torbenmehner/Masterarbeit/06_Zwischenvortrag/FZI-Beamer_Vorlage_Latex_v0.5/FZI-Beamer Vorlage Latex v0.5/paper.tex

\documentclass[18pt]{beamer}
\usepackage{templates/theme}

% title and author
	\title[Short title]{Herzlich willkommen!}
	\subtitle{Something for XYZ 2009}
	\author{Firstname1 Lastname1, Firstname2 Lastname2}

% configuration of slides
	\titlelogo{FZI-Logo}								% logo on title slide and normal slides
	%\titlelogo{none}
	\setboolean{normallogo}{true}				% show title logo on normal slides?
	\titlepicture{fzi-front}						% picture on title slide
	%\titlepicture{none}	
	\setboolean{nav}{true}							% show navigation bar?
	\setboolean{titlebar}{true}					% show green bar on title slide?
	\setboolean{normalbar}{true}				% show green bar on normal slides?
	\setboolean{normalcaptions}{true}		% show captions on normal slides?
	\setboolean{innBW}{true}						% show innBW logo on normal slides?
	\setboolean{minimalism}{false}			% minimalism mode? disables all the fancy things at once!

% biliography
	\addbibresource{bib.bib}

\input{templates/slide_config}

\begin{document}
% remove the following line for German date style
%\selectlanguage{english}
% uncomment the following line to set a fixed date
%\date{festes Datum}

%title page
\begin{frame}
\titlepage
\end{frame}
\section{Section1}
\subsection{}
\begin{frame}
\frametitle{Farben}
	Unterschiedliche Farben:
\begin{columns}

	\column{0.5\textwidth}
	\begin{itemize}
		\item \textcolor{fzi-green}{FZI grün}
		\item \textcolor{fzi-gray}{FZI grau}
		\item \textcolor{fzi-gray-hol}{HOL grau}
		\item \textcolor{fzi-foerververein}{Förderverein}
		\item \textcolor{fzi-control}{Smart Control}
		\item \textcolor{fzi-aal}{AAL}
		\item \textcolor{fzi-automotive}{Automotive}
	\end{itemize}
	
	\column{0.5\textwidth}
	\begin{itemize}
		\item \textcolor{fzi-mobile}{Mobile IT}
		\item \textcolor{fzi-robot}{Service Robotics}
		\item \textcolor{fzi-automation}{smartAutomation}
		\item \textcolor{fzi-energy}{smartEnergy}
		\item \textcolor{fzi-home}{smartHome}
		\item \textcolor{fzi-mobility}{smartMobility}	
	\end{itemize}

	\end{columns}

\end{frame}

\section{Section2}
\subsection{}
\begin{frame}
\frametitle{Title}
\begin{columns}
	\column{0.5\textwidth}
		$$\sum_{i=1}^{\infty} \frac{1}{4\pi x^i}$$

	\column{0.5\textwidth}
		\begin{itemize}
			\item two columns
		\end{itemize}
	\end{columns}
\begin{center}
\end{center}
\end{frame}

\begin{frame}
 \frametitle{Grafik einbinden}

 \begin{center}
  %\includegraphics[height=0.6\textheight]{logos/FZI-logo.pdf}
 \end{center}
\end{frame}

\begin{frame}
 \frametitle{Eine kleine TikZ Grafik}

 \begin{center}
 \begin{tikzpicture}
  \draw[darkgray, fill=fzi-mobility!50] (-1,0) .. controls +(2,0.3) and +(-2, -0.1) .. (5, 4) node[midway, sloped, below] {arrival} -- (7.5, 4) -- (7.5, 0);
  \visible<2->{\draw[darkgray, fill=fzi-home!50] (1, 0) -| (1, 0.3) -| (2, 0.7) -| (2.5, 1.3) -| (3.2, 1.7) -| (4, 2) -| (5.5, 2.5) -| (6, 3.2) -- (7.5, 3.2) -- (7.5, 0);}
  \visible<2->{\node[darkgray] at(5, 1) {packed};}

  \draw[-latex] (-2, 0) -- (8, 0) node[below] {time};
  \draw[-latex] (-1.5, -.5) -- (-1.5, 4.5) node[very near end, sloped, above] {freight};
  \draw[thick, blue] (7, 4.5) -- +(0, -5) node[below] {STD};
  \draw[thick, blue] (5, 4.5) -- +(0, -5) node[below] {LAT};

 \end{tikzpicture}
 \end{center}
\end{frame}

\begin{frame}
 \frametitle{Textblöcke}

 \begin{block}{Block}
   lorem ipsum
 \end{block}
 \vspace{2.0ex}

 \begin{exampleblock}{Example Block}
   lorem ipsum
 \end{exampleblock}
 \vspace{2.0ex}

 \begin{alertblock}{Alert Block}
   lorem ipsum
 \end{alertblock}
 
\end{frame}

\subsection{}
\begin{frame}
\frametitle{Ein Literaturverweis}
\begin{center}
	Entropie~\cite{shannon48}
\end{center}
\end{frame}

\subsection{}
\begin{frame}
\frametitle{Ende}
\begin{center}
	fin.
\end{center}
\end{frame}

\section{Literatur}
\subsection{}
\begin{frame}
\frametitle{References}
\printbibliography 
\end{frame}

\end{document}
