torbenmehner/Masterarbeit/09_Ausarbeitung/sections/entwurf.tex

%% LaTeX2e class for student theses
%% sections/content.tex
%% 
%% Karlsruhe Institute of Technology
%% Institute for Program Structures and Data Organization
%% Chair for Software Design and Quality (SDQ)
%%
%% Dr.-Ing. Erik Burger
%% burger@kit.edu
%%
%% Version 1.3, 2016-12-29

\chapter{Entwurf}
\label{ch:entwurf}

\section{Anforderungsanalyse}

\subsection{Sonarboot}

Die Aufgabe des Sonarboots ist es, möglichst genau einem Suchmuster zu folgen. Dazu muss es die aktuelle mit der gewollten Position abgleichen und den Fahrbefehl entsprechend anpassen.
