torbenmehner/Masterarbeit/09_Ausarbeitung/thesis.pdf

# 1. Einleitung

# 1.1. Stand der Technik

# 1.1.1. Sonarboot

Die Idee dieser Arbeit kommt aus der Wasserrettung. 66% aller Einsätze des DLRG Lan-

desverbands Württemberg im Wasserrettungsdienst sind Personensuchen im Wasser[1].

Für Gewöhnlich schwimmen Taucher dabei einen Bereich mithilfe von Suchmustern ab.

Aufgrund vieler Schwebeteilchen im Wasser ist die Sicht von Tauchern oft unter einen

Meter begrenzt, was die Suche verlangsamt. Doch bei einem Ertrinkungsunfall sinkt die

Überlebenswahrscheinlichkeit in jeder Minute, die ein Mensch unter Wasser ist [2, 3].

Daher läuft seit einigen Jahren die Ausstattung der DLRG mit Sonargeräten, die auch

bei schlechten Bedingungen einen großen Erfassungsbereich haben. Das beschleunigt die

Suche nach vermissten Personen wesentlich. Da das Sonar auf Einsatzbooten angebracht

ist, vergeht eine Menge Zeit bis zum Beginn der Suche. Der gesamte Slipvorgang dauert

mit Anfahrt der Slipstelle bis zu 15 Minuten.

Ein Weg die Zeit bis zum Einsatz des Sonars zu verkürzen, besteht in der Verwendung

eines unbemannten Fahrzeugs. Dieses muss lediglich groß genug sein, um das Sonar zu

transportieren. Daher kann es direkt an der Einsatzstelle zu Wasser gelassen werden, was

wertvolle Minuten spart.

Auf einer Wasseräche ist das Abfahren eines Suchmusters nur mithilfe eines GPS mög-

lich, weil es keine Anhaltspunkte zur Orientierung gibt. Doch auch mit GPS ist das Fahren

entlang des Suchmusters aufgrund von Wind und Strömung nur nach langer Übung zu

meistern. Deshalb soll das Sonarboot die Bereiche selbstständig absuchen.

# 1.1.2. SEC-Bike

Diese Arbeit wird am FZI geschrieben, welches sich im Forschungsbereich Mobilität un-

ter anderem mit Fahrassistenzsystemen beschäftigt. Da Kompetenz in diesem Themenbe-

reich vorhanden ist, werden hier auch Projekte mit autonomen Kleinfahrzeugen gestartet.

Eines dieser Projekte ist das SEC-Bike, welches vom Bundesministerium für Bildung

und Forschung beauftragt wurde. Dieses ist ein elektrisch betriebenes Lastenfahrrad, das

die Lücke der „Letzten Meile“im innerstädtischen Bereich schließt. Es kann vom Nutzer

per Smartphone an einen beliebigen Ort bestellt werden, zu dem es dann autonom fährt[4,

5].

# 1. Einleitung

# 1.2. Ziel der Arbeit

Anstatt zwei Systeme zu bauen, die beide autonom fahren, wird nun ein System entwi-

ckelt, das für beide Aufgaben verwendet werden kann.

# 2. Entwurf

# 3. Evaluation

# 3.1. First Section

# 3.2. Second Section

# 3.3. Third Section

# 4. Conclusion

# Literatur

# [1] DLRG LV Württemberg. Statistik des Wasserrettungsdienstes (WRD) Landesverband

# Württemberg 2017. url: https://wuerttemberg.dlrg.de/retten/einsatz/statistik-

lv-wuerttemberg.html.

# [2] D. Teising und H. Jipp. Neonatologische und pädiatrische Intensivpege: Praxisleitfaden und Lernbuch ; [jetzt mit pädiatrischer Anästhesiepege]. Springer, 2009. isbn:

9783540793229. url: https://books.google.de/books?id=ty460psq2B8C.

[3] M. Röggla u. a. “Wiederbelebung bei Hypothermie und Ertrinken”. In: Notfall & Ret-
tungsmedizin 4.7 (2001), S. 482–488. issn: 1434-6222. doi: 10.1007/s100490170012. url: https://doi.org/10.1007/s100490170012.
[4] Bundesministerium für Bildung und Forschung. SEC-Bike. url: https://www.technik-
zum-menschen-bringen.de/projekte/sec-bike.
[5] FZI. Mit automatisierten E-Bikes zur vernetzten Mobilität. url: https://www.fzi.

# de / aktuelles / news / detail / artikel / mit - automatisierten - e - bikes - zur -

vernetzten-mobilitaet/.

[6] Steen Becker, Heiko Koziolek und Ralf Reussner. “The Palladio Component Model

# for Model-driven Performance Prediction”. In: Journal of Systems and Software 82

(2009), S. 3–22. doi: 10.1016/j.jss.2008.03.066. url: http://dx.doi.org/10.1016/j.jss.2008.03.066.

# A. Anhang

# A.1. First Appendix Section

A gure

Fehlende

## Abbildung

Abbildung A.1.: A gure
