torbenmehner/Masterarbeit/03_Architektur/stromversorgung.pdf

Variabler
Buck Converter
(MIC2127A)

5V
Buck Converter
(MIC2127A)

3,3V
Linearregler
(LD1086D2M33TR)
