torbenmehner/Masterarbeit/06_Zwischenvortrag/aufgaben1.pdf

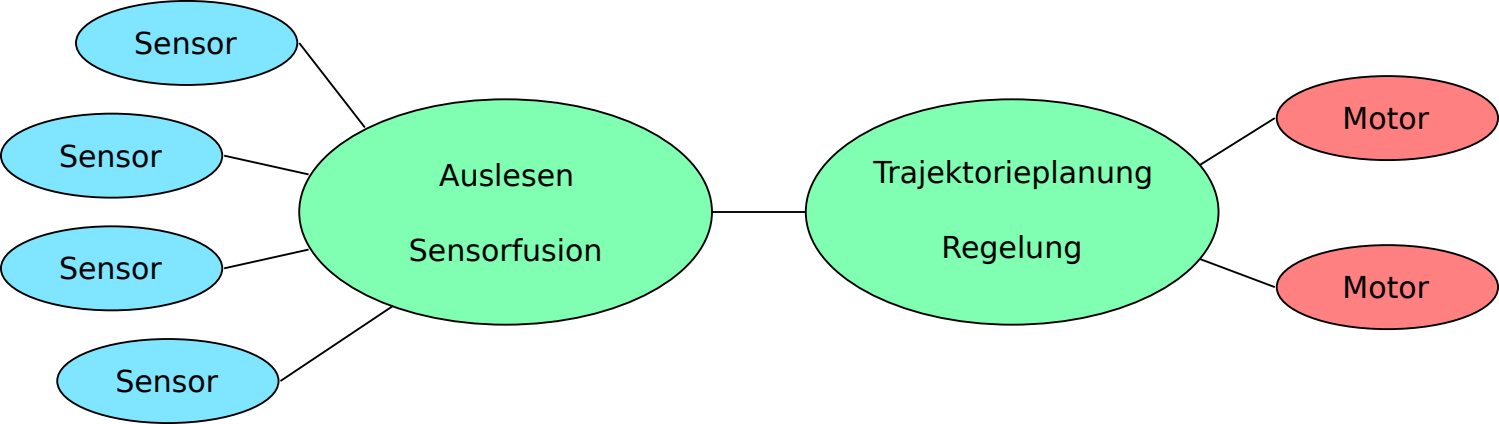
[picture p21: figure]
Sensor; Motor; Auslesen; Sensorfusion; Trajektorieplanung; Regelung
