torbenmehner/Masterarbeit/06_Zwischenvortrag/eva.pdf

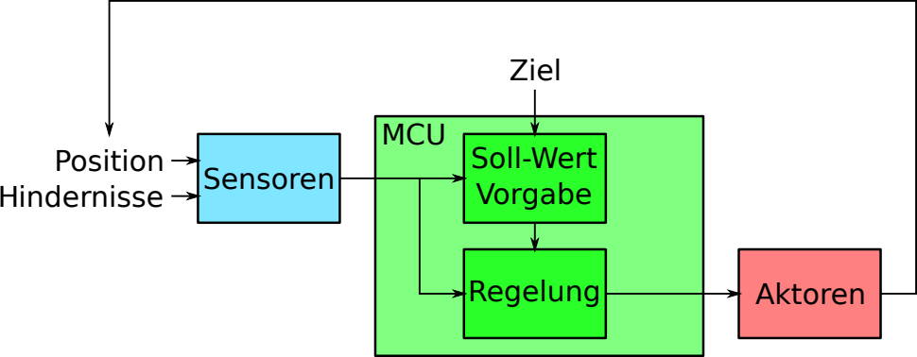
[picture p22: figure]
Sensoren; Regelung; Aktoren; Soll-Wert Vorgabe; MCU; Position Hindernisse; Ziel
