torbenmehner/Masterarbeit/06_Zwischenvortrag/gantt.pdf

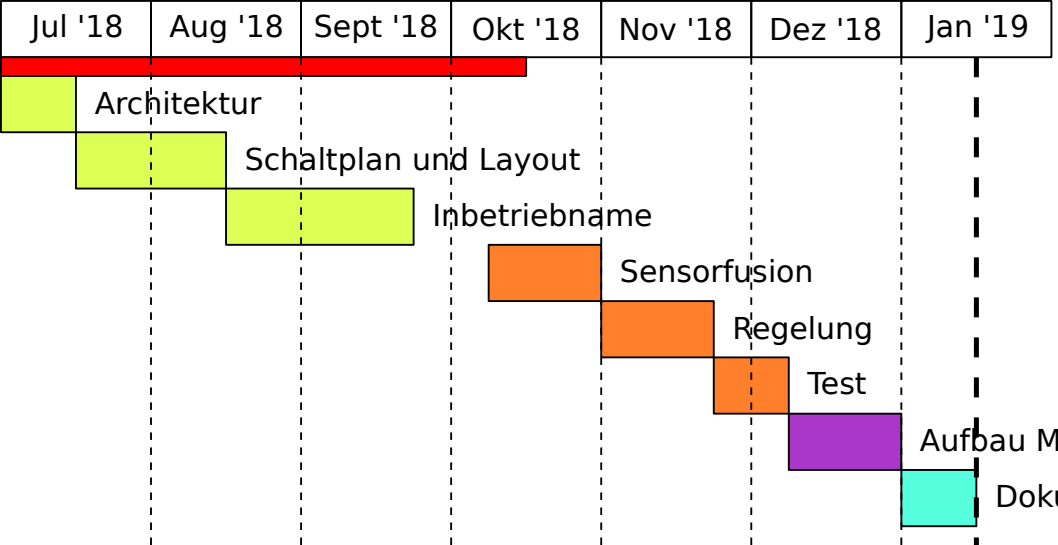
[picture p23: figure]
Architektur; Schaltplan und Layout; Inbetriebname; Sensorfusion; Regelung; Test

Jul '18 | Sept '18Aug '18 | Okt '18 | Dez '18Nov '18 | Jan '19

Aufbau Modellboot
Dokumentation
