torbenmehner/Masterarbeit/10_Papers/ASV_Final_Report.pdf

## Autonomous Surface Vehicle

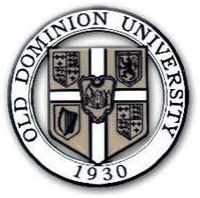
[picture p24: figure]

### Advisors

Dr. Gene Hou

### Student Team Members

Stanton Coffey, Matt Cline, Jack Nagle

Pat Grey, Sam Riahi

Abstract

The objective of our Autonomous Surface Vehicle is to compete in the annual ASVC,

Autonomous Surface Vehicle Competition, held every year in June at Founders Inn Resort in

Virginia Beach. The Mechanical Engineering team handles the design and construction of the

structural frame, boat hull, and mechanical components. While the Electrical and Computer

Engineering team handles the electronics, programming, and control systems. The competition

has us compete against other universities and colleges from around the globe and requires our

vehicle to complete various tasks and meet various requirements. These requirements include

weight and dimension constraints, under 140 lbs and under 3x6x3 respectively. Then the ASV

must perform tasks such as object recognition, avoidance, and navigation around buoys that

mark the course.

## Table of Contents

Abstract ------------------------------------------------------------------------------------------------------- 1

Table of Contents ------------------------------------------------------------------------------------------- 2

List of Figures ------------------------------------------------------------------------------------------------ 4

Introduction ------------------------------------------------------------------------------------------------- 5

1. Competition Guidelines ----------------------------------------------------------------------------- 6
1.1. Overall Guidelines ------------------------------------------------------------------------------ 6
1.2. Main Tasks ---------------------------------------------------------------------------------------- 6
1.3. Subtasks ------------------------------------------------------------------------------------------- 7
1.4. Scoring----------------------------------------------------------------------------------------------- 8
2. Assessment of previous years boat --------------------------------------------------------------- 9
2.1. Design Changes ---------------------------------------------------------------------------------- 9
3. Boat Structure ----------------------------------------------------------------------------------------- 10
3.1. Frame ---------------------------------------------------------------------------------------------- 10
3.2. Pontoons ------------------------------------------------------------------------------------------ 10
3.3. Frame Material ---------------------------------------------------------------------------------- 11
4. Propulsion System ------------------------------------------------------------------------------------- 12
4.1. Motor Selection --------------------------------------------------------------------------------- 12
4.2. Attachment of the Motors to the Frame ------------------------------------------------- 12
4.3. Blade Shields ------------------------------------------------------------------------------------- 12
5. Electrical Box ------------------------------------------------------------------------------------------- 13
5.1. Components -------------------------------------------------------------------------------------- 13
5.2. Technical Issues Faced ------------------------------------------------------------------------- 14
6. Waterproofing Efforts ------------------------------------------------------------------------------- 14
6.1. Waterproof Shield ------------------------------------------------------------------------------ 14
6.2. Waterproofing the Electrical Box ------------------------------------------------------------ 15
7. Cart ------------------------------------------------------------------------------------------------------- 15

7.1. Introduction -------------------------------------------------------------------------------------- 15
7.2. Design ---------------------------------------------------------------------------------------------- 15
8. Electronics and Components ----------------------------------------------------------------------- 17
8.1. Quick Camera Mounts ------------------------------------------------------------------------- 17
8.2. Computer Defragmenting --------------------------------------------------------------------- 17
8.3. Sonar Range Finder ----------------------------------------------------------------------------- 18
8.4. Water Cannon ----------------------------------------------------------------------------------- 18
9. Logic ----------------------------------------------------------------------------------------------------- 19
9.1. Vision and Logic Interface --------------------------------------------------------------------- 19
10. Testing Considerations ------------------------------------------------------------------------------ 22
10.1. Test Course ------------------------------------------------------------------------------------ 22
11. Team organization ------------------------------------------------------------------------------------ 22
11.1. Budget ------------------------------------------------------------------------------------------ 22
11.2. Schedule ---------------------------------------------------------------------------------------- 23

Conclusion --------------------------------------------------------------------------------------------------- 25

References -------------------------------------------------------------------------------------------------- 26

## List of Figures

Course layout ----------------------------------------------------------------------------------------- 6

Extinguish the Fire subtask diagram -------------------------------------------------------------- 7

Waterfall navigation subtask diagram ------------------------------------------------------------- 7

Scoring Criteria --------------------------------------------------------------------------------------- 8

Old ASV Boat ---------------------------------------------------------------------------------------- 9

Initial Boat Design Bottom View ------------------------------------------------------------------ 10

Picture of the Frame --------------------------------------------------------------------------------- 10

Initial Boat Design Side View ---------------------------------------------------------------------- 11

Electrical Box layout Old --------------------------------------------------------------------------- 13

Electrical Box Layout New ------------------------------------------------------------------------- 13

Waterproof Shield ------------------------------------------------------------------------------------ 14

Boat and Cart ----------------------------------------------------------------------------------------- 16

Logic Output Graph --------------------------------------------------------------------------------- 19

Logic Distance Formula ----------------------------------------------------------------------------- 20

Logic Output Chart ---------------------------------------------------------------------------------- 21

Buoys -------------------------------------------------------------------------------------------------- 22

Ghant Chart Modified ------------------------------------------------------------------------------- 23

Ghant Chart Original -------------------------------------------------------------------------------- 24

## Introduction

An Autonomous Surface Vehicle is a boat that can navigate, complete its tasks and operate by

its self without any human input or intervention. The purpose of this project is to design and fabricate

such a vehicle that is to be entered into the international ASV competition held in Virginia Beach, VA on

June 2011. In this contest teams from Universities from around the Nation and world must design and

build boats that can perform key tasks that have been outlined by the competition guidelines. Among

these key tasks are a speed test, thrust test, and navigation an obstacle course made of red, green, and

yellow buoys. Also part of the competition are four sub tasks made of identifying a single target from

others by temperature, aiming water cannon to hit a specific target, object retrieval from land, and

navigation under a water fall.

The ME senior design project team, will work in collaboration with students from the ECE

department to build a boat that can satisfy these requirements. The principle duties of the Mechanical

Engineering team consist of the design and construction of the frame, pontoons, cart, and motors, in

addition to the design and layout of the electrical box. Additional tasks that fall under the main tasks are

the mounting of cameras, GPS, compass, and any device that helps complete one of the subtasks also

are the responsibility of the Mechanical Engineering team. The Mechanical Engineering Team also took

charge of the Coding of the ASV's logic, vision, and object detection systems. Lastly testing of the boat is

also the responsibility of the Mechanical Engineering team, tests that map the capabilities of the boat

have to be evaluated to determine the final programming and responses of the boat.

### 1. Competition Guidelines

### 1.1 Overall Requirements

Overall requirements are requirements that every team's boat has to conform to, such as the size of

the boat, the weight of the boat, and special requirements such as a cart to lower it into the water. For

this year's competition all boats must be remote controlled and have a kill switch in case something

goes wrong. During the run communication with the vehicle is strictly forbidden with the exception of

the tasks that require the retrieval of a GPS location, or confirmation of a target. The dimensions of the

boat are not to exceed 3 feet by 3 feet by six feet, while the weight of the boat is not to be greater than

140 lbs. Every boat is also to have a cart or trailer to lower it down a ramp and into the water.

As of April the competition guidelines were updated to include a penalty for boats above 110 lbs

and to disqualify boats above 140 lbs.

### 1.2 Main Competition Tasks

There are three main mission tasks that all boats are graded on that make up the bulk of the

points for the competition. Among these tasks is a demonstration of the strength of the boat. Here each

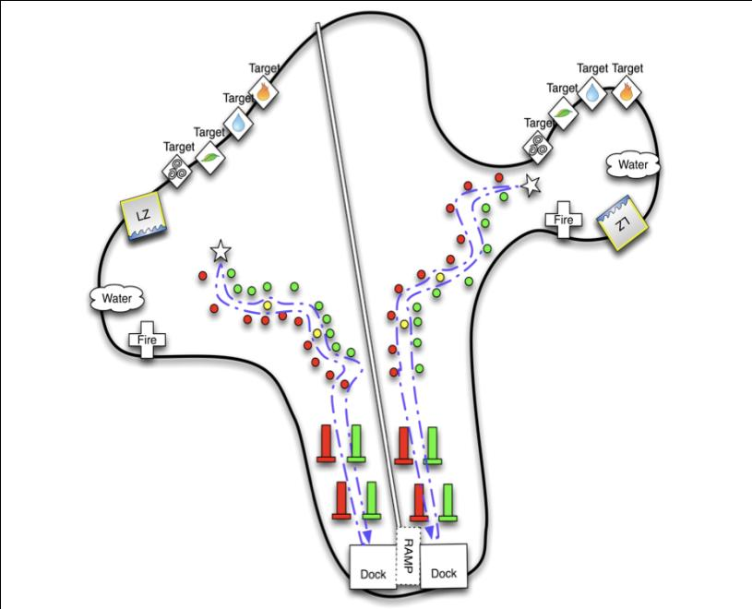
[picture p25: figure]

boat is hooked up to a thrust

measurement system. Each vehicle then

tries to generate as much thrust as

possible in 10 seconds. Each team has to

provide a harness so that two points on

the vehicle can be attached to the strain

gauge. The second main task is the

demonstration of the boats speed, here the vehicle leaves a starting gate and navigates a steady strait course to a speed gate where the time it

takes to get from one to the other is then recorded. The last major task is "navigation out of the harbor"

here each boat navigates a course of red, green, and yellow buoys. The red and green buoys serve as

gates were the boat has to navigate a winding course between each set while occasionally avoiding

obstacles represented by yellow buoys.

### 1.3 Subtasks

In addition to the three main tasks there are four challenge stations to be completed for bonus

points. The first and hardest of the four is the amphibious landing station where the boat has to retrieve

an object from land. The second task is to find and fire and extinguish it. In this task the boat has to

locate a mock up of a boat that has an elevated temperature from its surroundings. The vehicle must

then use a water cannon to spray enough water at a specific target on the boat to "extinguish" the fire.

Object detection and identification serves as the third task, here the boat must locate four targets

designated by elemental symbols and determine which one has an elevated temperature and thus

denotes the fire symbol. The final task has the boat navigate under a waterfall and locate a switch to

deactivate the waterfall.

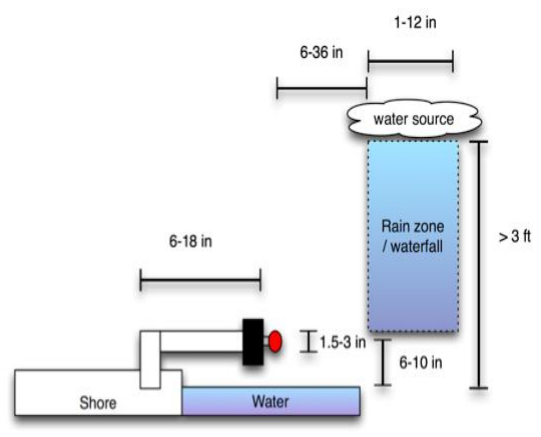
[picture p26: figure]
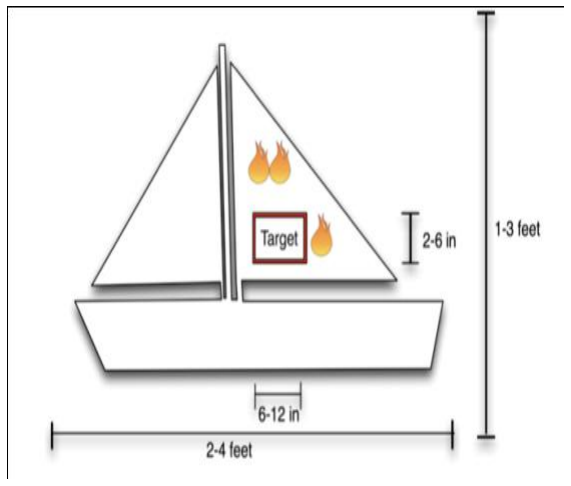
[picture p27: figure]

### 1.4 Scoring

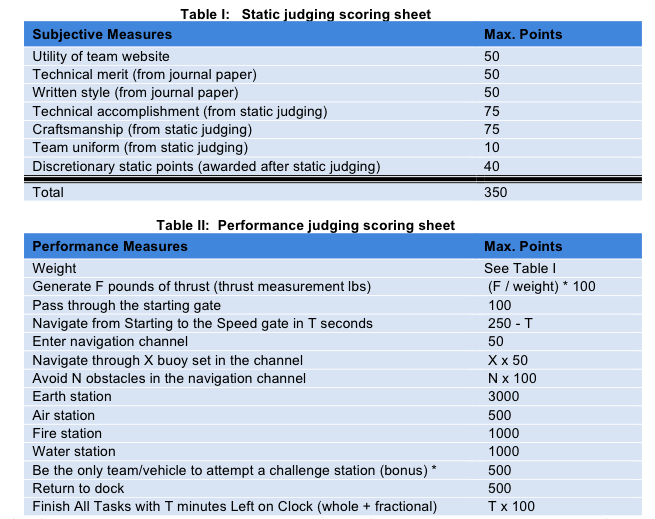
[picture p28: figure]

### 2. Assessment of Previous Year's Boat

### 2.1 Design Changes

The starting point of our project was an

evaluation of last year's boat. Last year's boat

featured a hull made of a single sheet of aluminum

that was bent for form the shape of two boat hulls

and contained a space inside for the electrical

components. In addition, the boat featured a single

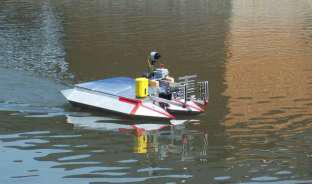
[picture p29: figure]

motor, water jet thrusters for steering and maneuverability, a single camera, and a robotic arm for

retrieval of a large ring from last year's competition. Necessary changes were decided upon that the

water jets used for maneuverability were too weak as was the use of only one motor. The aluminum hull

caused interference with the electronics, specifically the compass and GPS. Finally a single camera didn't

provide the field of vision necessary, which frequently resulted in the boat getting lost and wandering

off course. The decision was made to try for a modular hull to allow for flexibility, two motors for better

turning and power, and a minimum of two or three cameras.

### 3. Boat Structure

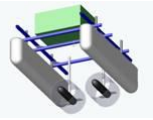
[picture p30: figure]

### 3.1 Frame

Going off of last year's boat it was decided to go

for a modular hull that featured two large pontoons for

stability and provide for a solid platform. Seeing as the

preliminary competition requirements were posted in

January every year we had to build a hull that allowed

for components to be easily moved around and adjusted

in the anticipation that more equipment would be added

to the boat later. This concept led us to the use of fiber

glass beams that had channels pre cut into them, so that

aluminum brackets could be easily bolted to the beams

via tabs that slid into the channel. From this we built a

rectangular frame made of these beams and connected

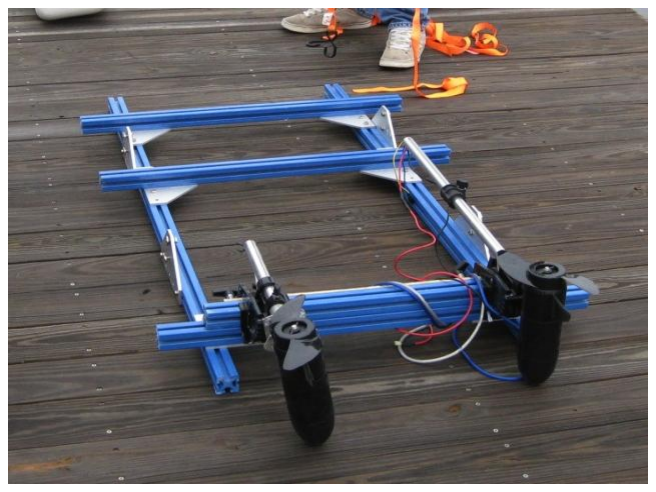
[picture p31: figure]

at the corners with aluminum brackets designed to accept bolts that could screw into the tab inserts. An

additional beam that roughly bisected the frame was attached to allow for anchoring the electrical box

at the front of the boat. The beam in the rear of the boat was then thickened with plywood and another

fiber glass beam to allow for the mounting of the twin motors.

### 3.2 Pontoons

The current pontoons are four feet long by six inches wide by eleven inches tall. They have just

barely enough buoyancy to hold the boat up and there is a possibility that we may add more weight to

the boat. So we have people from Elizabeth City State University building us more buoyant and stronger

pontoons. These new pontoons will be five feet long and ten inches in diameter. The extra one foot of length will add stability to the boat which at the

moment is a bit of a problem since the second the

motors turn on the boat rocks backward, then when the

motors turn off the boat tips forward. With an added

foot on the pontoons this should lessen the amount the

boat rocks forward or backward. The new pontoons are

hollow in comparison to the current pontoons, which have a foam core. This eliminates some weight,

which will allow us to possibly add more weight later if needed. The fiberglass used in the new pontoons

is also a better fiberglass then that used in the current pontoons, which will make them stronger then

our current pontoons.

### 3.3 Frame Material

The old pontoons made use of blue square fiberglass beams. These beams had a T-slot cut the

length of each side of the beam, which made mounting very easy and made it very adjustable. One

problem with the fiberglass beams is that they are really heavy. So we found on McMasterCarr.com

aluminum hollow square bars that are lighter than the current fiberglass bars on the boat. Each pontoon

will have two mounting legs extending fourteen inches out the top of the pontoons and ten inches of leg

extending into the pontoon for structural support. In total there will be eight feet of aluminum square

hollow bars between the two pontoons. The weight saved per foot of aluminum bar is 0.7 pounds. So

that’s a total saving of 5.6 pounds on the pontoons. We expect to have these pontoons by May 1st. The

decision to change frame materials wasn't expected to be made all other parts are completed and

attached which couldn't happen until mid May. However this decision was reached recently with the

release of the final competition rules at the end of April which induces a penalty on boats above 110 lbs.

### 4. Propulsion System

### 4.1 Motor Selection

Two Trawling motors with 30 lbs of thrust were selected for the project. The first motor came

off last year's boat while the second was purchased for the project to be the same at the first. These

motors were attached to the back of the boat by clamping on to a piece of plywood rather than the fiber

glass beams its self as it provided a better hold. The speed of these motors could be easily controlled

and varied which made them perfectly suited for our use. Later the motor from last year was removed

and a second motor was purchased. The old motor's pole was to short and delay issues were noticed

between the new and old motor.

### 4.2 Attaching the Motors to the frame

These motors attach easily to the frame via a mounting bracket attached to the motors but had

to be modified to always be locked in square with the frame. This was quickly realized during our first

water test, when the motors would cease to be parallel to one another and the boat frame while the

boat was turning. The combined force of the water on the boat, in combination of the motor against the

water, torqued the motors out of alignment. A simple solution to solve this involved drilling a hole into

the pole and the motor bracket and inserting a cotter pin. The hole had to be drilled carefully so as to

not drill into the wires.

### 4.2 Blade Shields

Shields are required for the competition to protect the propeller blades on our motors for safety

reasons. To do this two members of our team from the Project Management 1 class drew up a design on

Auto CAD. This design was of a circular guard similar to the one used during last year's competition, only

the new ones are split along the middle of them at the top. This was done so that they can be made out of one piece and attach to the motor's pole. These guards have connector pieces at the top and bottom

of them designed to attach them to the motor pole and the rudder fins on the motors. The guards have

been ordered from, and are currently being constructed by Norva Plastics. At first, $500.00 was said to

be the cost for the two guards, though Norva Plastics agreed to lower the price to $250.00 if they could

put their logo on the sides of them, which we happily agreed to. Once arrived, they will be put onto the

vehicle right away.

### 5. Electrical Box

### 5.1 Components

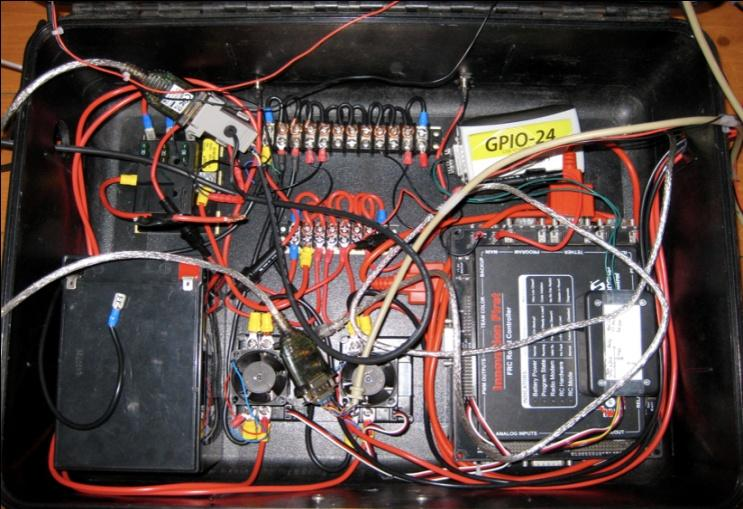
[picture p32: figure]

During our testing it was determined

that a rewiring of the electrical box was needed.

Inside this case are a FRC Robot Controller, a

GPIO-24 USB-IO interface adapter, a

12Volt/12Ah WKA12-12F2 Werker Battery, a

dual 35mm fan air-cooling system, a fuse box

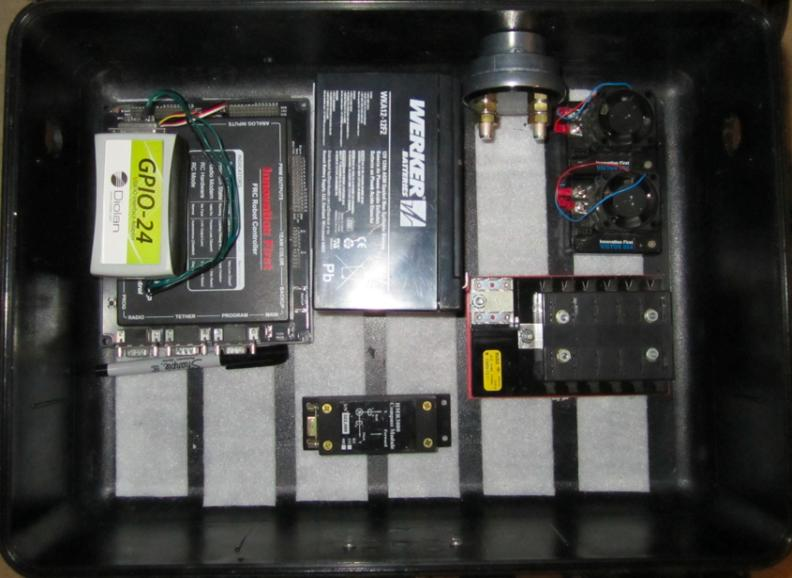
[picture p33: figure]

with 30amp fuses, and a laptop running the

autonomous program. To abide by the

competition regulations for safety, we have

installed an external kill switch on the box in the

case that we need to quickly turn off or disable

the ASV. Changes that we are still working on

included installing USB hubs and water-proofing

the electrical box. The USB hubs will connect our six external power-driven devices: the GPS, GPIO-24, Compass, two visual cameras, and one thermal

camera.

### 5.2 Technical Issues Faced

One of the changes we made to the box is the replacement of our previous 10 amp fuses that

had blown during our first test. Since we assessed that reducing the amperage load would not be

feasible, we decided to upgrade our fuses' capacities instead. In addition to new fuses, we have also

purchased a completely new fuse block; this allowed us to get rid of the distribution panels and clear up

excessive wiring and used space. We have also replaced our 14 gage wires with more suitable 10 gage

wires. At one point we were to use Kinect Cameras for the vision system but due to the camera not

being able to detect the infrared signal in the sun light. The idea was dropped in favor of Logitech

cameras that after testing were found to have good definition for our use and allow for the addition of

as many cameras as we need.

### 6. Waterproofing Efforts

### 6.1 Waterproof Shield

The waterproofing is a critical part to the survival

of our electronics. The waterproofing design had

to be built to accommodate three functions.

Firstly, it has to protect the electronics from water

damage. Secondly, this shield still needs to allow

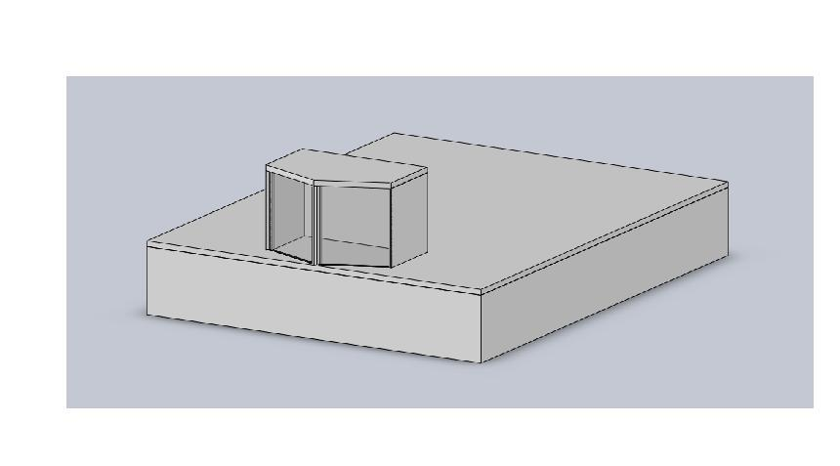
[picture p34: figure]

for adequate airflow to cool all electronics in the electrical box. Lastly, the Rain shield will be rainproof

camera mount. This rain shield will be placed on top of the existing lid of the electrical box. The original

lid to the electrical box has holes in it that allow for air to flow into and out of the box. So this rain shield will act as a new lid that won’t allow for water to get through. The cameras will be mounted in this

protective rain shield. At the moment the cameras will be mounted directly to the electrical box as

stated in the “quick camera mounts”.

### 5.4 Waterproofing the Electrical Box

In our old boat design, we had an unsealed hole for the kill switch and two 1 inch holes and two

.5 inch holes that we used to feed our wires from the electrical box to the motors and cameras. When

we were tasked with waterproofing our electrical box, we assessed that the ports on the sides of the

box will need to be sealed. In our new design, we plugged the side holes and sealed around them with

silicone caulk, drilled a 2 inch hole on top, screwed in a male and female pvc connecting tube on both

side of the lid of the box to feed the wires through, and caulked around the pvc tubes.

### 6. Cart

### 6.1 Introduction

According to the 2011 ASVC Mission rules, the autonomous surface vehicle must trailer

mountable for the purpose of launching the ASV into the water. There will be a ramp provided so the

ASV must also be secured to the trailer due the incline. Since the ASV will be launched by hand, not by

automobile, we were present with a task of making a cart. The cart will not be judged on any specific

criteria as long as there is a functioning trailer present.

### 6.2 Design

Keeping in mind of our team’s overall concept of modular design and keeping things simple we

set out designing our cart. There were a couple key design criteria that had to be taken into account

before any construction was started. First, the main and overall idea was that one person needed to be

able to move and launch the ASV without any help. Second, we wanted the cart to be able to fit in the back of the transport vehicle, with the ASV on top, without having to disassemble either device. Finally,

we wanted the cart to also serve as a platform for dry tests of the ASV. This would allow for minor

changes to be tested without actually having to launch the ASV in water. With these design aspects in

mind we started brainstorming about the actual geometry of our cart.

Keeping with the modular

design of this project, we decided to

utilize the same blue channel beams

that the ASV was constructed out of.

We still had plenty of this material on

hand so cost would not be an issue.

The maximum overall dimensions that

the ASV could be are 5ft by 3ft. So we

built a rectangular frame that is

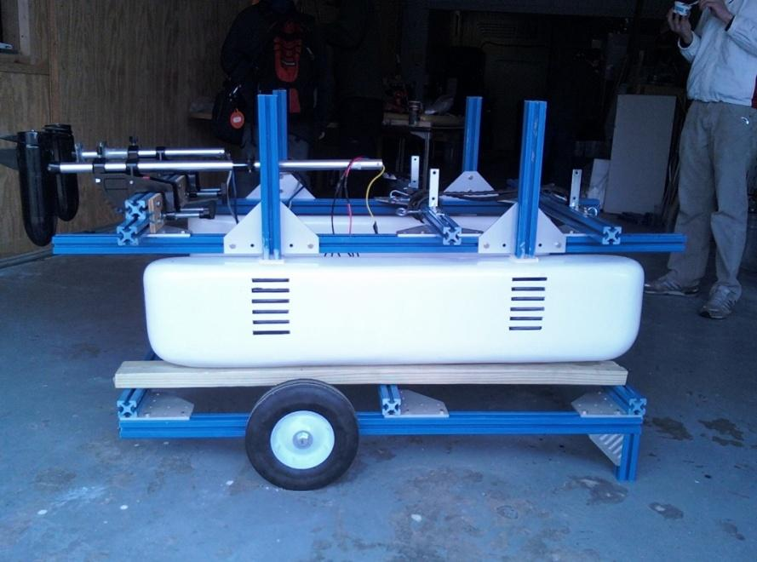
[picture p35: figure]

slightly over 3ft wide and is 4ft long. A slight overhang of the boat of the cart is not an issue. This can be

seen on many modern boat trailers. Two bunk, or boards, were bolt to the top of the frame so that ASV

would have a flat surface to rest on. This would eliminate at point stresses to the pontoons. This would

also allow for various pontoon designs to utilize the same cart design. There are a pair of straps for each

pontoon that are secured at one end to the frame, that then stretch over the pontoon and hook into the

other side of the cart. This is again a very simple, secure way to tie down varying pontoon designs. The

wheels obtained for the ASV cart are 10in diameter solid hard rubber wheels. They have built in bearings

and bushings. The wheels must be solid opposed to pneumatic so the cart would sink when launching

the ASV. The wheels were then through bolted on either side of the rectangular frame using 5/8in grade

five bolts. The holes for the bolts were drilled one-third the total length of the cart from the back in each

side rail of the cart. This gave the proper leverage needed to support the cart but still lift the front end.

The front end is supported by two vertical pegs when at rest. A simple handle was attached to lift the

front end when the cart needs to be moved. After looking at the finished product all design criteria were

either met or exceeded by this simple cart design.

### 7. Electronics and Components

### 7.1 Quick Camera Mounts

The boats cameras will be mounted inside a waterproof shield that will be mounted on the

electrical box. At the moment the waterproofing shield is not done so we need a quick way of attaching

the cameras so we can continue to do testing. We will be using two cameras on the boat and the size of

the base plate for each is one inch by one inch. We will take a piece of wood two inches by eight inches

to fix the cameras to. This wood plate will have Velcro on the side that will mount to the electrical box.

The reason for Velcro is because we want to be able to remove the camera plate easily so we can make

adjustments to the cameras in a lab without having to take the entire electrical box into the lab. The

cameras will be mounted to the wood plate by drilling two holes in the cameras base plate and into the

wood piece. This allows us to firmly fix the cameras to the wood plate so they don’t move, but gives us a

method for removing the cameras later for when we transfer them to the proper plate that will be used

with the waterproof shield.

### 7.2 Computer Defragmenting

Currently, all of the vehicle's operations are controlled using the coding written on the computer

located within the electronics box. Since the vehicle cannot function without this coding, the

computer's battery power is important. To help make sure that the computer will not lose power during

the competition, one of the group members will be removing excess programs running on the computer

in the background. This should not only improve the battery life of the computer, but improve the speed of it as well. Some of the other precautions being taken include configuring the power options of

the computer such as sleep mode, screen saver, and screen brightness settings. Properly configured,

the battery life of the computer should improve. The group member working on cleaning the computer

expects to finish doing so by early May.

### 7.3 Sonar Range Finder

One form of feedback to the boat will be the Range finder, which uses sonar technology. The

range finder basically uses the knowledge of the speed of sound to determine how far away an object is.

The range finder has two speakers on the front plate. One speaker will produce a sound that will

propagate outward from the plate until it hits the nearest object. When the sound wave hits an object it

will bounce back to the plate and be received by the second speaker. The time it takes for the sound to

travel from the first speaker out to an object and back to the second speaker can tell us how far away an

object is from the two speakers. To determine the distance we first must determine the speed of sound

in our environment. The speed of sound is determined from the equation sqrt(gamma*R*T). Since the

temperature varies we must recalculate the speed of sound when testing conditions change. We

calibrate this by placing an object a specific distance away from the speakers and record the time it

takes for the sound to reflect back to the speakers. We could also use this to determine the temperature

if we wanted to. After obtaining the correct speed of sound we can now use this to determine the

distance to objects at unknown distance away from the speakers. The current range finder is accurate

out to ten feet.

7.4 Water Cannons

One of the tasks that the vehicle will be required to complete, will be to spray water inside of a

rectangular hole that is 2-6 inches tall and 6-12 inches wide. The hole will have a red border around it

and be located within a 2-4 feet long and 1-3 feet tall boat prop. In order to complete this task, the vehicle must first find the desired target by distinguishing it from other objects on the course. To do

this, the red rectangular border will need to be noticed by our vehicle's two cameras using the c++ vision

coding. Once recognized by the program, it will allow power to be provided to one or two pumps, and

they will then spray the water. The bilge pumps removed from the vehicle used during last year's

competition will be reused for this year. The number of pumps that will be used is still being decided by

the two group members working on this task. These pumps will be located below the frame of the

vehicle within the water. They will be attached to a blue fiberglass beam that will be perpendicular to

the frame, and connected to it. From the pumps, clear rubber tubing with a nozzle at the ends will go

up to the frame of the boat above the water, and connect to it. The exact locations and how the hoses

and pump will be connected, as well as the coding for this task, are all still being worked out. The water

cannons should be working before the competition date, and are expected to be tested before June.

### 8. Logic

### 8.1 Vision and Logic Integration

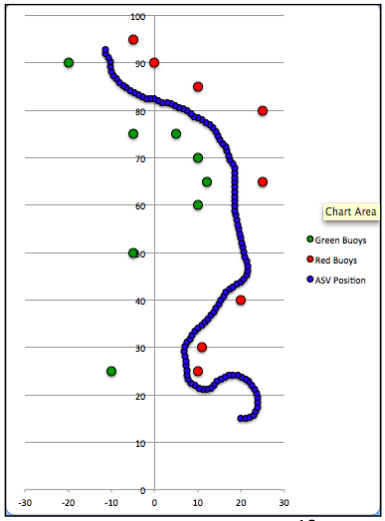
[picture p36: figure]

The Camera vision software uses C++ libraries written by

OpenCV. These functions give us an easy method of taking in

images from cameras mounted on the boat. The first thing the

code does is read in an image from each camera. The two

pictures are then combined to make one widescreen picture to

process. This picture is converted from RGB, red-green-blue,

format to HSV, hue-saturation-value format. HSV is an easier

signal to work with. The picture is then converted into four

pictures Red, Green, Blue and Yellow. The pictures are then put back together and go through a Hough Transform. This does a search through the picture for circles.

After this process we have now located the centers of all the buoys in the four colors we are searching

for. Next, we record the pixel row and the pixel column for the centers of each buoy in the picture

frame.

The logic now takes control. The first thing the logic does is sort out the buoys, because we

might get more than one buoy of the same color. The logic determines the closest buoys from the fact

that the closest buoy will appear lowest in the picture frame. After this step we will only have a max of

four buoys, one of each color. Next the buoy information gets sorted

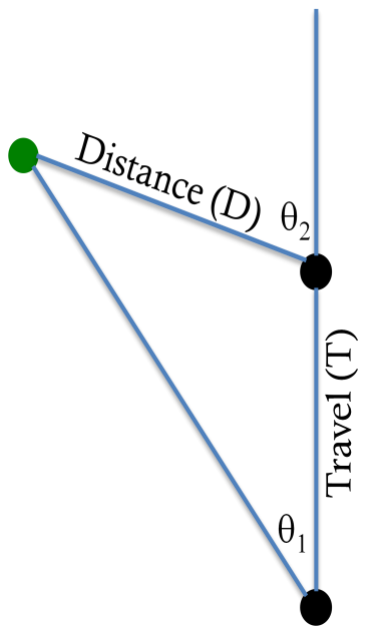
[picture p37: figure]

into one of sixteen scenarios. An example of the first scenario is if you

don’t detect a red green blue and yellow buoy, the last scenario is if

you can detect all four buoys in the same picture frame. Each scenario

will make various decisions based on the angles the buoys are from

straight ahead. When the logic has determined how the boat should

move it sets the duty-cycle for the motors to the proper level to get a

specific rotation or movement. This is updated on the next loop of the

code. This continues until the boat has reached the end of the

navigation channel, which is marked by a blue buoy.

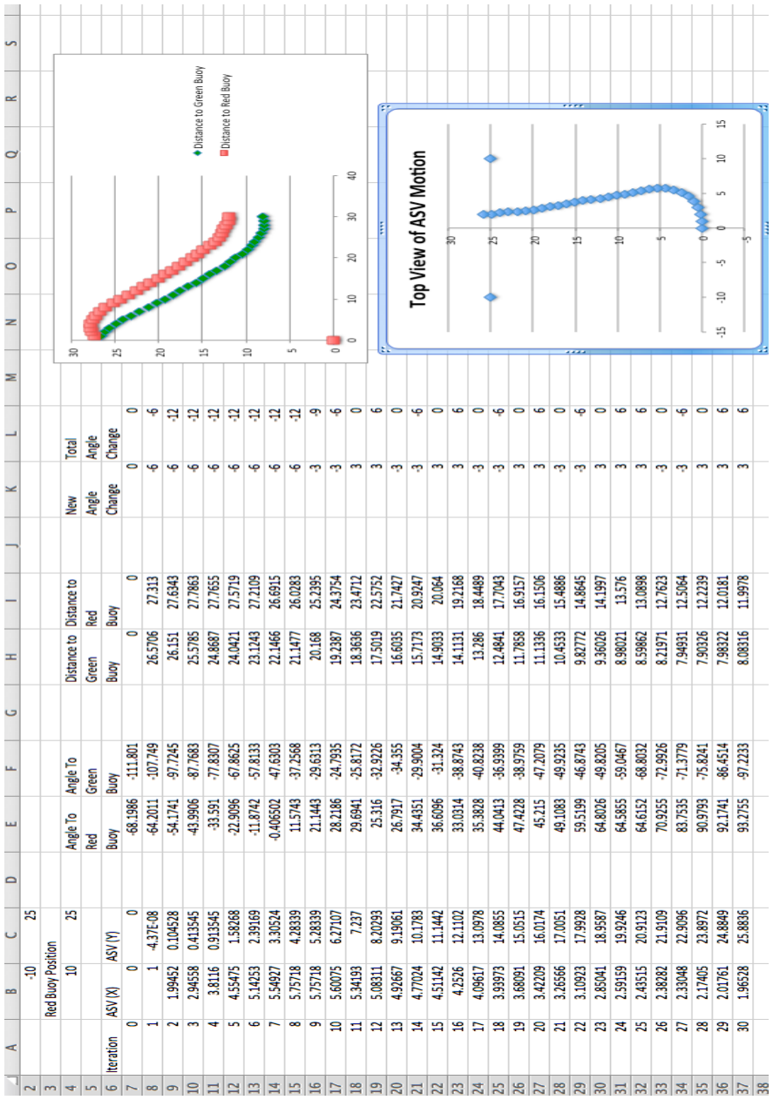
[picture p38: figure]

### 9. Testing Considerations

### 9.1 Test Course

To better prepare ourselves for the competition, a practice

course will be constructed. The course will contain all of the main

tasks and obstacles from the competition. This includes: red buoys,

blue buoys, yellow buoys, waterfall test, and a hot target. There are

several possible ways to go about doing this. For the buoys, the actual

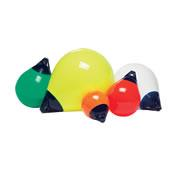
[picture p39: figure]

ones being used during the competition are given within the preliminary rules, so they could be

purchased. However, spending money on buoys that could be easily made from weighted down

balloons or painted cardboard cut-outs is not the best use of funding. For that reason, the buoys will

most likely be constructed by one of the before mentioned ways. As for the waterfall test, that could be

simulated by pouring water over the top of the vehicle. Nothing would be required except for buckets

or hoses, which can be easily obtained. And the hot target test would only require producing an area

with a high temperature. One of the group members not enrolled in ME435 is currently constructing a

test course to be used, and plans on having it completed early May.

### 10. Team Organization

### 10.1 Budget

At the beginning of the spring 2011 semester, we were informed that we had a starting budget

of $3000. This budget seemed very generous, especially since the two motors that we had purchased

during the previous semester were covered with departmental funds. As of April 24, we have spent just

under a thousand dollars and are expecting to spend a couple hundred dollars on the competition's

registration fees, so we are expecting to have $1860 left in our budget after the competition. Our big items were the Kinect cameras ($300) which ultimately did not work out for us, the potential frame

material upgrade($200) if we need to reduce any more weight, a third motor ($100) to replace one of

our first two motors, and motor shield ($250), which are required for the competition.

10.2 Schedule/ Gantt Chart

According to our proposed Gantt Chart, we planned to have our new pontoons from Elizabeth

City University installed and tested by mid March, upgrade our frame material by mid March, design and

mount the task-specific devices by mid April, and be done testing everything by mid April to beginning of

May. Realistically, we left a month of free time in between the competition and our last proposed event

for the case that any of these tasks ran over time. This extra month became necessary because we are

still waiting on our new pontoons, we have just started designing one of the task-specific devices, and

we decided to not upgrade the frame's material until we install all of the devices and test the ASV. On

top of the mechanical components of the ASV, we have tested the code from the electrical engineering

team and have assessed that their code is too flawed to work, so we have had to scratch their code and

build our own program. In addition to the program coding, we are still working on our vision detection

code, which is progressing rather well. Though we are behind on the schedule, we do not foresee any

problem with finishing our tasks and water-testing before the competition.

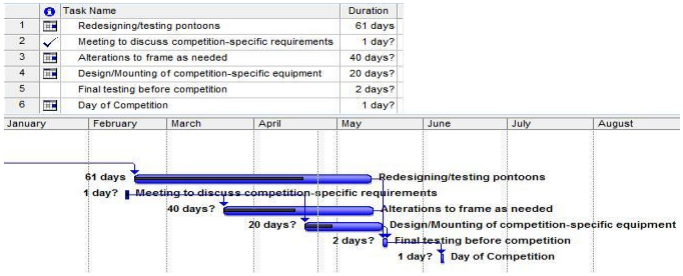
[picture p40: figure]

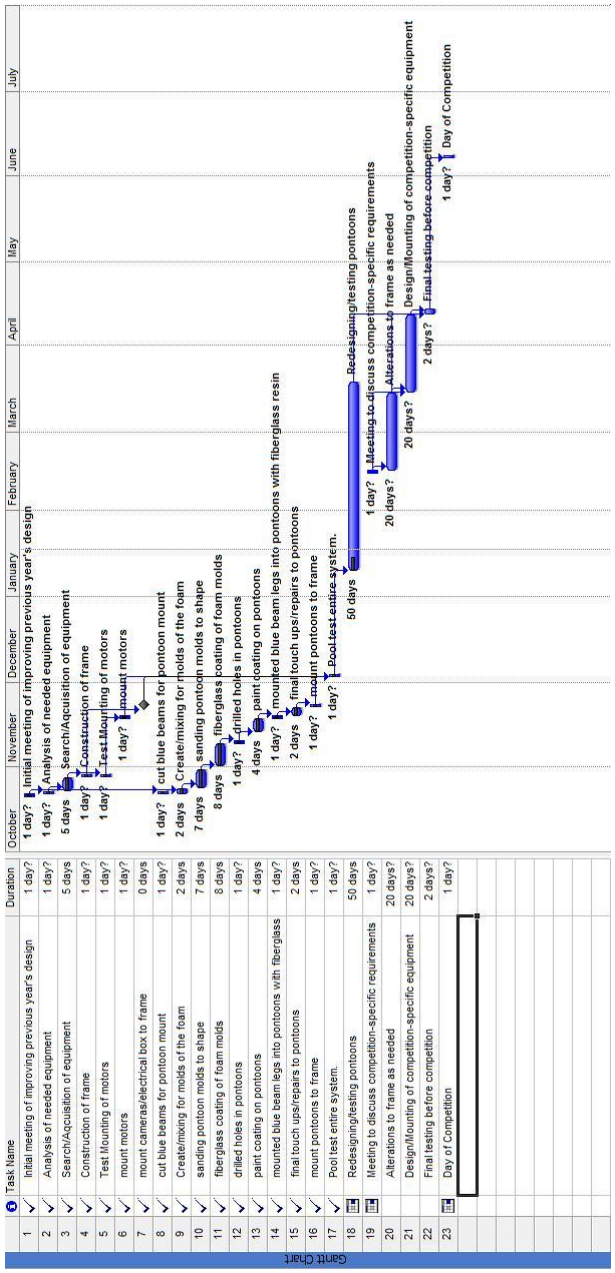
[picture p41: figure]

### Conclusion

The Project has fallen behind schedule by about a week due in part to the mechanical team

having to take on the duties originally assigned to the Electrical team. This has caused us to have to take

on the duties of working the logic, vision system, sonar detectors, and wiring of the electrical box. We

managed to not get terribly far behind due to aggressive recruiting on the part of our advisor and team

leader. As a result it will still be possible to produce a working boat come competition time. However,

various subtasks, such as the Amphibious landing, were not feasible to complete so they weren’t

perused. Instead we began the project with clear goals to achieve the main tasks and the sub tasks that

require little additional effort because they parallel existing tasks that must be completed for a

functioning boat, such as the waterproofing efforts. Hopefully next year's team will benefit from these

lessons and our modular design so more testing and improvement on the foundations of our design can

be made.

### References

1. "Preliminary Mission for the 2011 Annual ASVC",

http://www.auvsifoundation.org/AUVSI/FOUNDATION/UploadedImages/ASV_2011_Pre

lim_Rules.pdf.pdf, (http://www.auvsifoundation.org/AUVSI/FOUNDATION/UploadedImages/ASV_2011_Prelim_Rules.pdf.pdf) March 13th 2011.

2. Prowler® T30/30 Trolling Motor,

http://www.basspro.com/webapp/wcs/stores/servlet/Product_10151_-

1_10001_98206_225001001_225000000_225001000?cmCat=CROSSSELL_THUMBNAIL, (http://www.basspro.com/webapp/wcs/stores/servlet/Product_10151_-1_10001_98206_225001001_225000000_225001000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)

March 13th 2011

3. Norva Plastics, http://www.norvaplastics.com/, March 28th
4. McMasterCarr, http://www.mcmaster.com/#, April 05th
5. Polyform A Series Round Fenders / Buoys,

http://www.go2marine.com/product.do?no=22156F, April 05th
