torbenmehner/Masterarbeit/06_Zwischenvortrag/FZI-Beamer_Vorlage_Latex_v0.5/FZI-Beamer Vorlage Latex v0.5/templates/info.txt

%% LaTeX-Beamer template for FZI design
%% by Matthias Huber
%% improvements by Felix Brandt
%%
%% based on template for KIT design
%% by Erik Burger, Christian Hammer
%%
%% version 0.5
%%
%% Problems, bugs and comments to
%% huber@fzi.de
