torbenmehner/Masterarbeit/06_Zwischenvortrag/FZI-Beamer_Vorlage_Latex_v0.5/FZI-Beamer Vorlage Latex v0.5/paper.pdf

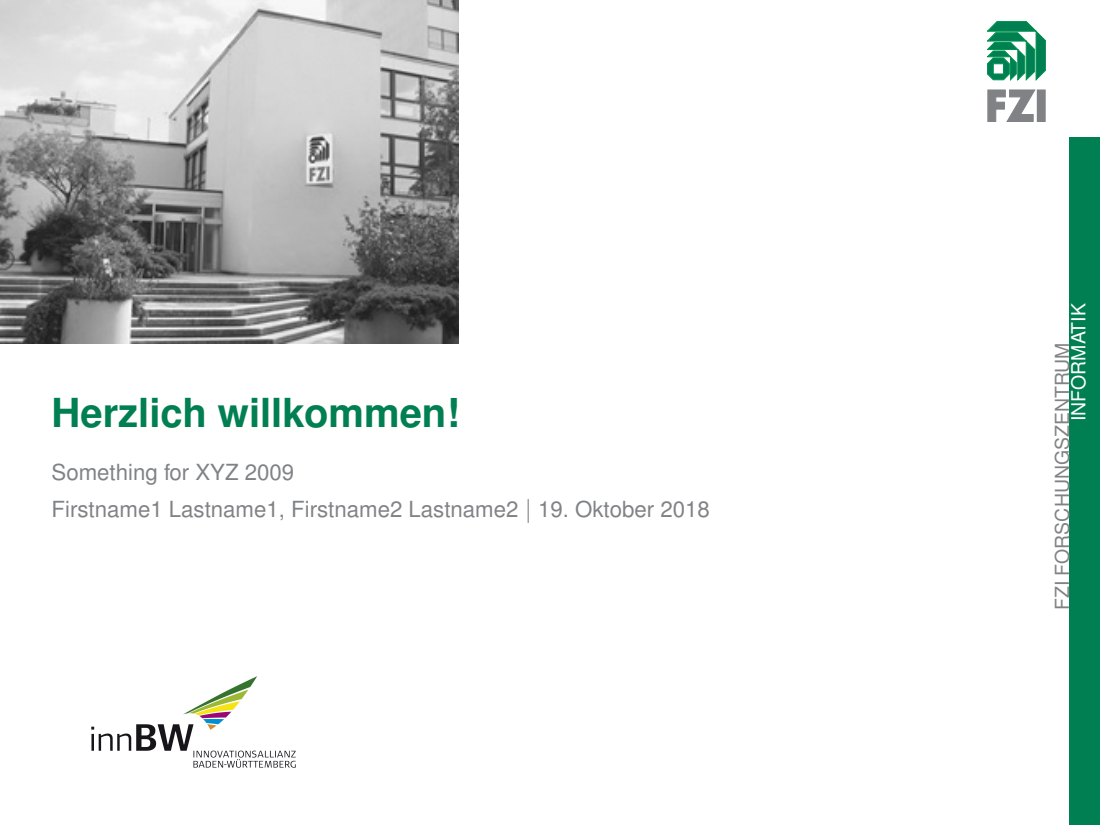
[picture p42: page 1]
Section1; Section2; Literatur; 19. Oktober 2018; Firstname1 Lastname1, Firstname2 Lastname2 – Short title; FZI FORSCHUNGSZENTRUM; Herzlich willkommen!; INFORMATIK

Something for XYZ 2009
Firstname1 Lastname1, Firstname2 Lastname2 | 19. Oktober 2018

# Farben

# Unterschiedliche Farben:

# FZI grun¨

# FZI grau

# HOL grau

# Forderverein ¨

# Smart Control

# AAL

# Automotive

# Mobile IT

# Service Robotics

# smartAutomation

# smartEnergy

# smartHome

# smartMobility

19. Oktober 2018 | Firstname1 Lastname1, Firstname2 Lastname2 – Short title | 1/8

# Title

X∞

i=1

1
4πx
i | two columns
19. Oktober 2018 | Firstname1 Lastname1, Firstname2 Lastname2 – Short title | 2/8

# Grafik einbinden

19. Oktober 2018 | Firstname1 Lastname1, Firstname2 Lastname2 – Short title | 3/8

# Eine kleine TikZ Grafik

# arrival

# time

# freight

LAT | STD
19. Oktober 2018 | Firstname1 Lastname1, Firstname2 Lastname2 – Short title | 4/8

# Eine kleine TikZ Grafik

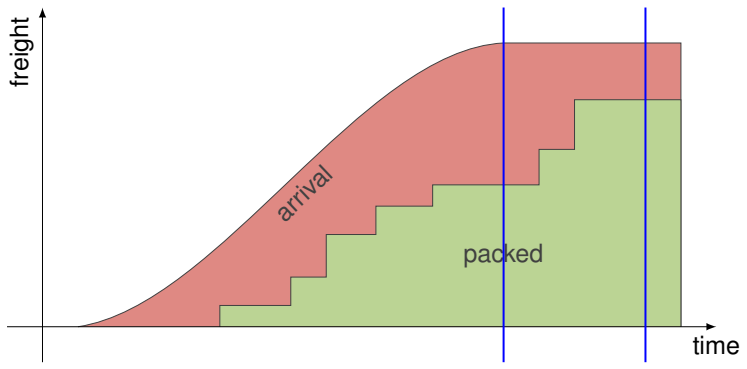
[picture p43: figure]
arrival; packed; time; freight

LAT | STD
19. Oktober 2018 | Firstname1 Lastname1, Firstname2 Lastname2 – Short title | 4/8

# Textblocke ¨

# Block

# lorem ipsum

# Example Block

# lorem ipsum

# Alert Block

# lorem ipsum

19. Oktober 2018 | Firstname1 Lastname1, Firstname2 Lastname2 – Short title | 5/8

# Ein Literaturverweis

# Entropie [shannon48]

19. Oktober 2018 | Firstname1 Lastname1, Firstname2 Lastname2 – Short title | 6/8

# Ende

fin.

19. Oktober 2018 | Firstname1 Lastname1, Firstname2 Lastname2 – Short title | 7/8

# References

19. Oktober 2018 | Firstname1 Lastname1, Firstname2 Lastname2 – Short title | 8/8
