torbenmehner/Masterarbeit/03_Architektur/gg_software_architecture.png

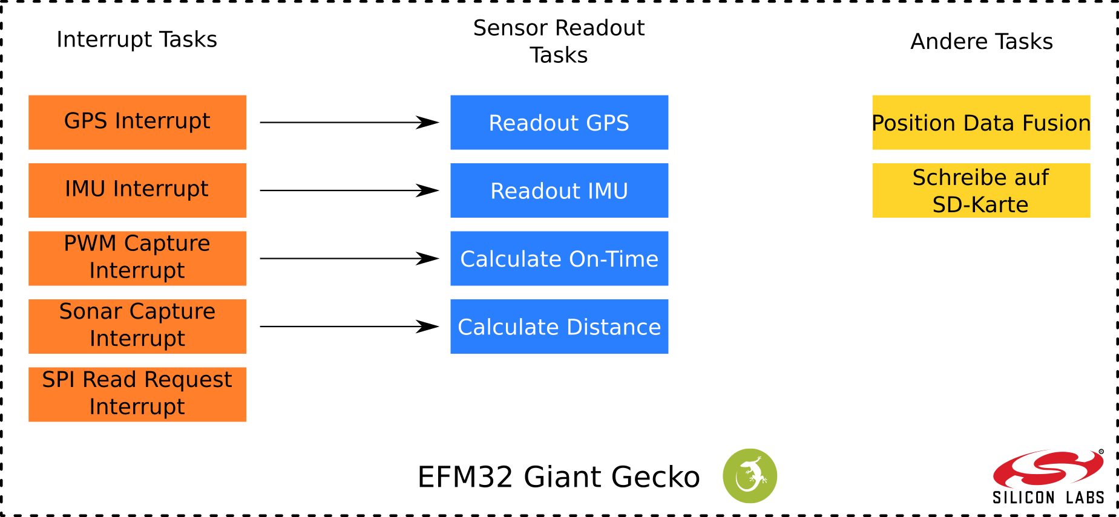
03_Architektur/gg_software_architecture.png
