torbenmehner/Masterarbeit/03_Architektur/psu.png

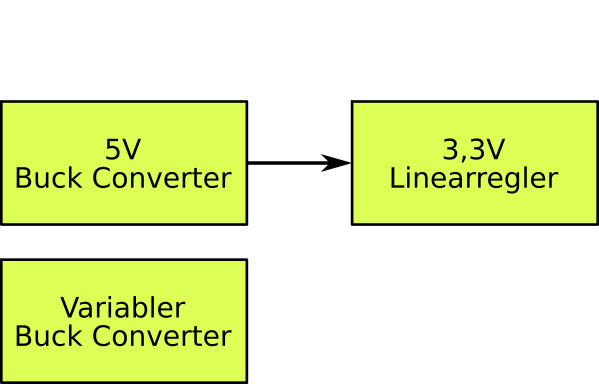
03_Architektur/psu.png
