torbenmehner/Masterarbeit/03_Architektur/spezifisches konzept.png

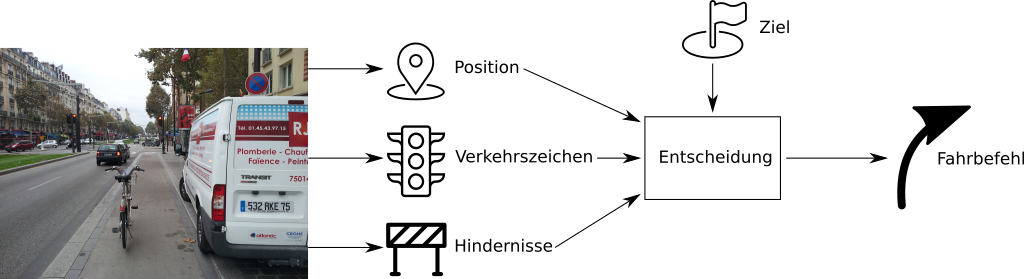
03_Architektur/spezifisches konzept.png
