torbenmehner/Masterarbeit/06_Zwischenvortrag/bno055.jpg

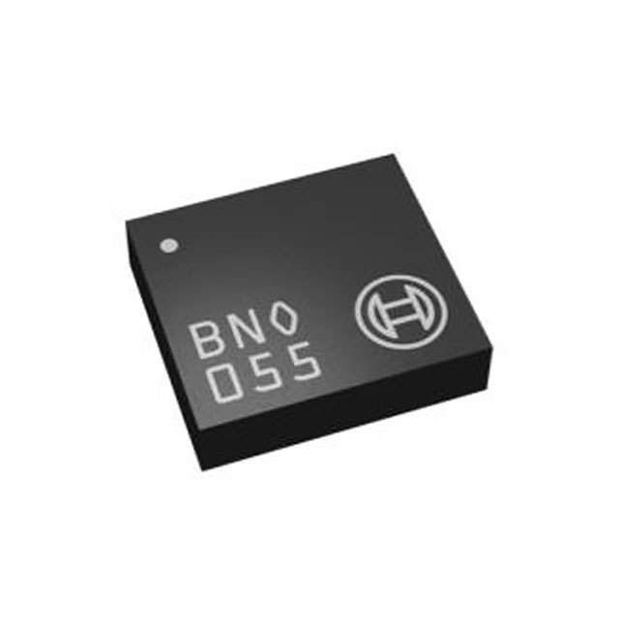
06_Zwischenvortrag/bno055.jpg
