torbenmehner/Masterarbeit/06_Zwischenvortrag/gps.jpg

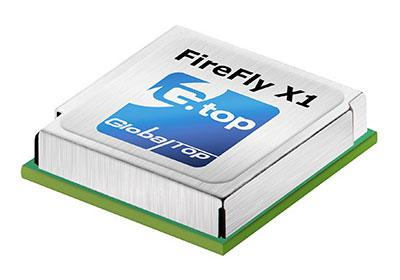
06_Zwischenvortrag/gps.jpg
