torbenmehner/Masterarbeit/06_Zwischenvortrag/platine2.jpeg

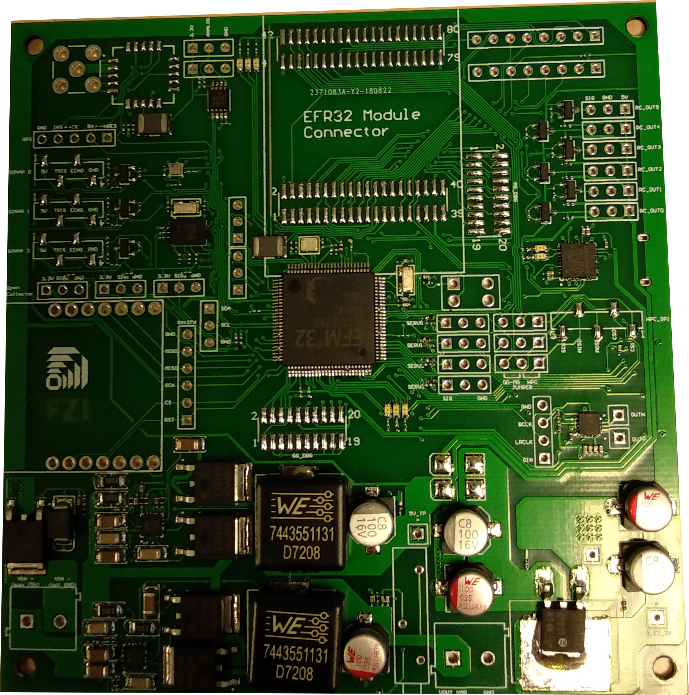
06_Zwischenvortrag/platine2.jpeg
