torbenmehner/Masterarbeit/07_Regelung/fuzzy-funktion.png

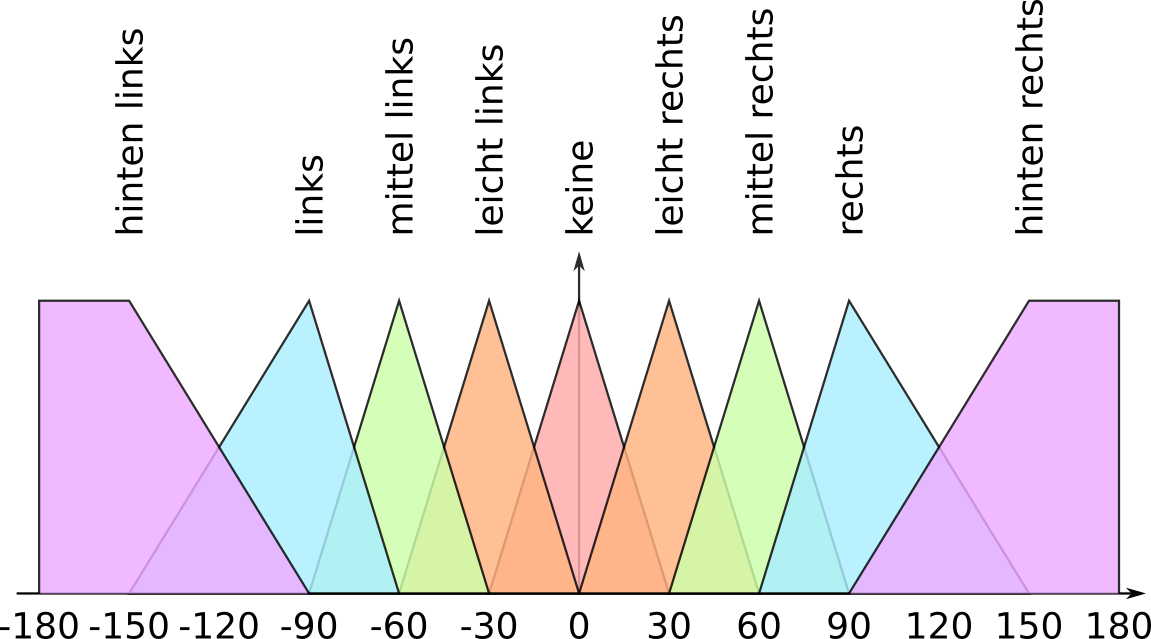
07_Regelung/fuzzy-funktion.png
