torbenmehner/Masterarbeit/07_Regelung/regelkreis.png

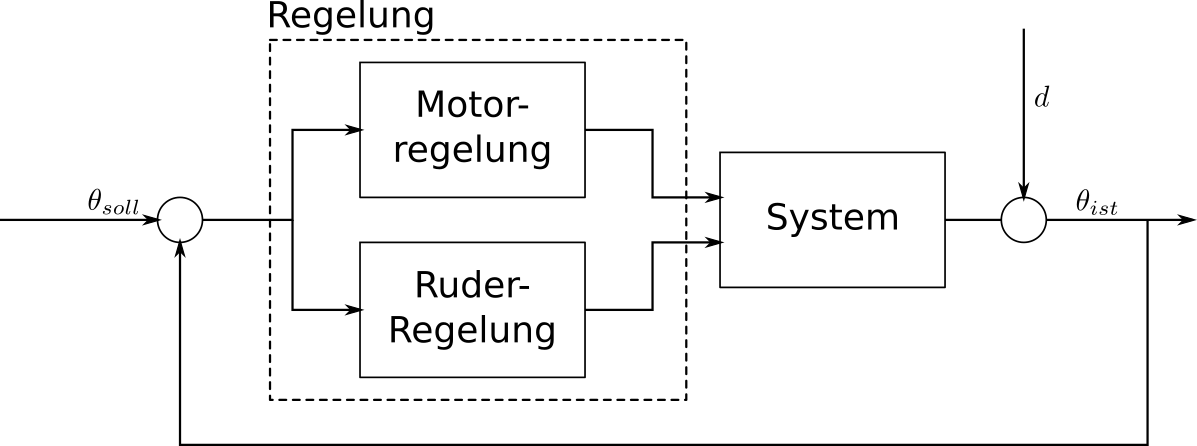
07_Regelung/regelkreis.png
