torbenmehner/Masterarbeit/Lieferung.ods

BASKET:16.05.2018 07:19:29
Mouser-Nr. | Herst.- Nr. | Hersteller | Kunden-Teilenr | Beschreibung | Lebenszyklus | Stückzahl | Preis (EUR) | Gesamtpreis: (EUR) | Vorhanden
667-25SVPF100M | 25SVPF100M | Panasonic |  | Organische Polymer-Aluminiumkondensatoren 25volts 100uF ESR 24mohm |  | 10 | 1,00 € | 10,00 € | Ja
710-885012207072 | 885012207072 | Wurth Electronics |  | Kondensator aus mehreren Keramikschichten MLCC - SMD/SMT WCAP-CSGP 100000pF 0805 10% 25V MLCC |  | 30 | 0,056 € | 1,68 € | Ja
710-885012007030 | 885012007030 | Wurth Electronics |  | Kondensator aus mehreren Keramikschichten MLCC - SMD/SMT WCAP-CSGP 22pF 0805 5% 25V MLCC |  | 4 | 0,082 € | 0,33 € | Ja
710-885012207033 | 885012207033 | Wurth Electronics |  | Kondensator aus mehreren Keramikschichten MLCC - SMD/SMT WCAP-CSGP 1000pF 0805 10% 16V MLCC |  | 10 | 0,029 € | 0,29 € | Ja
821-SK54BR4 | SK54B R4 | Taiwan Semiconductor |  | Schottky Dioden & Gleichrichter 5A,40V, SMD SCHOTTKY RECTIFIER |  | 3 | 0,583 € | 1,75 € | Ja
863-1SMB5931BT3G | 1SMB5931BT3G | ON Semiconductor |  | Zener-Dioden 18V 3W |  | 3 | 0,369 € | 1,11 € | Ja
603-RC0805FR-07100KL | RC0805FR-07100KL | Yageo |  | Dickfilmwiderstände - SMD 100K OHM 1% |  | 3 | 0,082 € | 0,25 € | Ja
71-CRCW0805220RJNEA | CRCW0805220RJNEA | Vishay |  | Dickfilmwiderstände - SMD 1/8watt 220ohms 5% |  | 10 | 0,029 € | 0,29 € | Ja
755-ESR10EZPJ103 | ESR10EZPJ103 | ROHM Semiconductor |  | Dickfilmwiderstände - SMD 0805 10Kohm 5% Anti Surge AEC-Q200 | Neues Produkt | 30 | 0,058 € | 1,74 € | Ja
71-CRCW0805J-4.7K-E3 | CRCW08054K70JNEA | Vishay |  | Dickfilmwiderstände - SMD 1/8watt 4.7Kohms 5% 200ppm |  | 10 | 0,034 € | 0,34 € | Ja
71-CRCW08052K20FKEB | CRCW08052K20FKEB | Vishay |  | Dickfilmwiderstände - SMD 1/8watt 2.2Kohms 1% |  | 10 | 0,045 € | 0,45 € | Ja
754-RR1220P-332D | RR1220P-332-D | Susumu |  | Dünnfilmwiderstände - SMD 1/10W 3.3Kohm 0.5% 25ppm |  | 10 | 0,041 € | 0,41 € | Ja
595-LM358ADR | LM358ADR | Texas Instruments |  | Operationsverstärker Dual Op Amp |  | 3 | 0,295 € | 0,89 € | 6 statt 3
927-A2235-H | A2235-H | Maestro Wireless |  | GPS-Module SiRFStarIV GPS receiver SMT ROM mod |  | 1 | 15,24 € | 15,24 € | Ja
262-BNO055 | BNO055 | Bosch |  | IMUs - Inertiale Messeinheiten Absolute Orientation 9-Axis Sensor |  | 1 | 8,68 € | 8,68 € | Ja
70-IHLP6767GZER330M1 | IHLP6767GZER330M11 | Vishay |  | Festinduktivitäten 33uH 20% 500KHz |  | 3 | 4,94 € | 14,82 € | Ja
695-CM315D-32.768YT | CM315D-32.768KDZY-UT | Citizen |  | Quarze 32.768KHz 7.0pF 20ppm |  | 2 | 0,697 € | 1,39 € | Ja
474-SEN-13959 | SEN-13959 | SparkFun Electronics |  | SparkFun Zubehör Ultrasonic Sensor HC-SR04 | Neu bei Mouser | 3 | 3,24 € | 9,72 € | Ja
474-DEV-14057 | DEV-14057 | SparkFun Electronics |  | Entwicklungsboards und Kits - ARM Teensy 3.6 | Neues Produkt | 1 | 27,72 € | 27,72 € | Ja
863-NTR5103NT1G | NTR5103NT1G | ON Semiconductor |  | MOSFET NFET SOT23 60V 310MA 2.5 |  | 10 | 0,095 € | 0,95 € | Ja
950-W550IO | WIZ550io | WIZnet |  | Ethernet-Module W5500 + Transformer and RJ45 |  | 1 | 15,76 € | 15,76 €
926-LM2596SX-5.0NOPB | LM2596SX-5.0/NOPB | Texas Instruments |  | Schaltspannungsregler 150 KHZ 3A STEP-DOWN VLTG REG |  | 3 | 3,90 € | 11,70 €
621-AP1117E33G-13 | AP1117E33G-13 | Diodes Incorporated |  | LDO Spannungs-Regulator LDO BI 1.0A 1.3V 12V 5.0V 3.3V FIX |  | 3 | 0,377 € | 1,13 € | Ja
583-BZX84C3V3-T1 | BZX84C3V3-T1 | Rectron |  | Zener-Dioden 3.3V |  | 10 | 0,097 € | 0,97 € | Ja
693-0031.8201 | 0031.8201 | Schurter |  | Sicherungshalter FUSE-HOLDER OGN |  | 4 | 0,48 € | 1,92 € | ja
845-30.604 | 30.604 | Altech |  | Feste Anschlussblöcke AK300/4 PC 45DegGry |  | 1 | 3,57 € | 3,57 €
845-30.602 | 30.602 | Altech |  | Feste Anschlussblöcke AK300/2 PC 45DegGry |  | 3 | 0,864 € | 2,59 €
