torbenmehner/Masterarbeit/04_Bauteile/ASBB.ods

Comment | Description | Designator | Footprint | LibRef | Quantity | Im Labor Vorhanden | Sample | Bei Mouser bestellt | Von Mouser geliefert
FireFly_X1_Multi-GNSS_Module | Dual system GNSS receiver Module, QFN-20 | B501 | X-1 | FireFly_X1_Multi-GNSS_Module | 1
100nF | Capacitor | C1, C2, C206, C207, C213, C214, C301, C302, C403, C404, C502, C601, C603, C607, C608, C609, C610, C611, C612, C615, C702, C704, C1402, C1405, C1506, C1507 | CAP 0402 | Capacitor | 26 |  |  | Ja
100nF | Capacitor | C201, C204, C1501, C1504 | CAP 1206/3216 | Capacitor | 4 |  |  | Ja
2.2�F X3 | Capacitor | C202, C1502 | CAP 1206/3216 | Capacitor | 2 |  |  | Ja
4.7�F | Capacitor | C203, C205, C1503, C1505 | CAP 1206/3216 | Capacitor | 4 |  |  | Ja
100�F | Capacitor, polarised, Capacitor, polarised, low ESR | C208, C209, C212, C1508 | CAP ALUM 6.6MM | Capacitor polarised, Capacitor polarised low ESR | 4 |  |  | Ja
10�F | Capacitor, polarised, low ESR | C210, C211 | CAP ALUM 6.6MM | Capacitor polarised low ESR | 2 |  |  | Ja
4.7nF | Capacitor | C215, C1509 | CAP 0402 | Capacitor | 2 | Ja
1�F | Capacitor | C216, C501, C602, C604, C1403, C1510 | CAP 0402 | Capacitor | 6 |  |  | Ja
22pF | Capacitor | C401, C402, C605, C606 | CAP 0402 | Capacitor | 4 | Ja
12pF | Capacitor | C613, C614 | CAP 0402 | Capacitor | 2 | Ja
4.7�F | Capacitor | C701, C703, C1401, C1404 | CAP 0402 | Capacitor | 4 |  |  | Ja
1nF | Capacitor | C1601 | CAP 0402 | Capacitor | 1 | Ja
FM5817-W | Diode | D201, D202 | SMB | Diode | 2 |  |  | Ja
Green, 3.2 V, 140� | WL-SMCW SMD Mono-color Chip LED Waterclear, size 0603, Green, 3.2 V, 140� | D601, D602, D603, D901, D902, D903, D1401, D1402 | WL-SMCW_0603 | 150060GS75000 | 8 |  |  | Ja
1SMB5929BT3G | Zener Diode / Varistor unipolar | D1601 | SMB | Diode Zener | 1 | Ja
MIC2127A | 75V, Synchronous Buck Controller Featuring ADaptive On-Time Control | IC201, IC1501 | MCHP-QFN-MG16_N | MIC2127A | 2
LD1086 | Semiconductors and Actives | IC202 | D2PAK_LD1086(Primary) | LD1086 | 1 |  |  | Ja
Giant Gecko in QFP100 |  | IC601 | TQFP100 | EFM32GG11B8xx | 1 |  | Ja
BRD4163A |  | IC901 | 80-Pin SiLabs Module | SLWRB4163A | 1 | Ja
SX1276 | Modtronix LoRa Transceiver | IC1301 | Modtronix inAir9 | Modtronix inAir9 | 1
CONSMA008 | SMA Female PCB Mount Connector - Extended | J501 | CON-SMA-L | CONSMA008 | 1 |  |  | Ja
Micro SD Card Connector, Push & Push | WR-CRD Micro SD Card Connector, Push & Push, with card detection | J601 | 693071010811 | 693071010811 | 1 |  |  | Ja
1.27 mm_SMD_Vertical_20 pin | Pin Header WR-PHD, pitch 1.27 mm, SMD, Vertical, dual row, 20 pin | J602, J901 | 62102021021 | 62102021021 | 2 |  |  | Ja
2.54 mm_SMT_Vertical_4 pin | Socket Header WR-PHD, Pitch 2.54 mm, SMT, Vertical, single row, 4 pin | J1101, J1102, J1103 | 61000411921 | 61000411921 | 3 | Ja
HPC SPI | Socket Header WR-PHD, Pitch 2.54 mm, SMT, Vertical, single row, 5 pin | J1201 | 61000511921 | 61000511921 | 1 | Ja
USB B |  | J1401 | FCI USB 10118193-0001LF | USB 2.0 Type B | 1 |  |  | Ja
691101710002 | Series 101 - 5.00 mm Horizontal Entry Modular with Pressure Clamp WR-TBL, 2 pin | J1501, J1601 | 691101710002 | 691101710002 | 2 |  |  | Ja
7443551131 | WE-HCI SMD Flat Wire High Current Inductor, size 1365, 10A, 13uH | L201, L1501 | WE-HCI_1365_WE-PERM | 7443551131 | 2 |  |  | Ja
WE 742792514 | Inductor | L501, L601 | 1812 | Inductor | 2 |  |  | Ja
Header 3 | Header, 3-Pin | P1, P2, P3, P4, P5, P6, P601, P602, P603, P1001, P1002, P1003, P1004, P1005, P1006, P1201, P1202, P1203, P1701, P1702, P1703 | HDR1X3 | Header 3 | 21
Header 5 | Header, 5-Pin | P501 | HDR1X5 | Header 5 | 1
Header 4 | Header, 4-Pin | P701 | HDR1X4 | Header 4 | 1
Header 8 | Header, 8-Pin | P801, P802 | HDR1X8 | Header 8 | 2
Header 6 | Header, 6-Pin | P1301 | HDR1X6 | Header 6 | 1
56k | Potentiometer | P1501 | Model 43 Trimmer | Potentiometer | 1
IPD180N10N3 G | N-Channel OptiMOS 3 Power-Transistor, 100�V VDS, 43�A ID, -55 to 175 degC, PG-TO252-3-11, Reel, Green | Q201, Q202, Q1501, Q1502, Q1601 | INF-PG-TO252-3-11_A_N | IPD180N10N3 G | 5
NTR5103N | N-Channel MOSFET SOT23 | Q1001, Q1002, Q1003, Q1004, Q1005, Q1006, Q1101, Q1102, Q1103 | SOT23 | NMOS SOT23 | 9
1k | Resistor | R1, R204, R301, R1504 | RES 0402 | Resistor | 4 | Ja
2.2k | Resistor | R2, R3, R6, R7, R1107, R1108, R1109 | RES 0402 | Resistor | 7 | Ja
3.3k | Resistor | R4, R5, R8, R9, R1110, R1111, R1112 | RES 0402 | Resistor | 7 | Ja
100 | Resistor | R201, R601, R701, R1501 | RES 0402 | Resistor | 4 | Ja
1.3k | Resistor | R202, R1502 | RES 0402 | Resistor | 2 | Ja
7.5k | Resistor | R203 | RES 0402 | Resistor | 1 | Ja
36k | Resistor | R205, R1505 | RES 0402 | Resistor | 2 | Ja
100k | Resistor | R206, R207, R1506, R1508 | RES 1206 | Resistor | 4 | Ja
1.2k | Resistor | R208 | RES 0402 | Resistor | 1 | Ja
10k | Resistor | R401, R402, R403, R404, R502 | RES 0402 | Resistor | 5 | Ja
470 | Resistor | R501, R503 | RES 0402 | Resistor | 2 | Ja
1 | Resistor | R602 | RES 0402 | Resistor | 1 |  |  | Ja
4.7k | Resistor | R603, R604, R801, R1001, R1002, R1003, R1004, R1005, R1006, R1007, R1008, R1009, R1010, R1011, R1012, R1101, R1102, R1103, R1104, R1105, R1106, R1701, R1702, R1703 | RES 0402 | Resistor | 24 | Ja
270 | Resistor | R605, R606, R607, R901, R902, R903, R1401, R1402 | RES 0402 | Resistor | 8 | Ja
NP | Resistor | R702, R1503, R1507 | RES 0402 | Resistor | 3
670k | Resistor | R703 | RES 0402 | Resistor | 1 | Ja
47k | Resistor | R1601, R1602 | RES 0402 | Resistor | 2 | Ja
SW-DPST | Double-Pole, Single-Throw Switch | S601 | DPST-4 | SW-DPST | 1 | Ja
MAX11645EUAT | Data acquisition IC - AD converter _ADC_ Maxim Integrated MAX11645EUA+ External , Internal uMAX 8 | U1 | 21-0036K | MAX11645EUAT | 1 |  | Ja
BMP388 | P-Sensor SPI I2C 1, 25 Bar SMD | U301 | PQFN50P200X200X80-10N | BMP388 | 1 | Ja
BNO055 | BNO055 9-axis Absolute Orientation Sensor _ SiP _ w/Sensors and Sensor Fusion | U401 | LGA28R50P4X10_380X520X100 | BNO055 | 1 | Ja
IC_Maxim_Electronics_MAX98357AETE+T_eec | IC Amplifier IC 2-Channel (Stereo) Class D 16-TQFN (3x3) | U701 | Maxim_Electronics_21-0896_0 | IC_Maxim_Electronics_MAX98357AETE+T_eec | 1 |  |  | Ja
CY7C65215-32LTXI | USB-Serial Dual Channel (UART/I2C/SPI) Bridge with CapSense(R) and BCD, 0.5 KB, 19 I/Os, 1.71 to 5.5 V, -40 to 85 degC, 32-Pin QFN (LTX32), Tray | U1401 | CYP-LTX32_N | CY7C65215-32LTXI | 1
ABS07-166-32.768KHZ-T | SMT Crystal | Y401, Y601 | ABRACON ABS07 | Abracon Crystal ABS06 | 2
ABM10W-48.0000MHZ-4-B1U-T3 | SMT Crystal | Y602 | ABRACON ABM10 | Abracon Crystal ABM10 | 1
