torbenmehner/Masterarbeit/09_Ausarbeitung/sections/evaluation.tex

%% LaTeX2e class for student theses
%% sections/evaluation.tex
%% 
%% Karlsruhe Institute of Technology
%% Institute for Program Structures and Data Organization
%% Chair for Software Design and Quality (SDQ)
%%
%% Dr.-Ing. Erik Burger
%% burger@kit.edu
%%
%% Version 1.3, 2016-12-29

\chapter{Evaluation}
\label{ch:Evaluation}

%% -------------------
%% | Example content |
%% -------------------
\dots

\section{First Section}
\label{sec:Evaluation:FirstSection}

\dots

\section{Second Section}
\label{sec:Evaluation:SecondSection}

\dots

\section{Third Section}
\label{sec:Evaluation:ThirdSection}

\dots
%% ---------------------
%% | / Example content |
%% ---------------------
