torbenmehner/Masterarbeit/Schematic ASBB.pdf

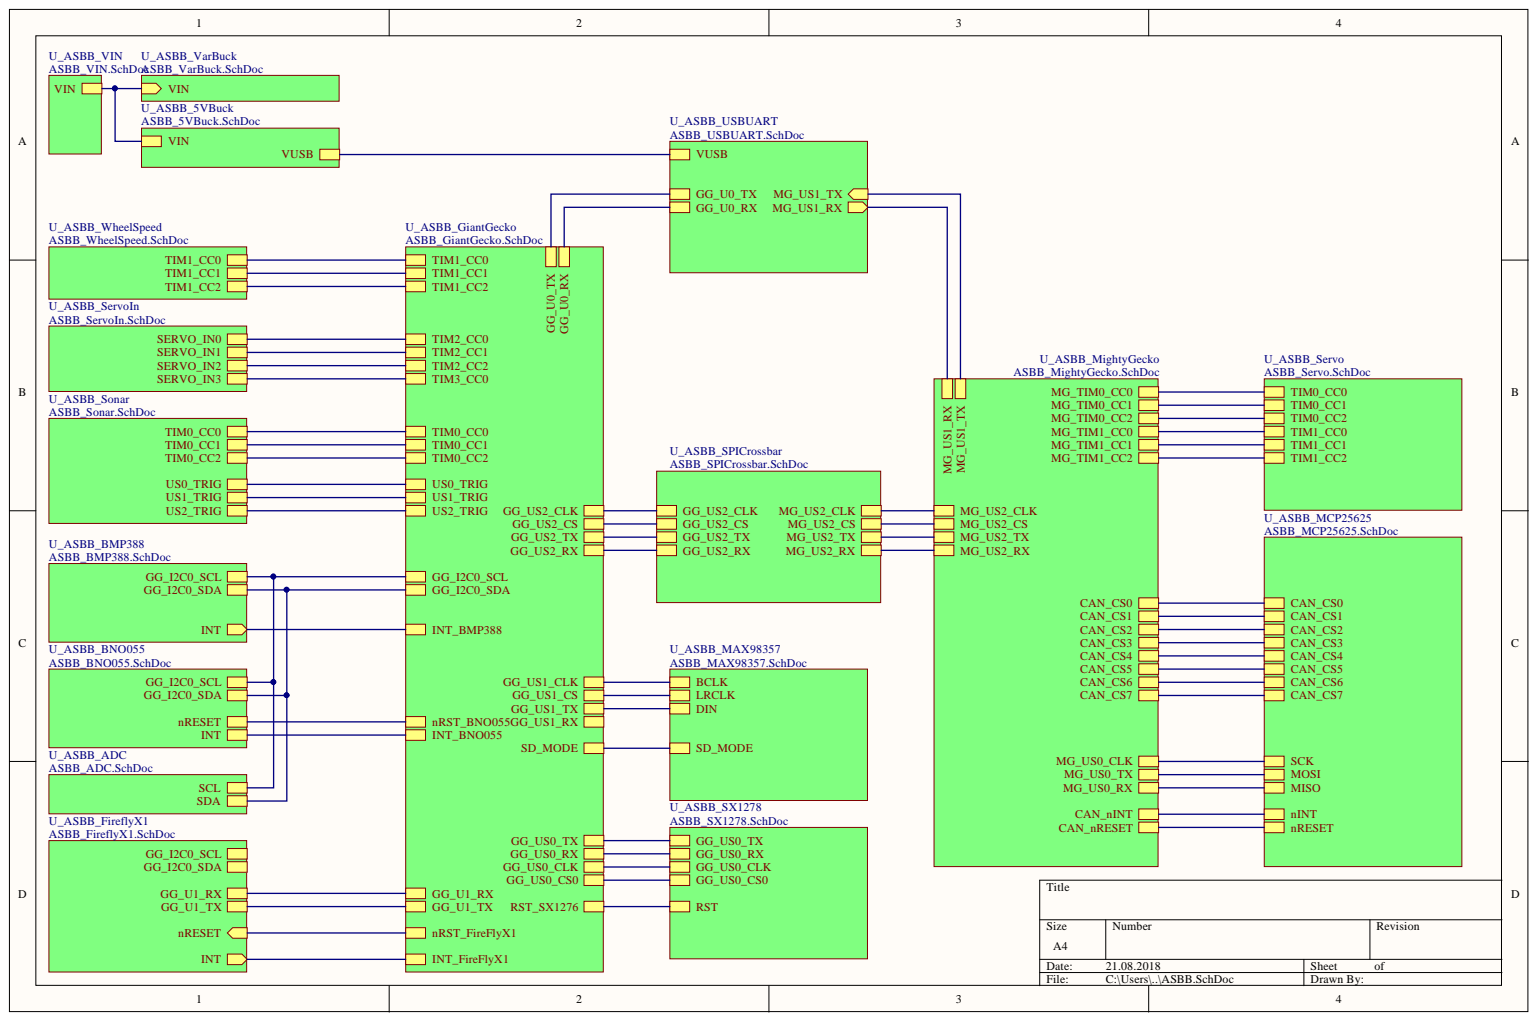
[picture p52: page 1]

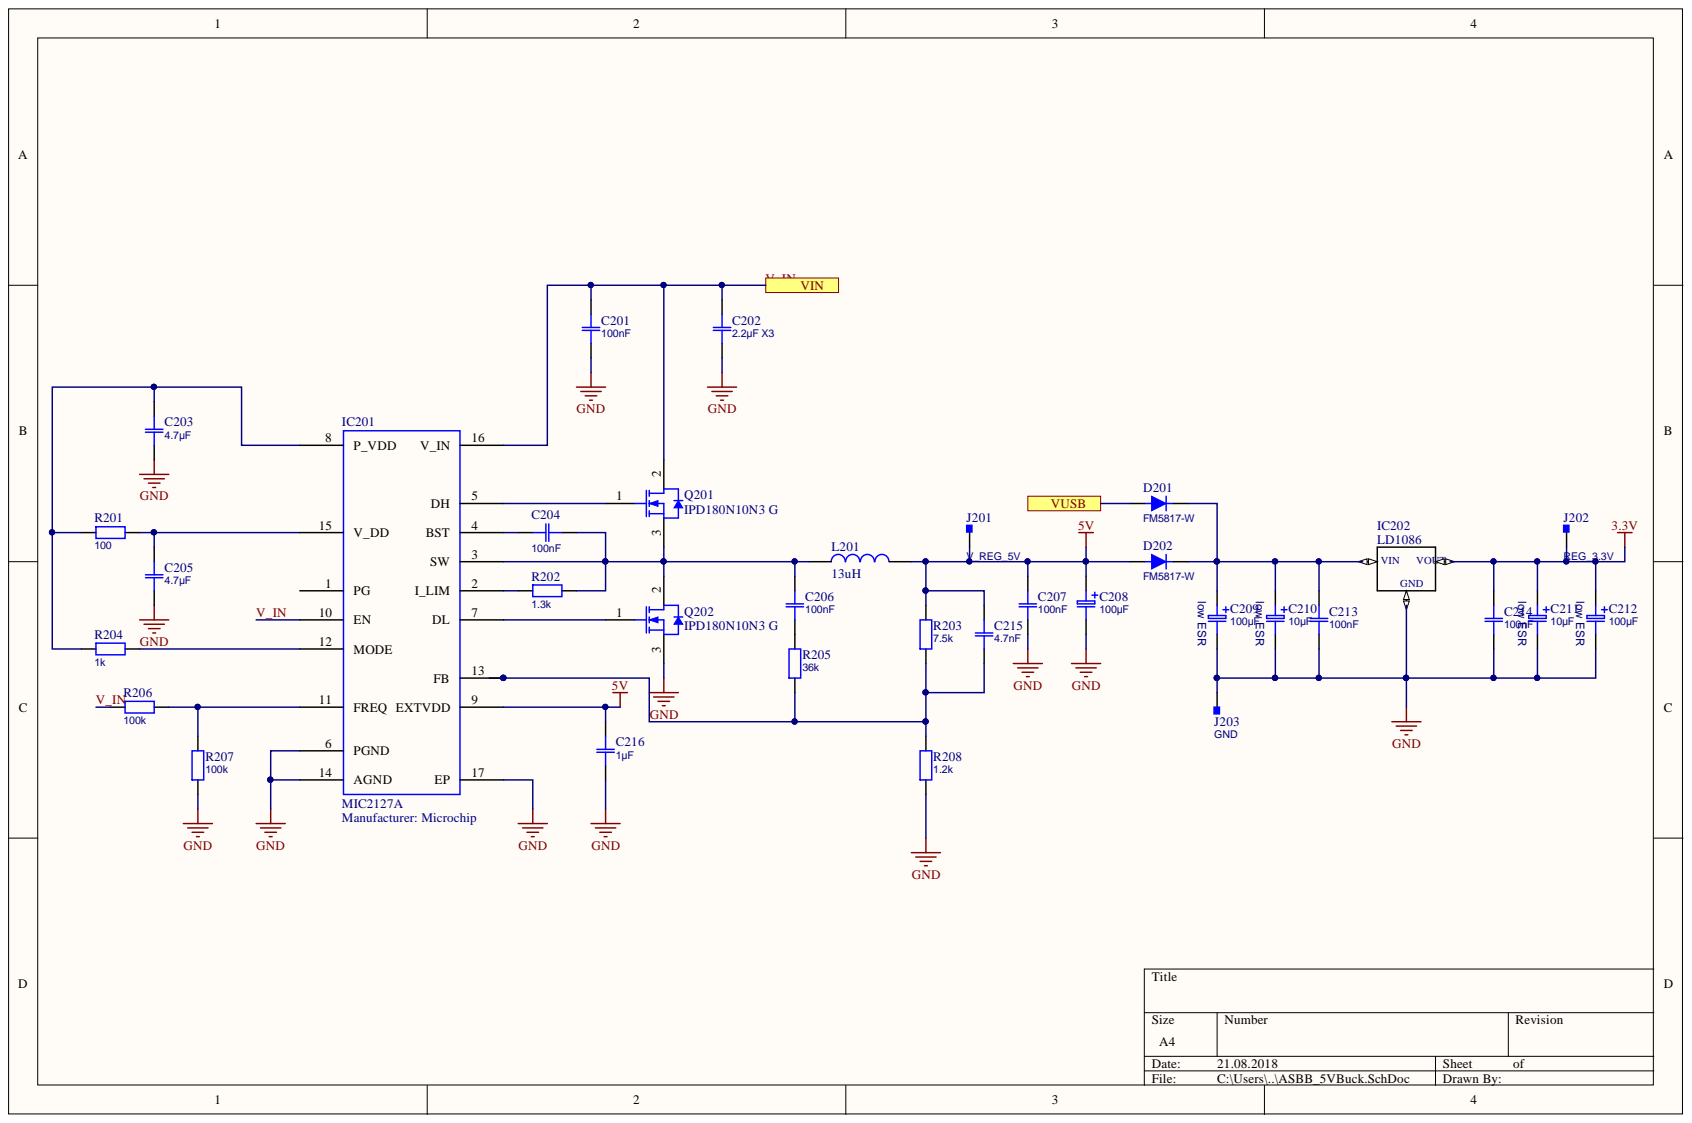
[picture p53: page 2]

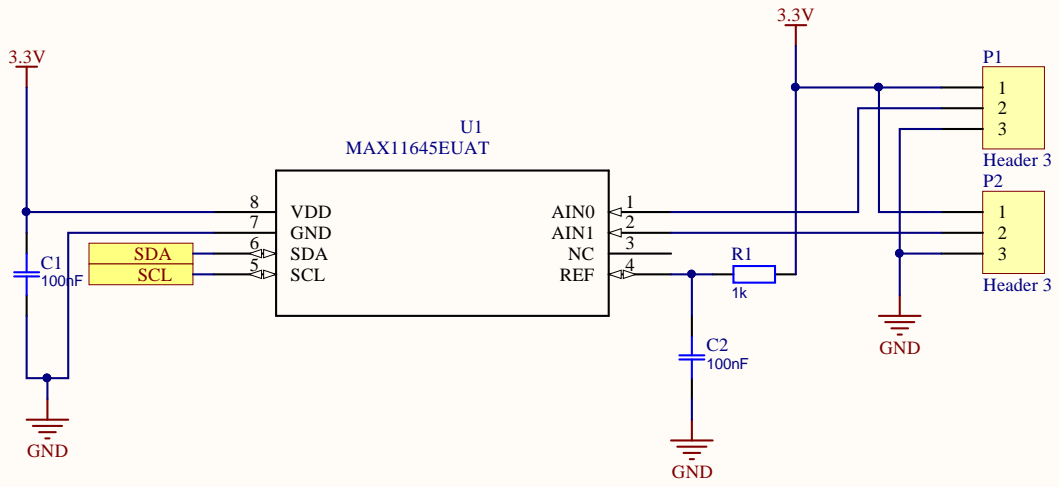
[picture p54: page 3]

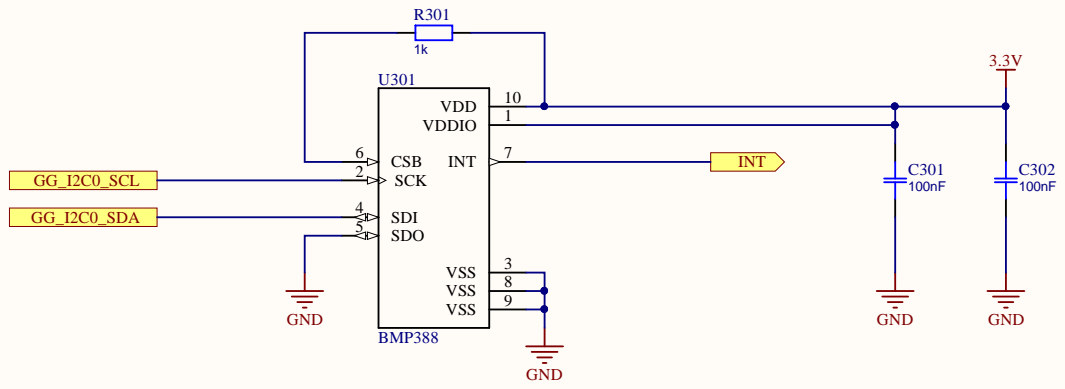
[picture p55: page 4]

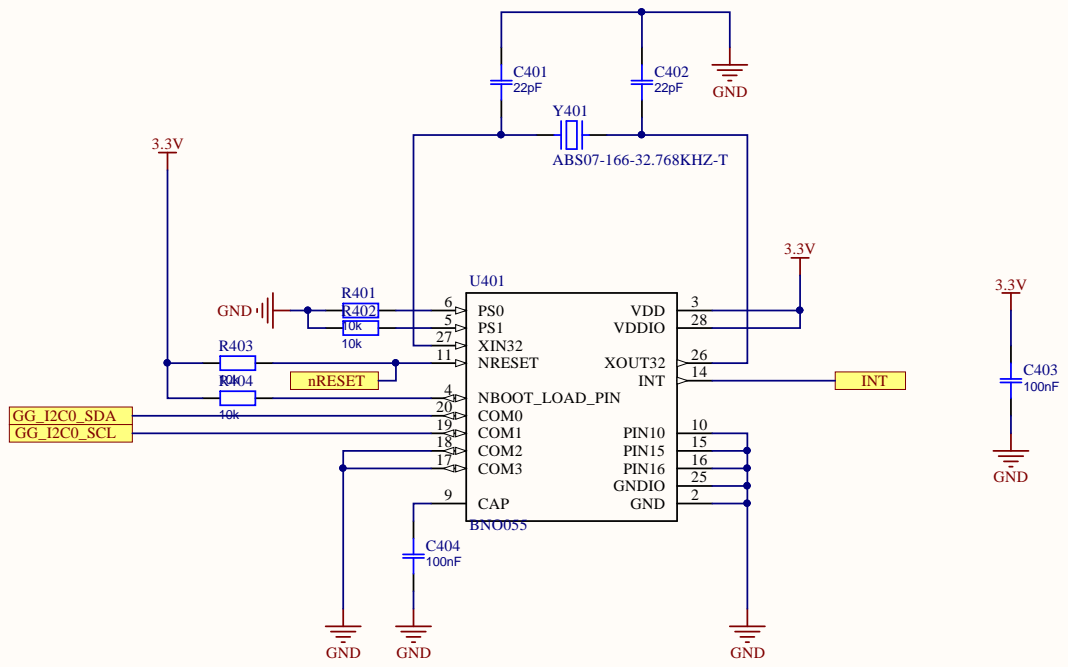
[picture p56: page 5]

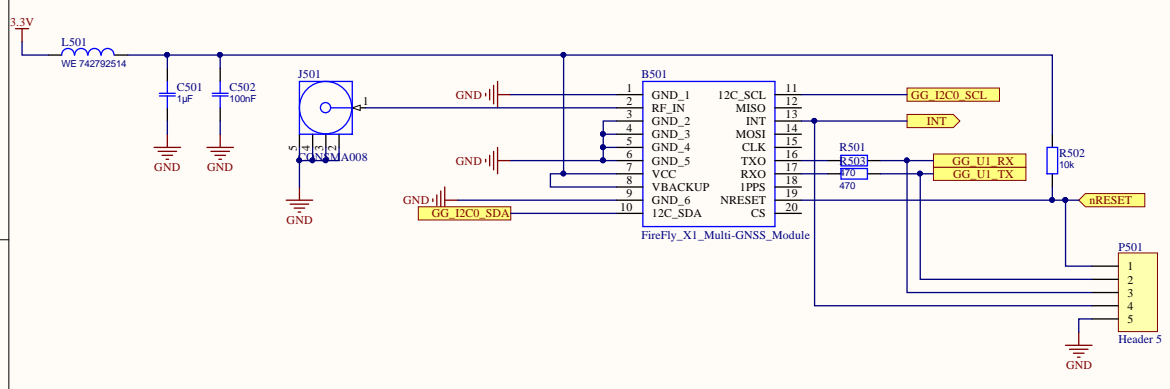
[picture p57: page 6]

GND_2 3

GND_4 5 CLK TXO RXO 1PPS NRESET | 15 16

VCC 7 | 17
VBACKUP 8 | 18 19

GG_I2C0_SDA

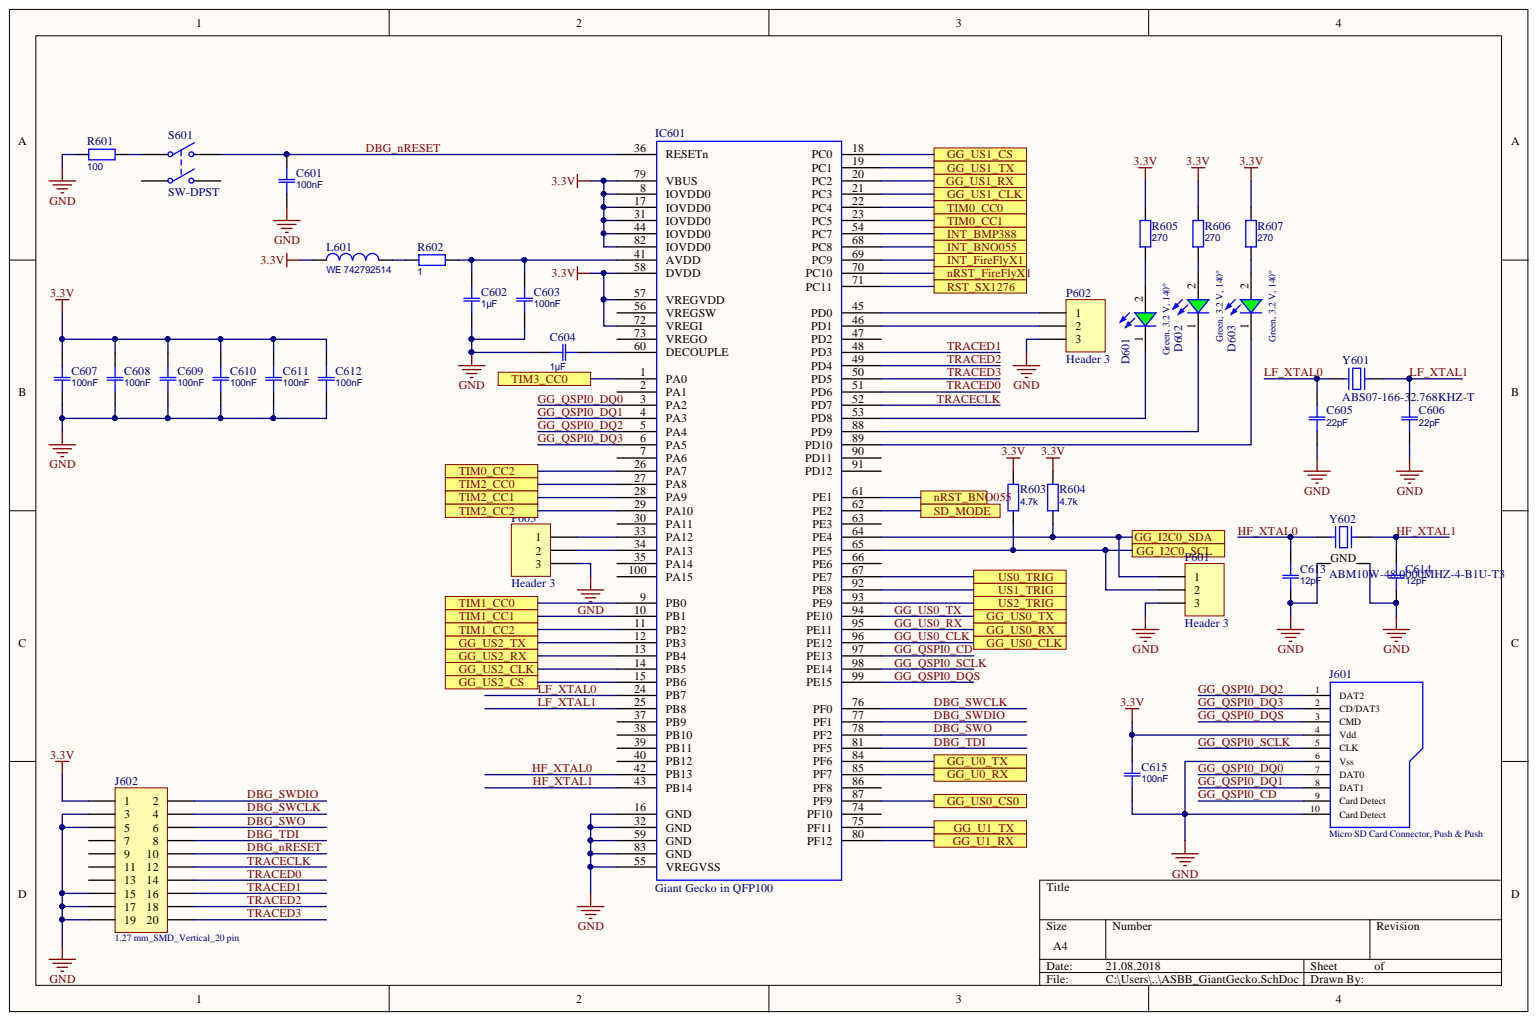
[picture p58: page 7]

IOVDD0 8
IOVDD0 17
IOVDD0 31
IOVDD0 44
IOVDD0 82

DVDD 58

PA1 2 | TRACED0
PA2 3 | TRACECLK

GG_I2C0_SDA
GG_I2C0_SCL

GND | PB1 10 | GG_US0_TX

PB2 11 | GG_US0_RX
PB3 12 | GG_US0_CLK

TIM1_CC2 | | | | GG_US0_RX
GG_US2_TX | | | | GG_US0_CLK

DBG_SWDIO | GG_QSPI0_DQS | CMD 3

PB10 38 | DBG_SWO | | Vdd 4
PB11 39 | DBG_TDI | GG_QSPI0_SCLK | CLK 5

Micro SD Card Connector, Push & Push

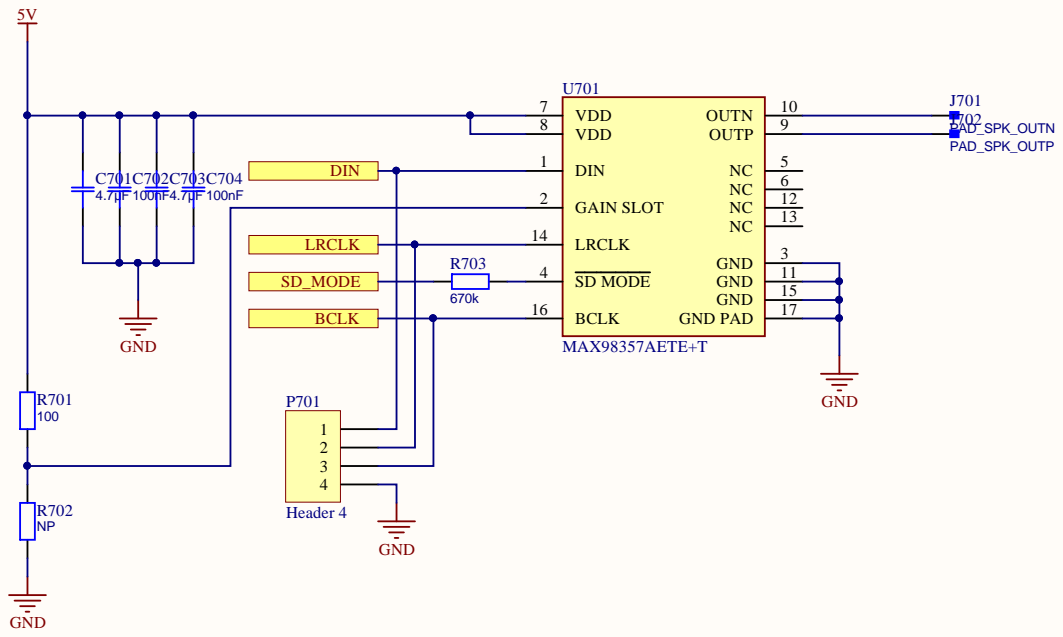
[picture p59: page 8]

C701 4.7µF | C702 100nF | | | VDD 8

GAIN SLOT 2

LRCLK 14

R703 | | SD MODE 4

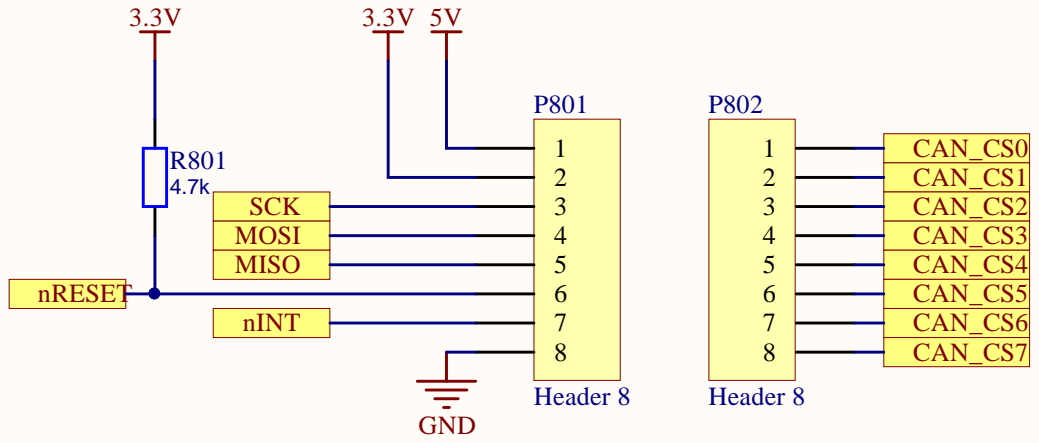
[picture p60: page 9]

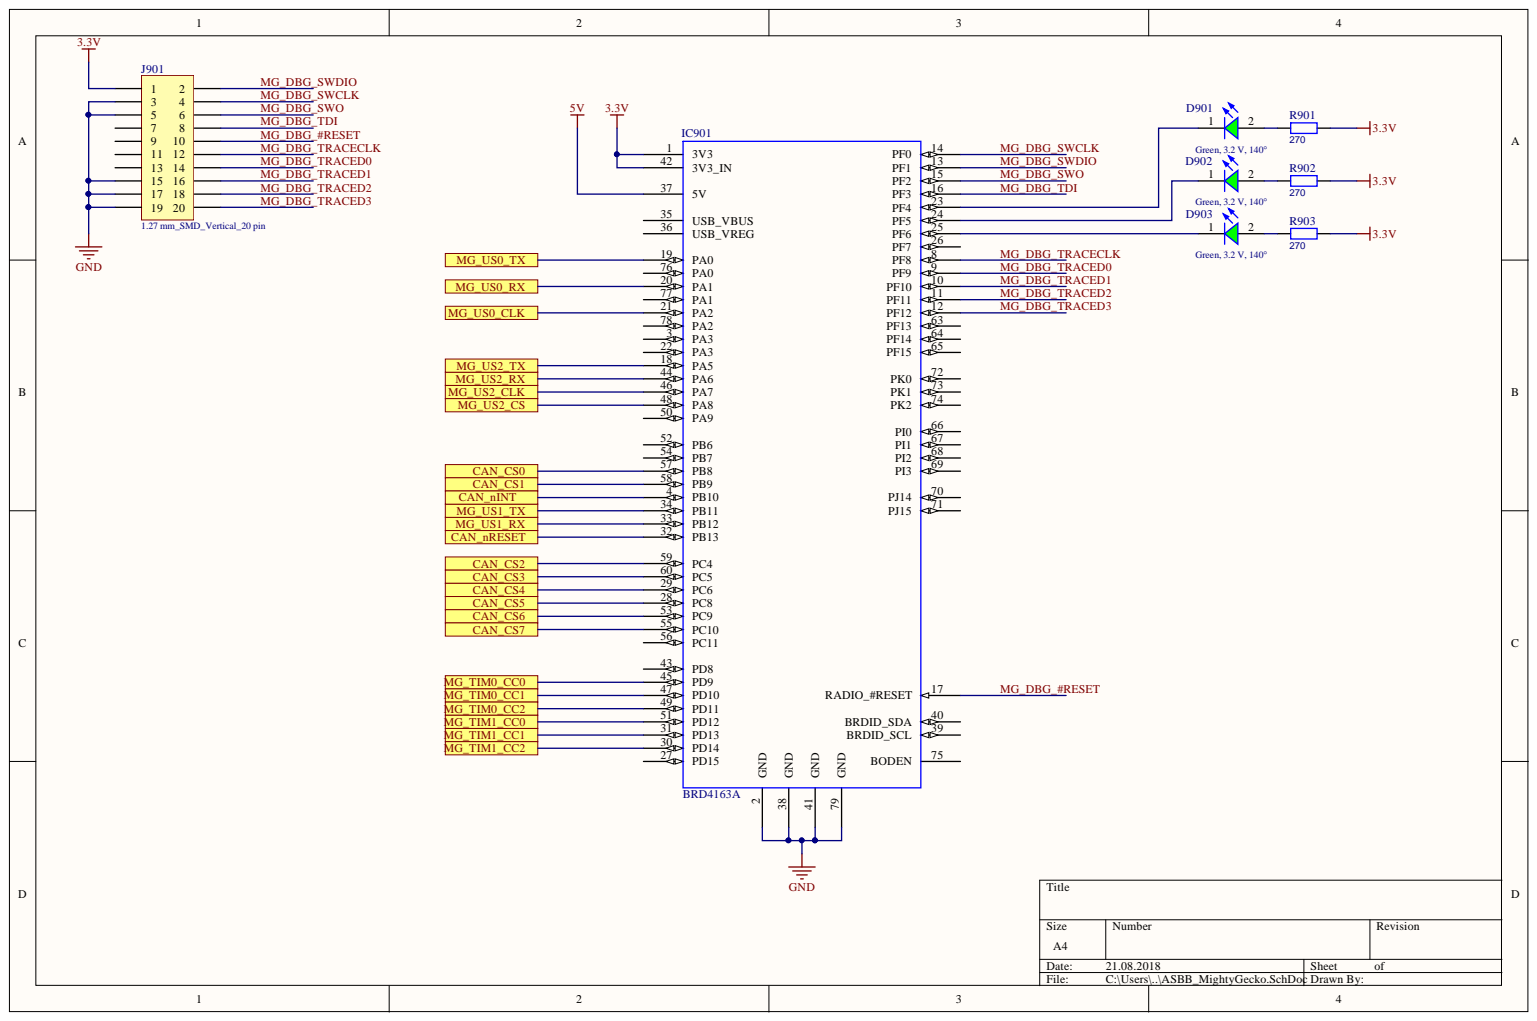
[picture p61: page 10]

1 6 2 3 | MG _ DBG _ T D I

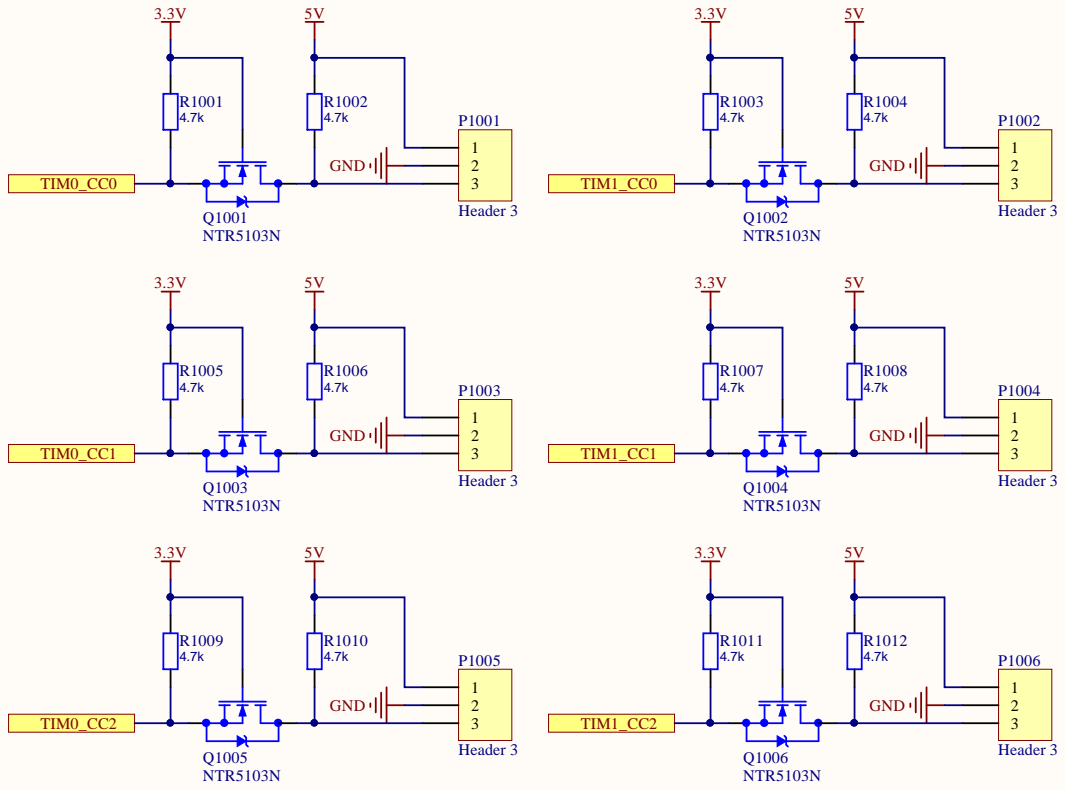
[picture p62: page 11]

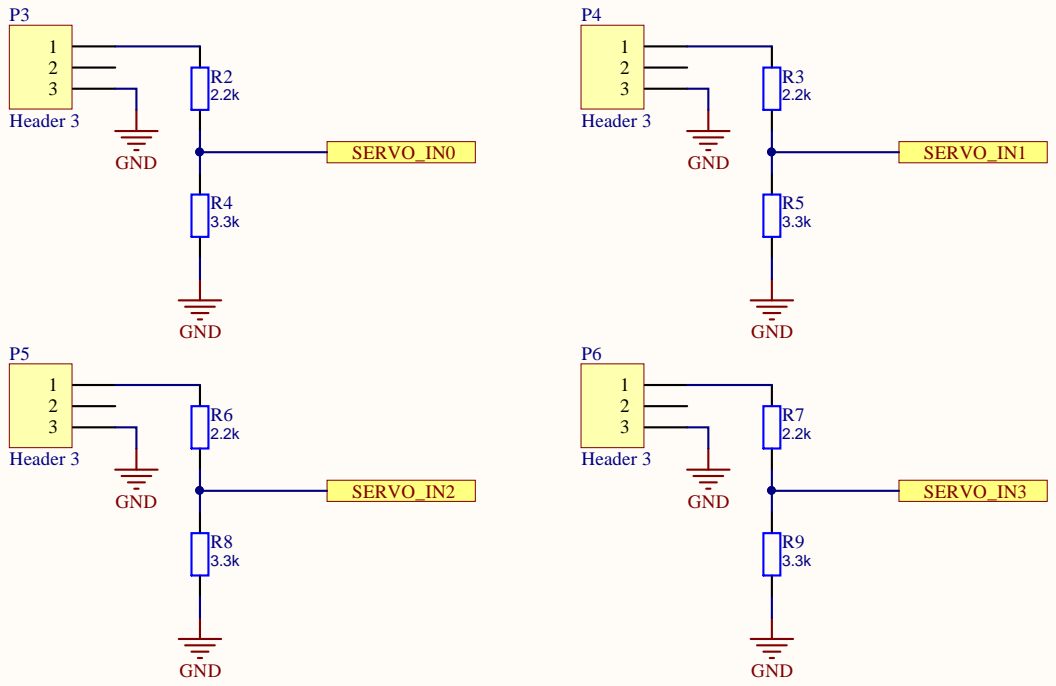
[picture p63: page 12]

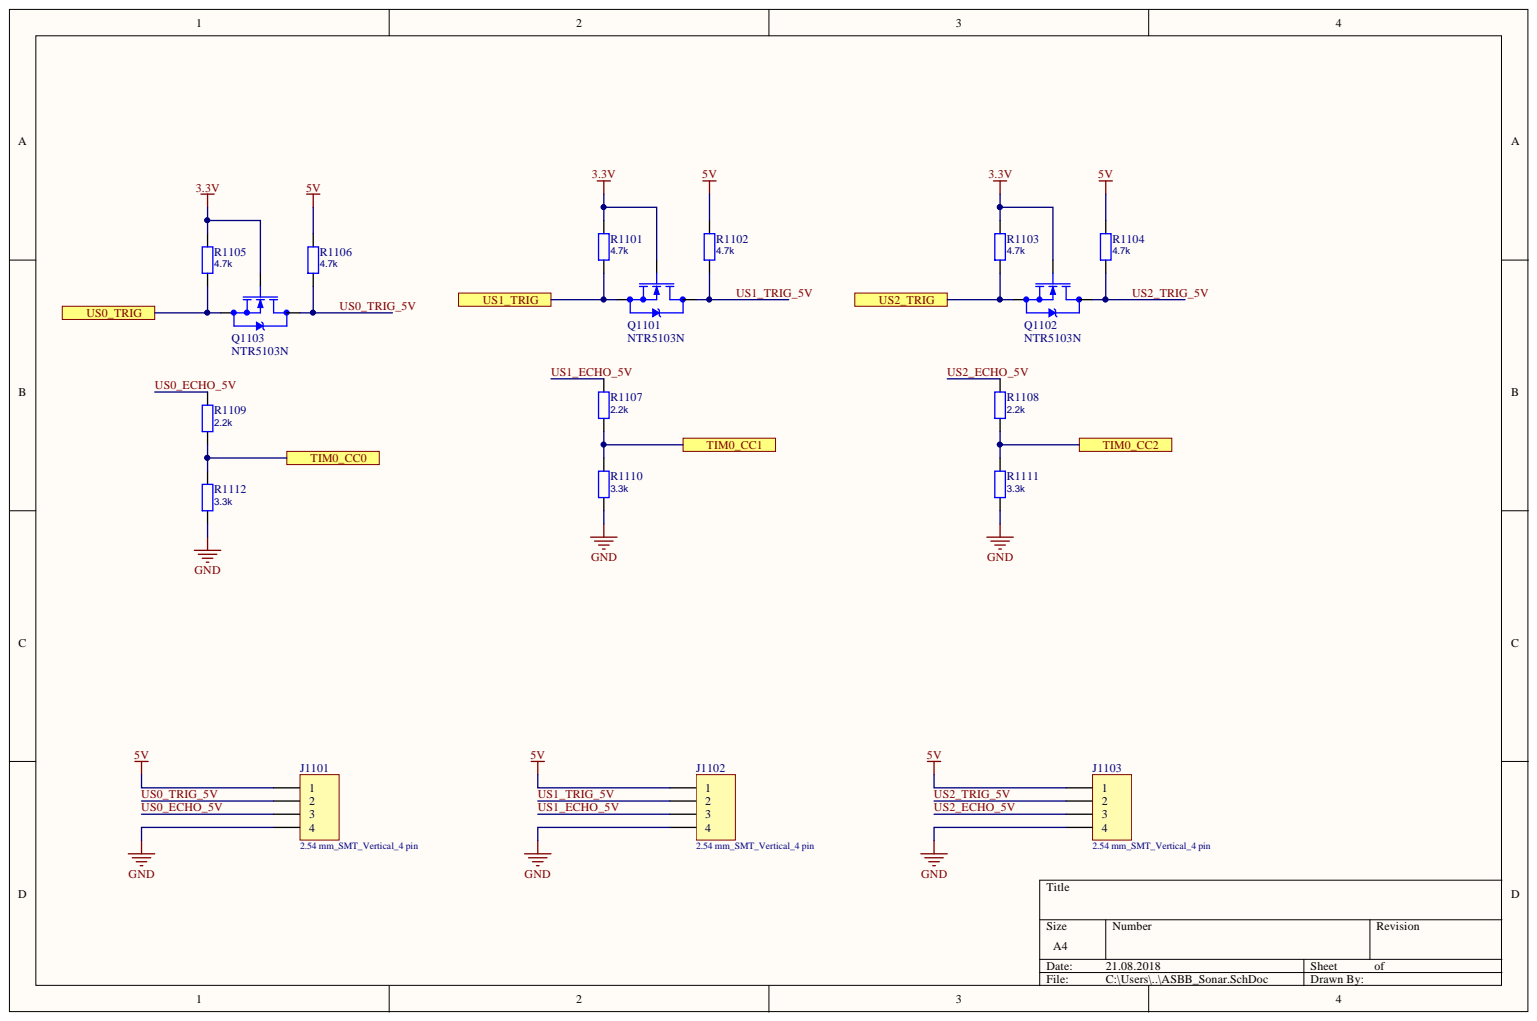
[picture p64: page 13]

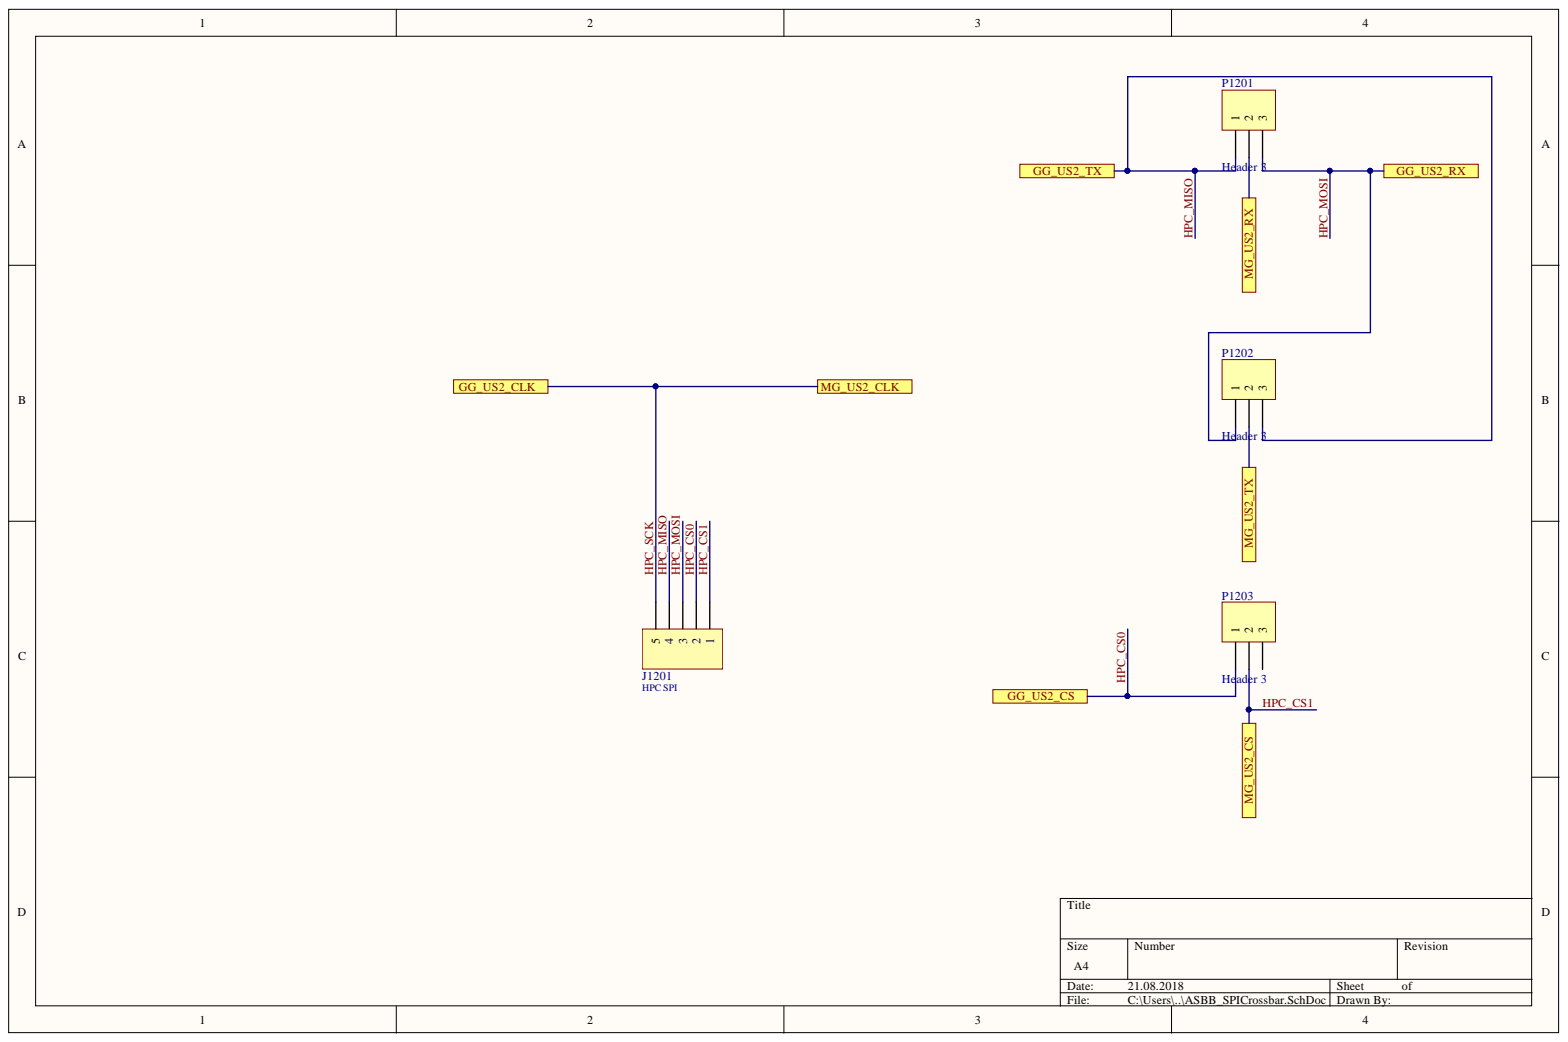
[picture p65: page 14]

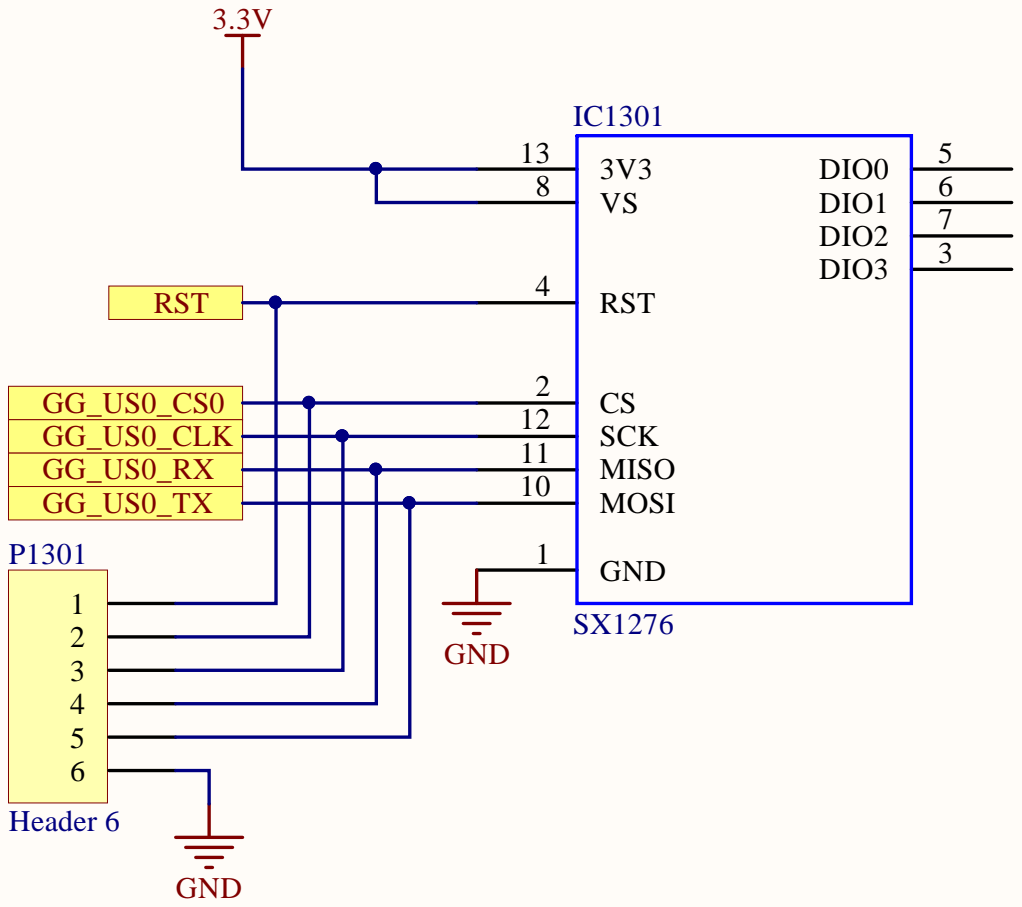
[picture p66: page 15]

GG_US0_CS0
GG_US0_CLK
GG_US0_RX
GG_US0_TX

CS 2
MOSI 10 MISO 11 SCK 12

GND 1

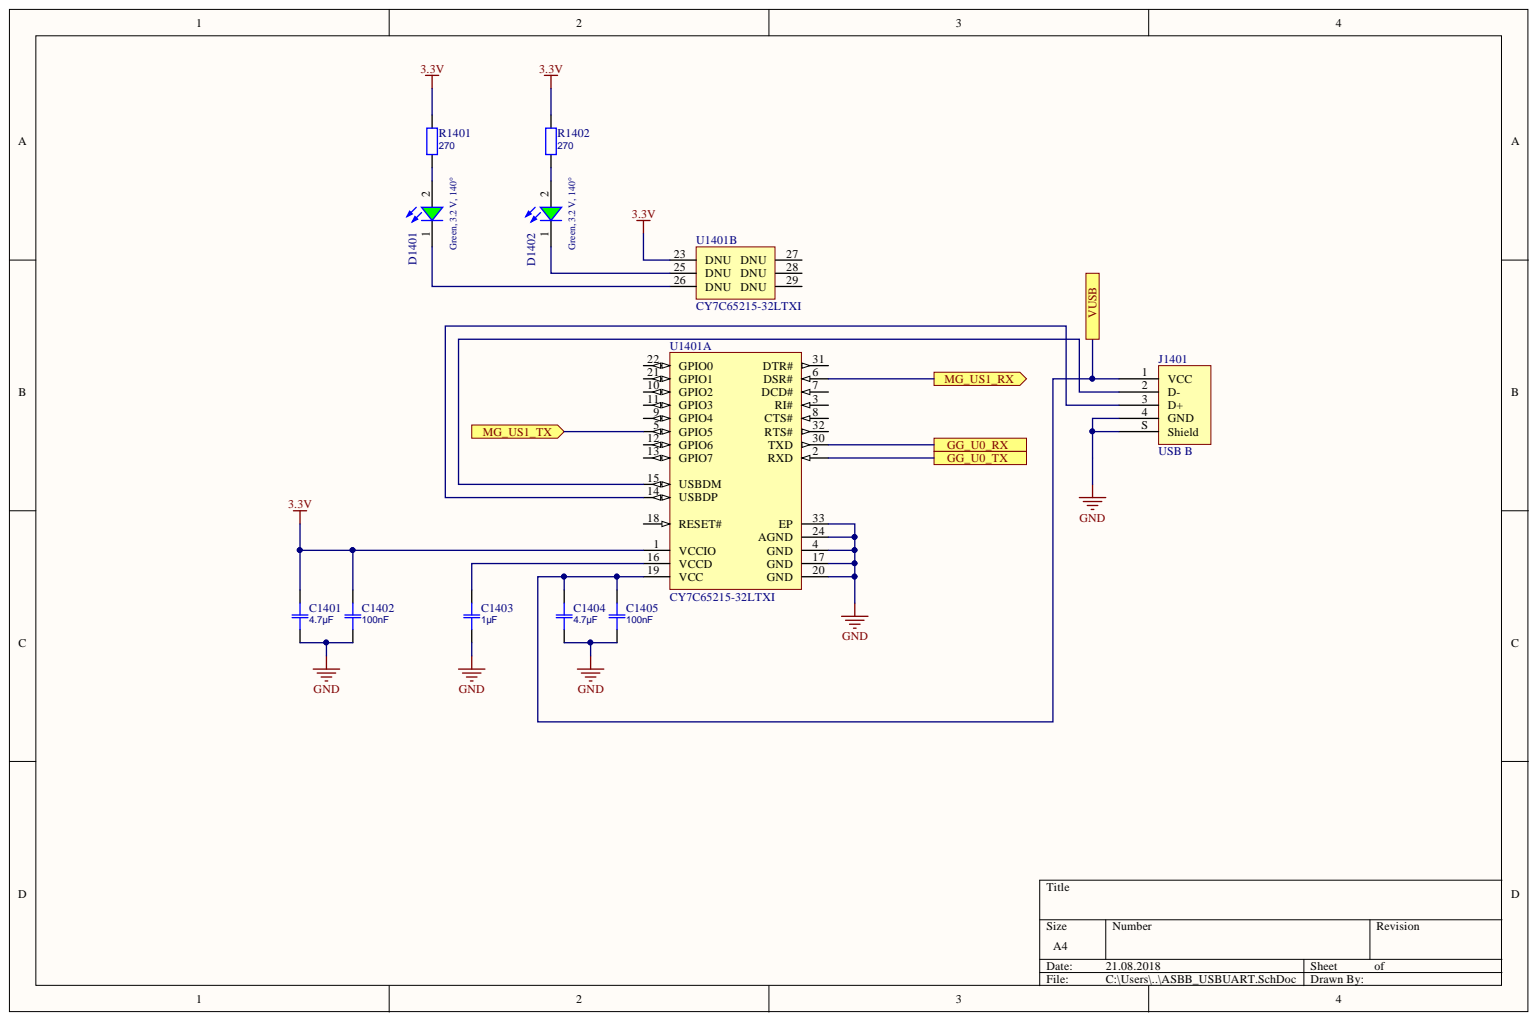
[picture p67: page 16]

GPIO3 11 | | D+ 3

GND 4

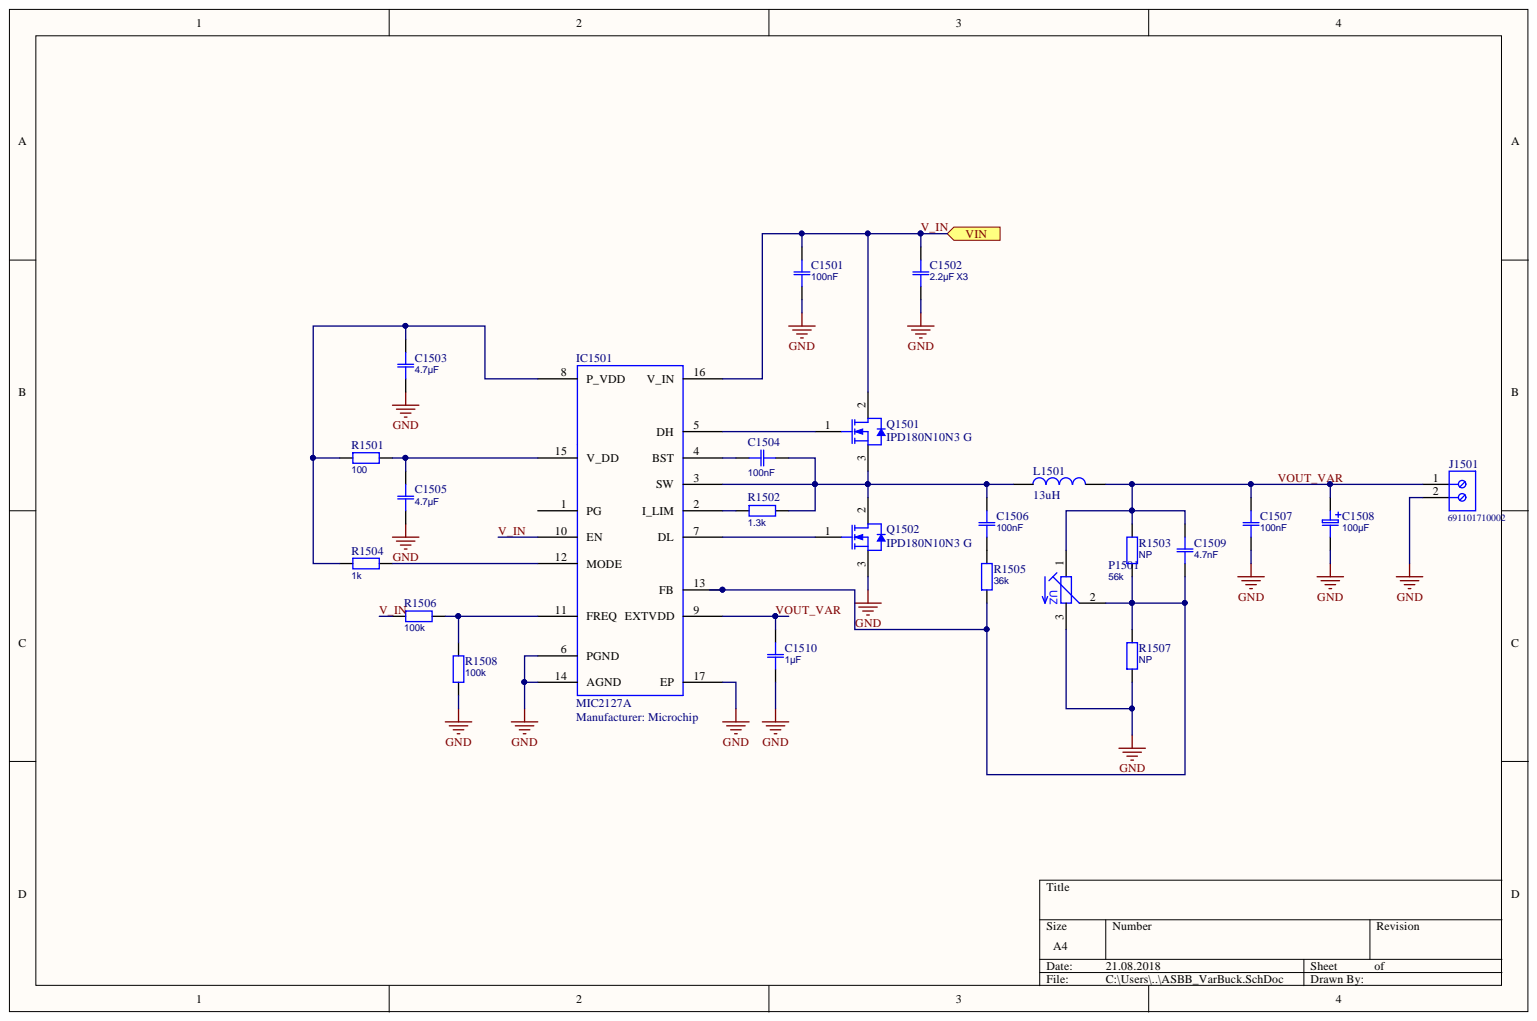
[picture p68: page 17]

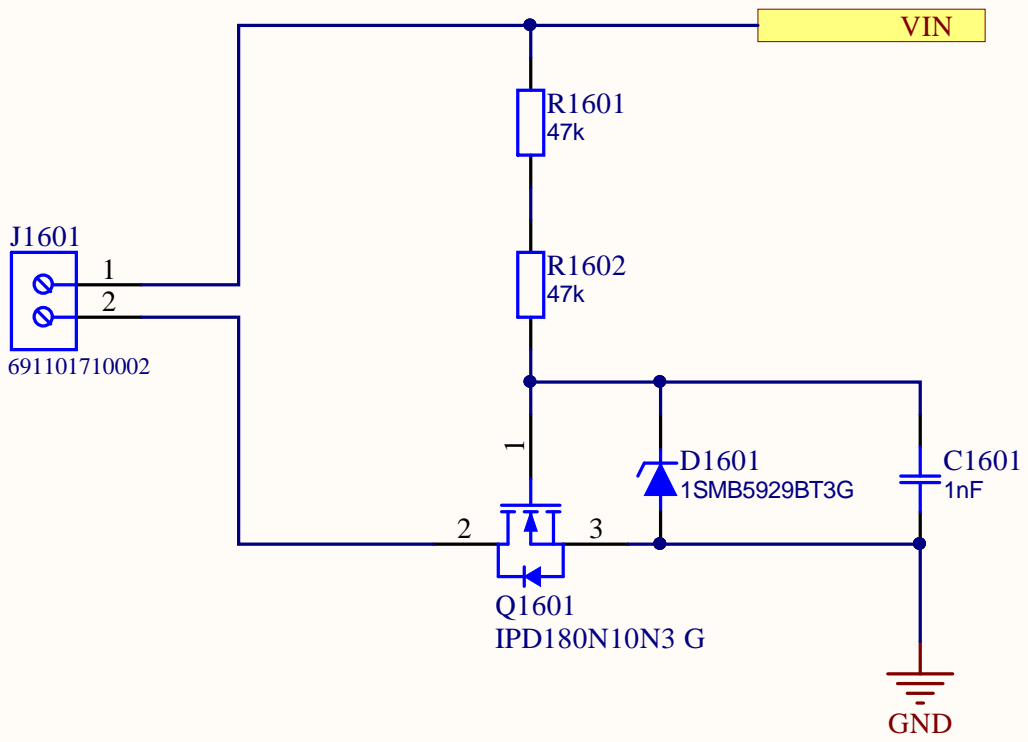
[picture p69: page 18]

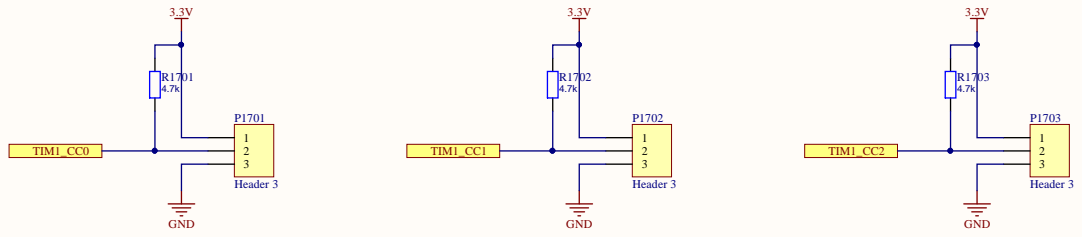
[picture p70: page 19]

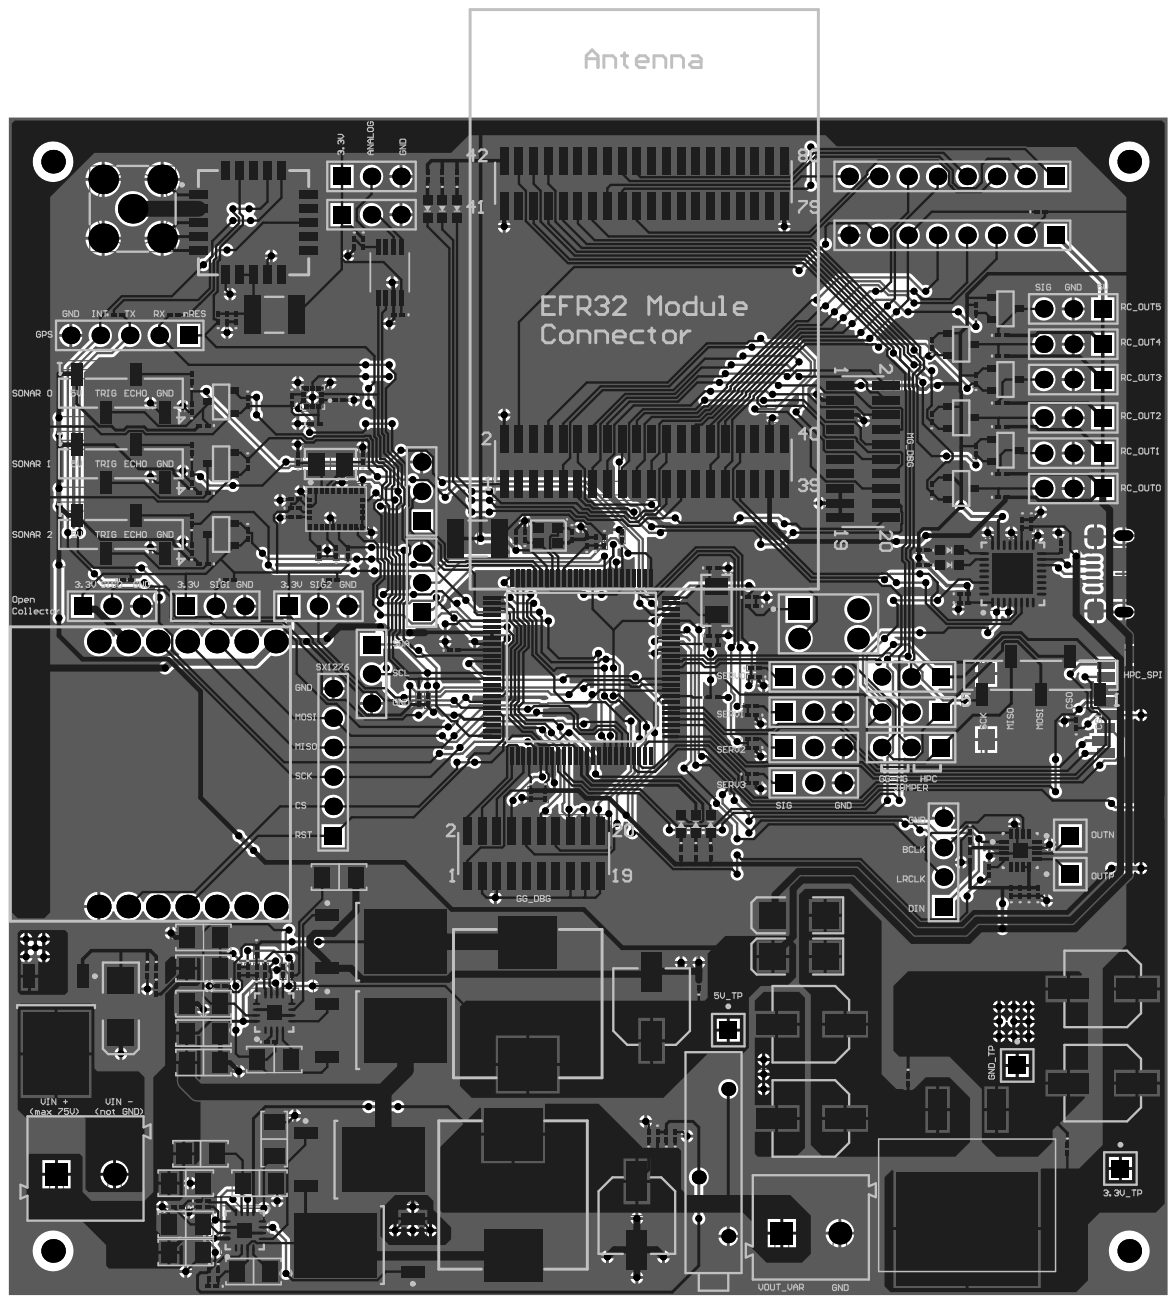
[picture p71: page 20]
