torbenmehner/Masterarbeit/05_Hardware/ASBB.pdf

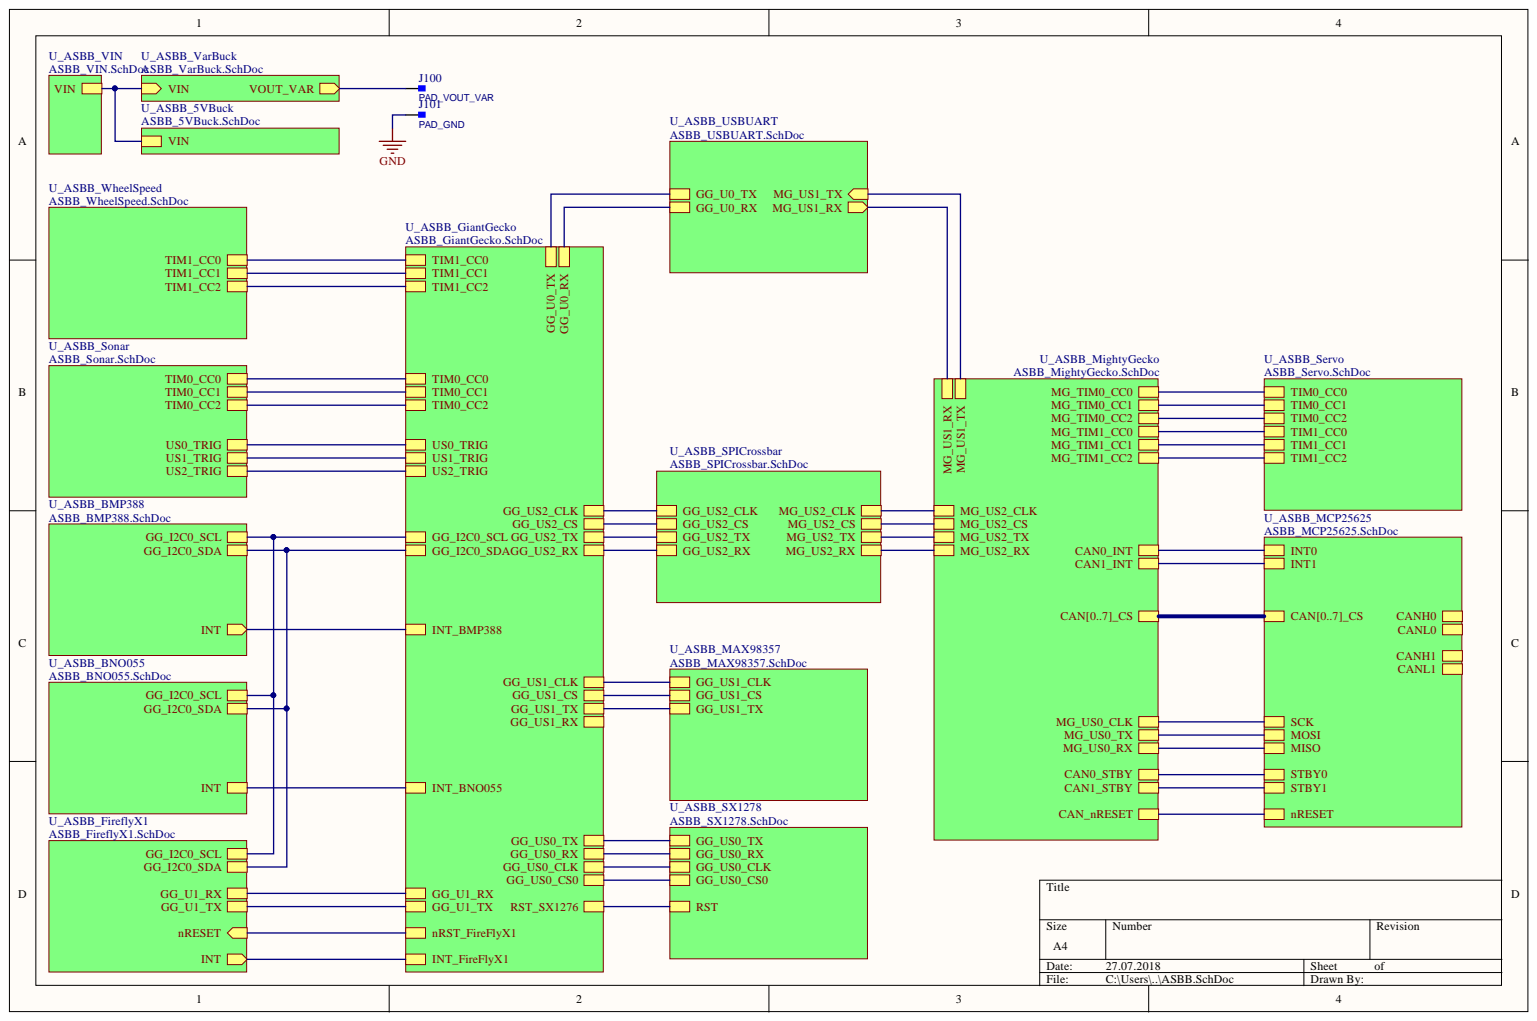
[picture p72: page 1]

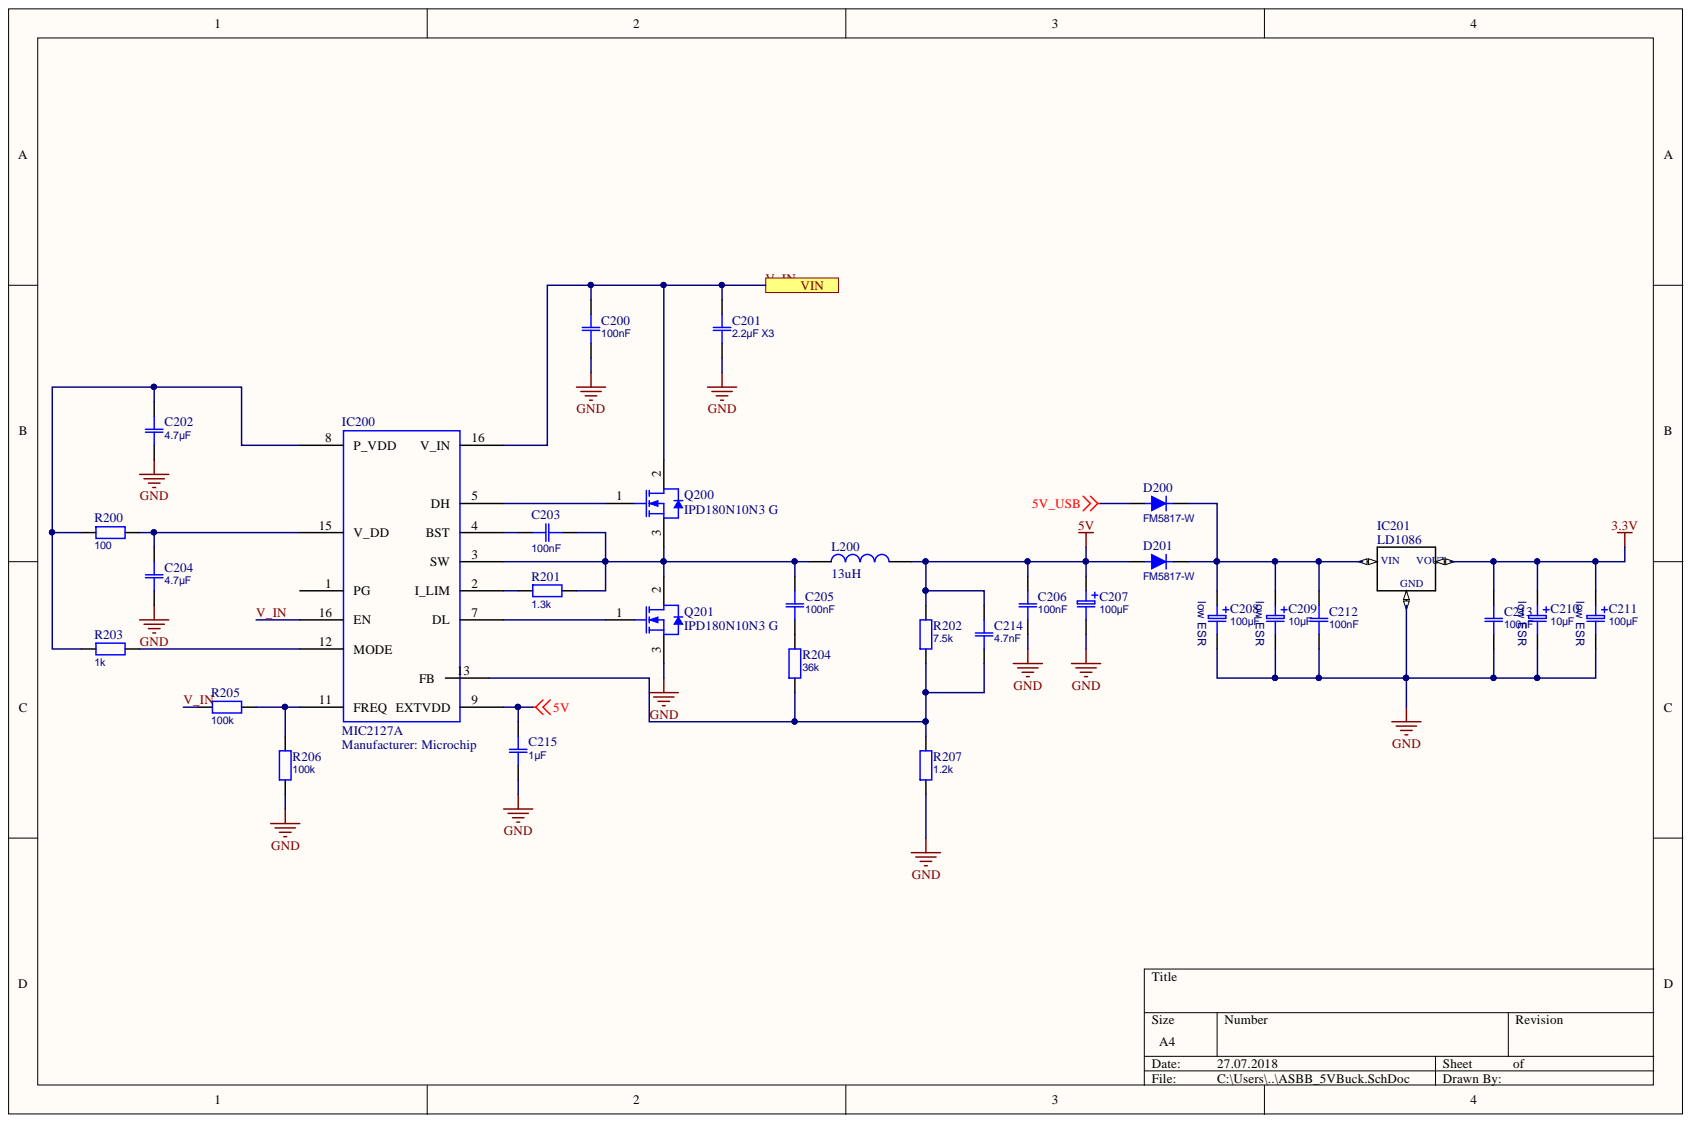
[picture p73: page 2]

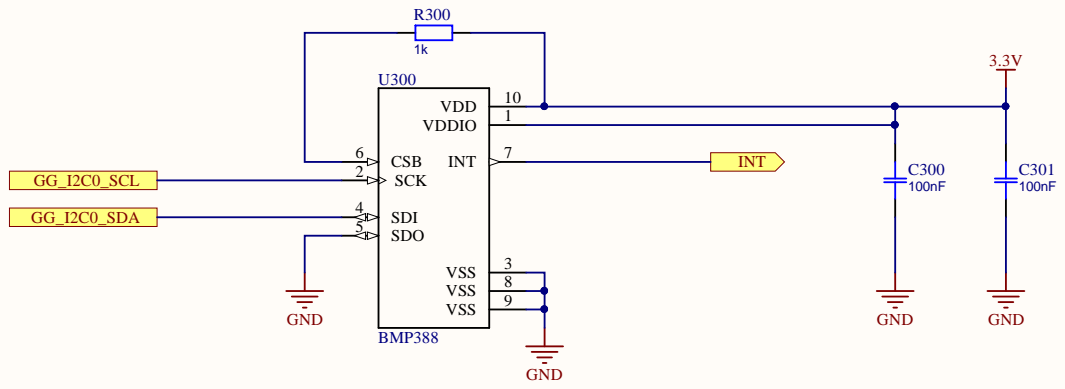
[picture p74: page 3]

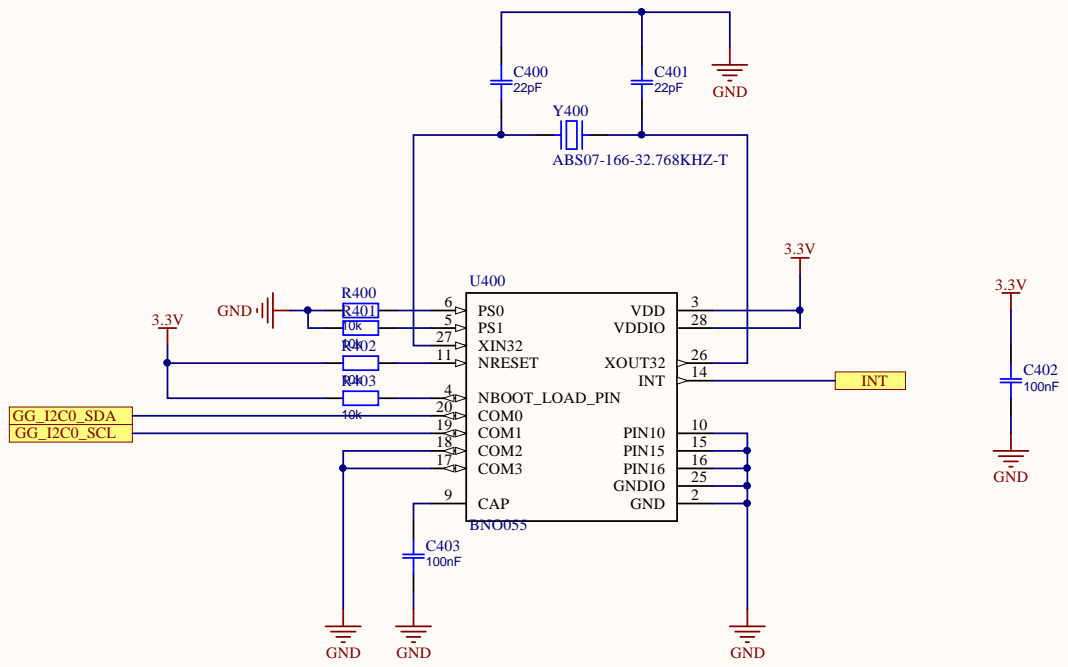
[picture p75: page 4]

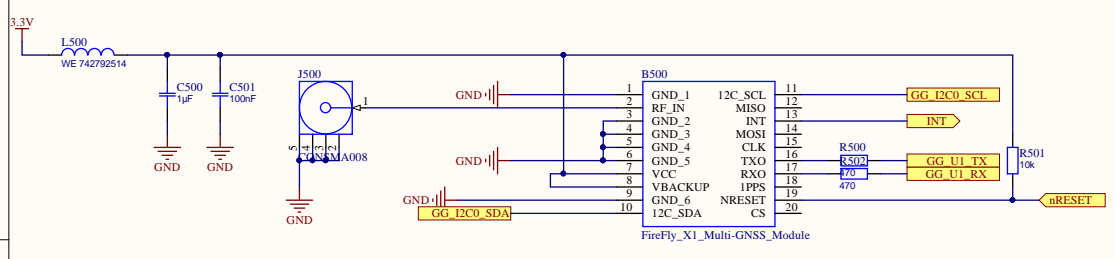
[picture p76: page 5]

2 | | 1 3
4 | | 1 4
5 | G N D _ 4 CL K G N D _ 5 T X O VCC RX O VBACK U P 1PPS G N D _ 6 NRESE T 1 2C_SD A CS

7 | | 1 7

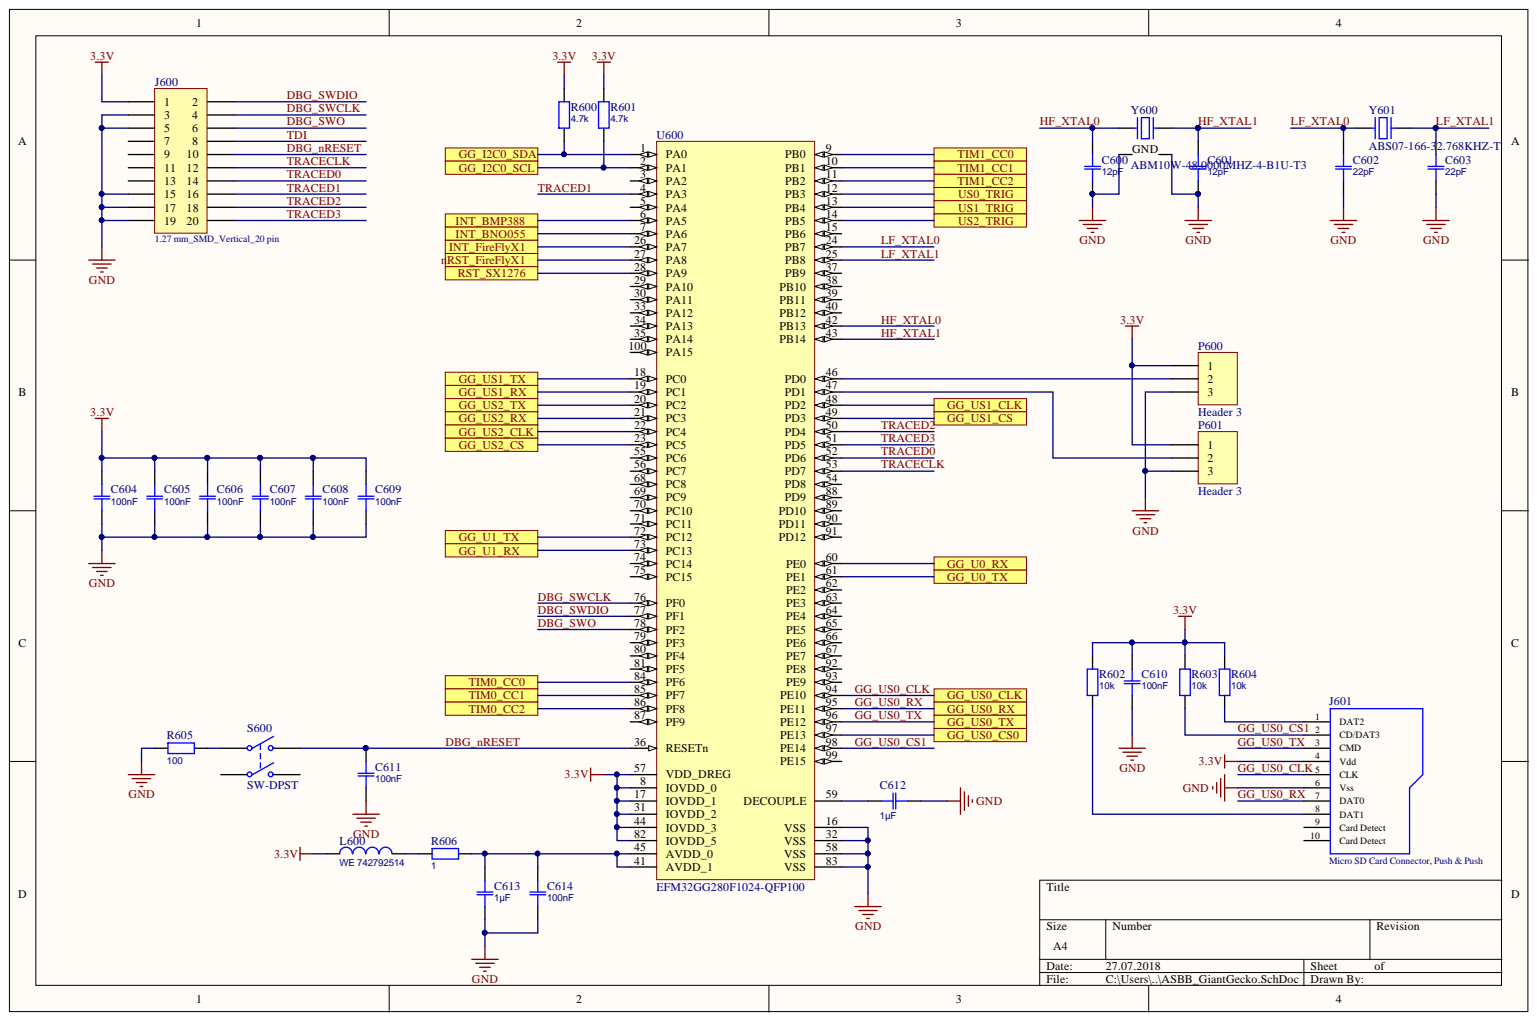
[picture p77: page 6]

PC6 55 | | TRACED0

C604 100nF | C605 100nF | C606 100nF | C607 100nF | C608 100nF | PC7 56 | TRACECLK

TIM0_CC2 | GG_US0_RX

PF8 86 | GG_US0_RX
PF9 87 | GG_US0_TX

Micro SD Card Connector, Push & Push

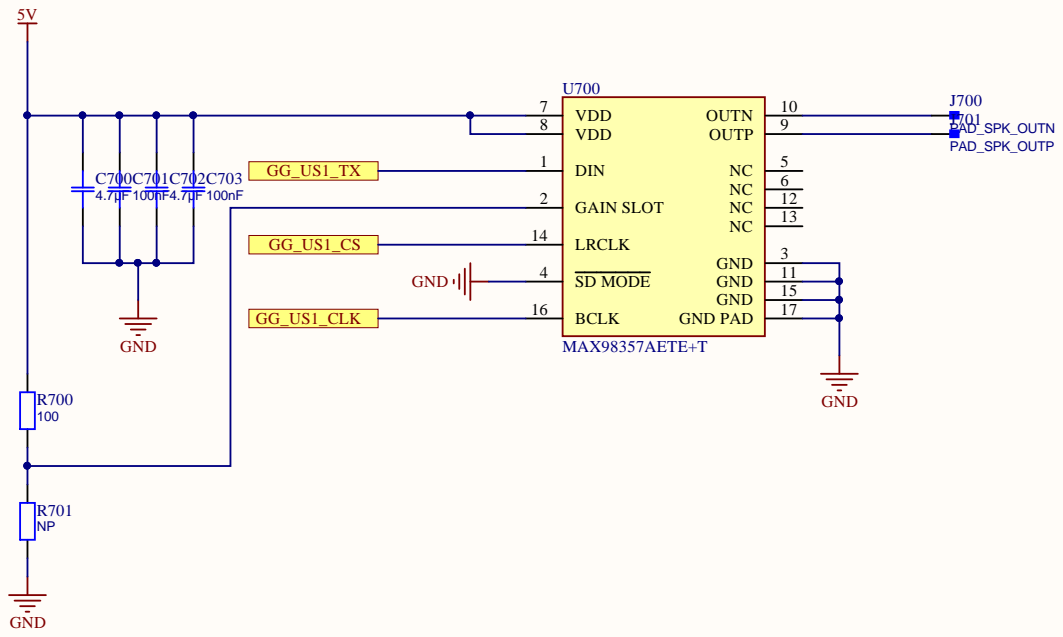
[picture p78: page 7]

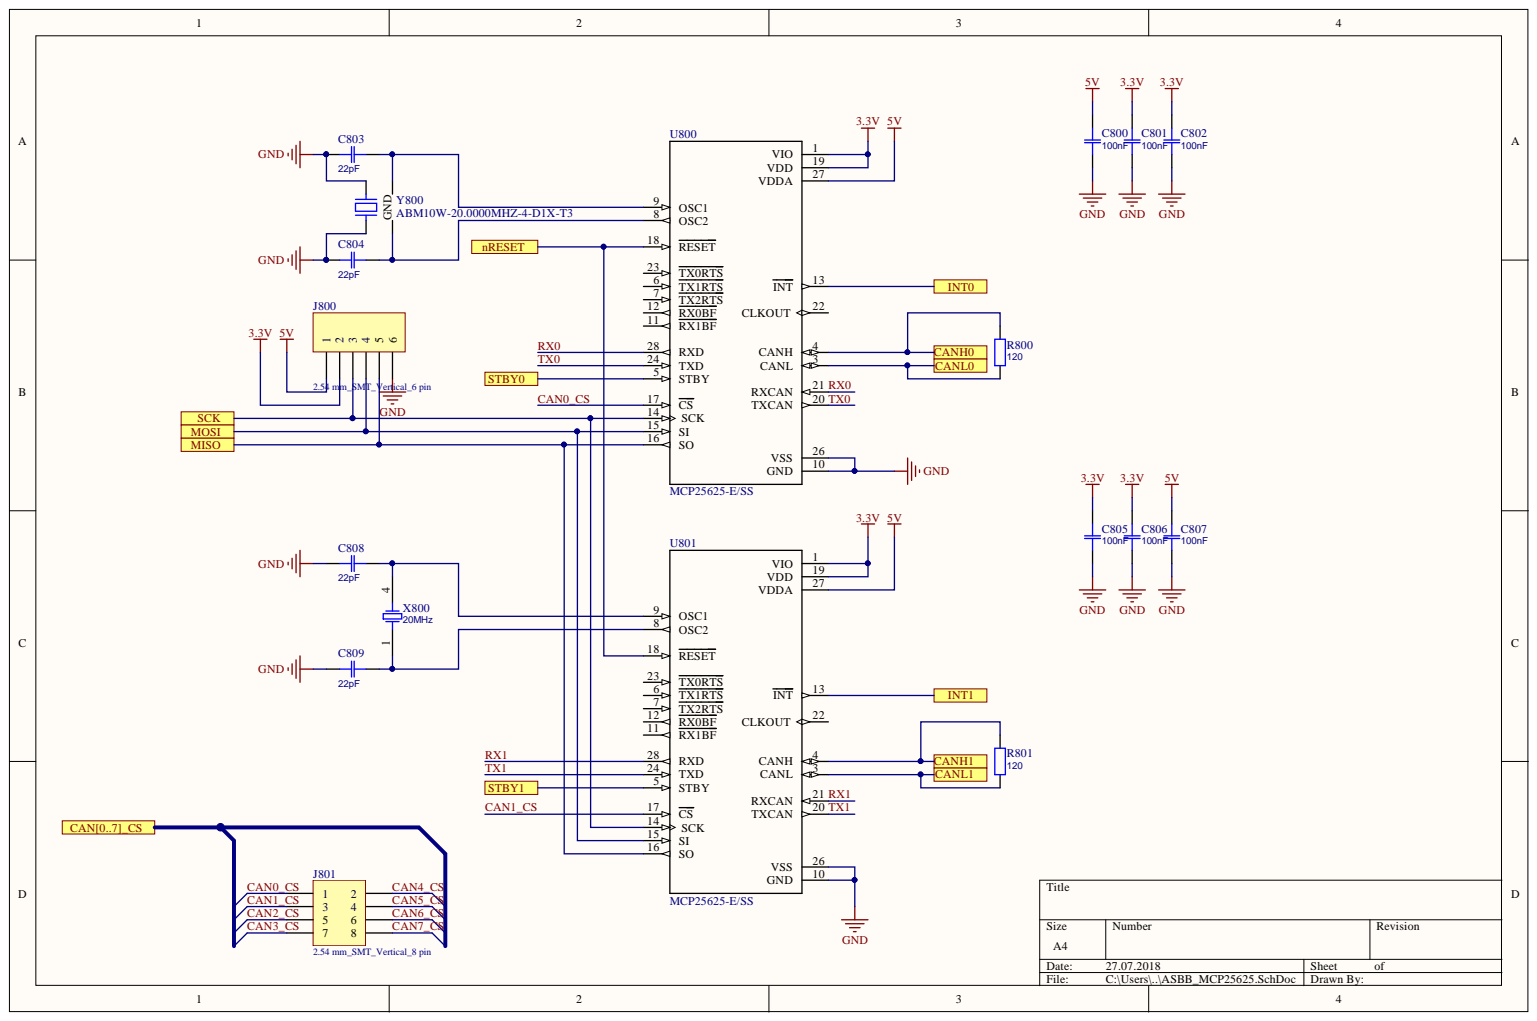
[picture p79: page 8]

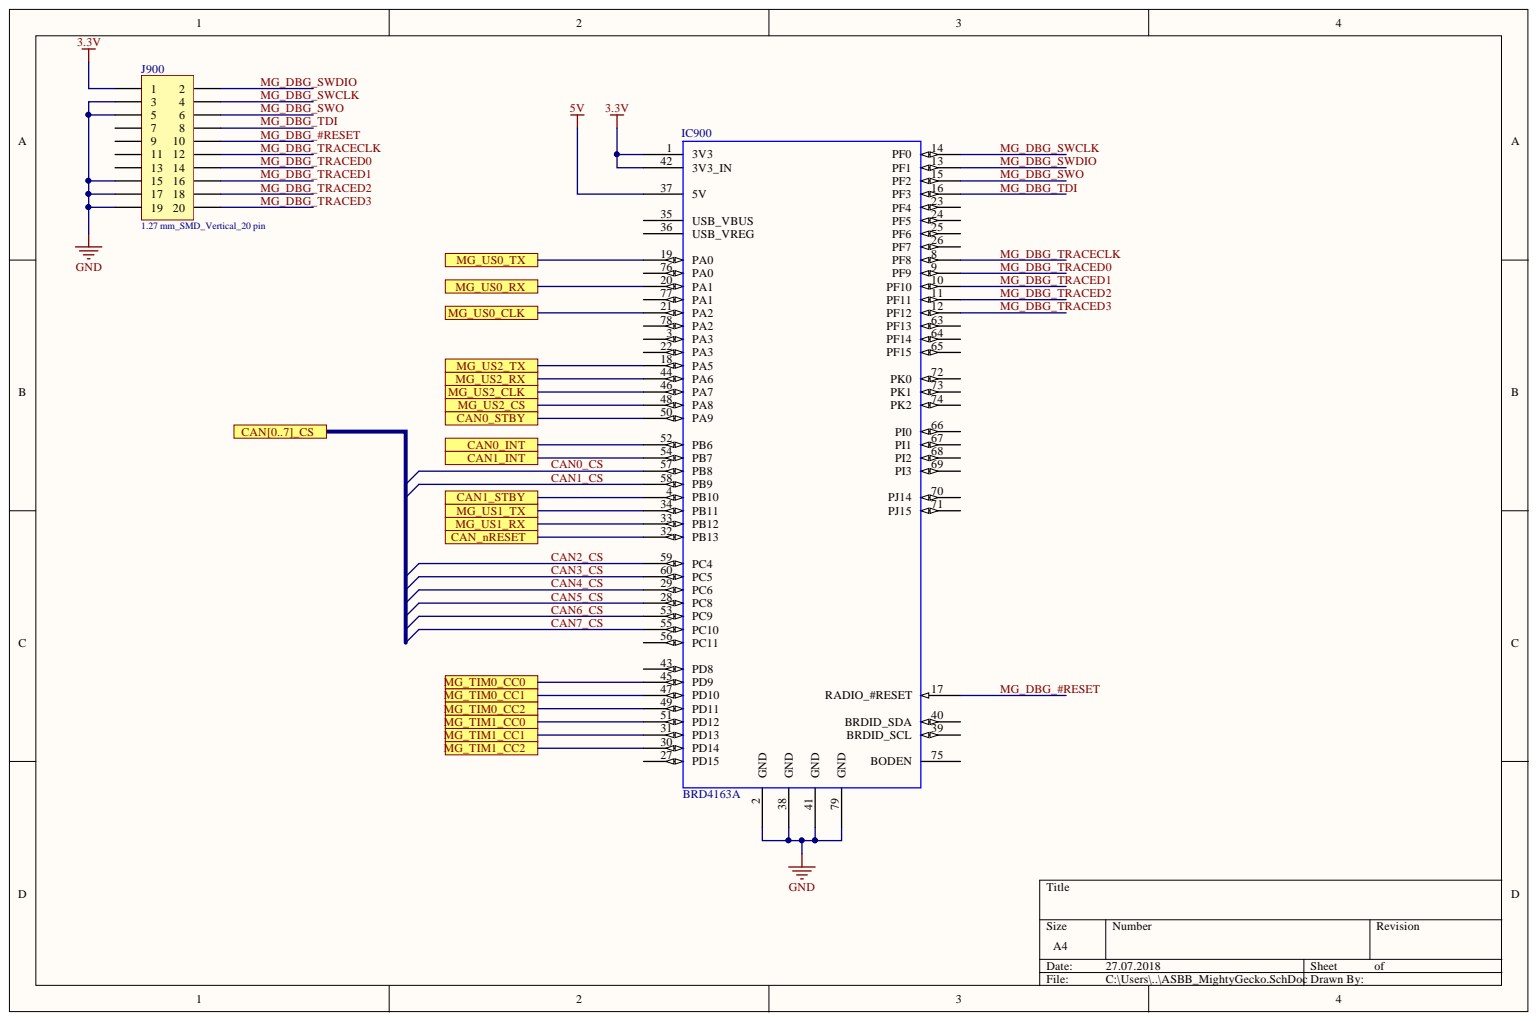
[picture p80: page 9]

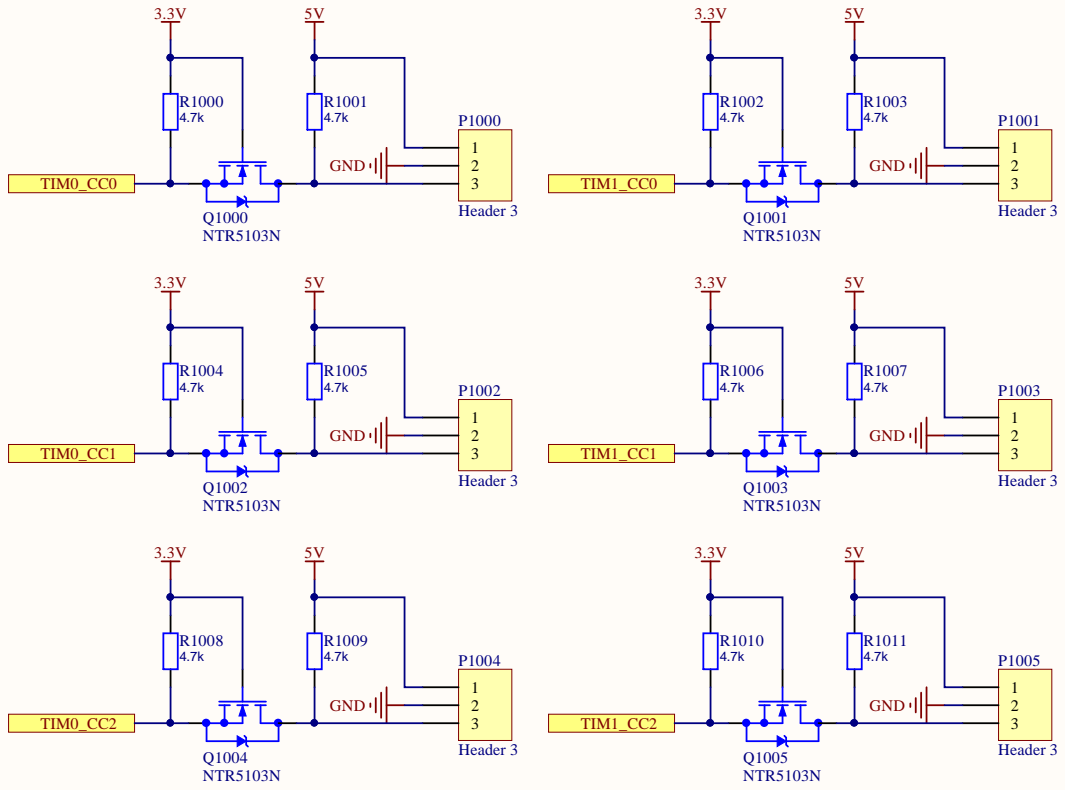
[picture p81: page 10]

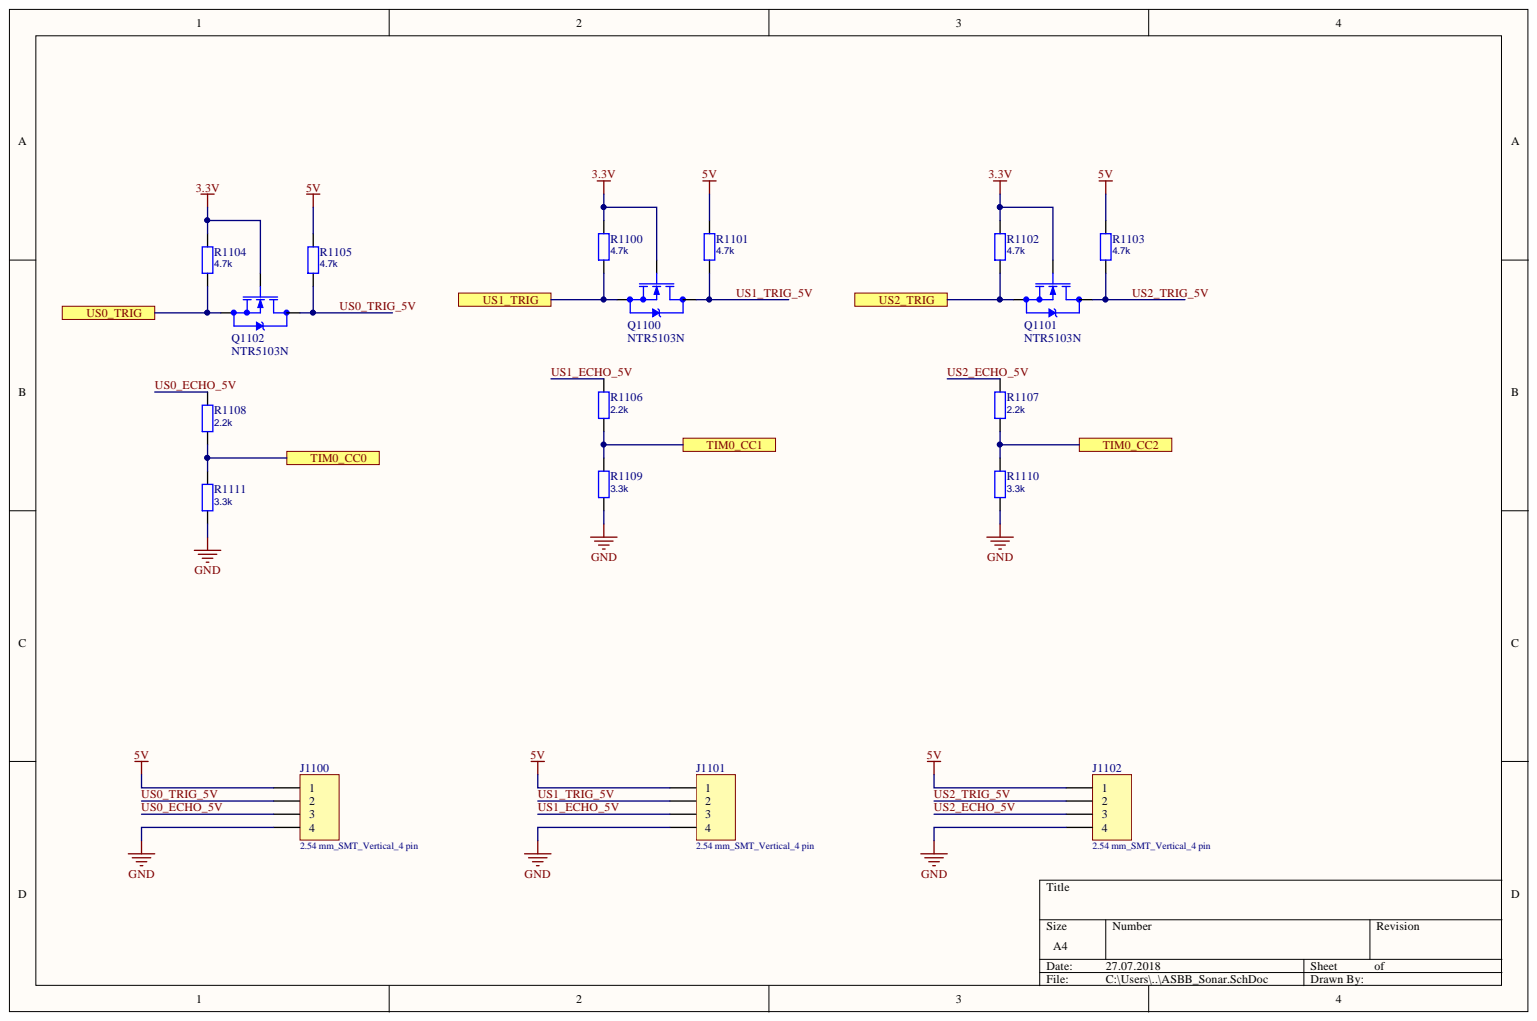
[picture p82: page 11]

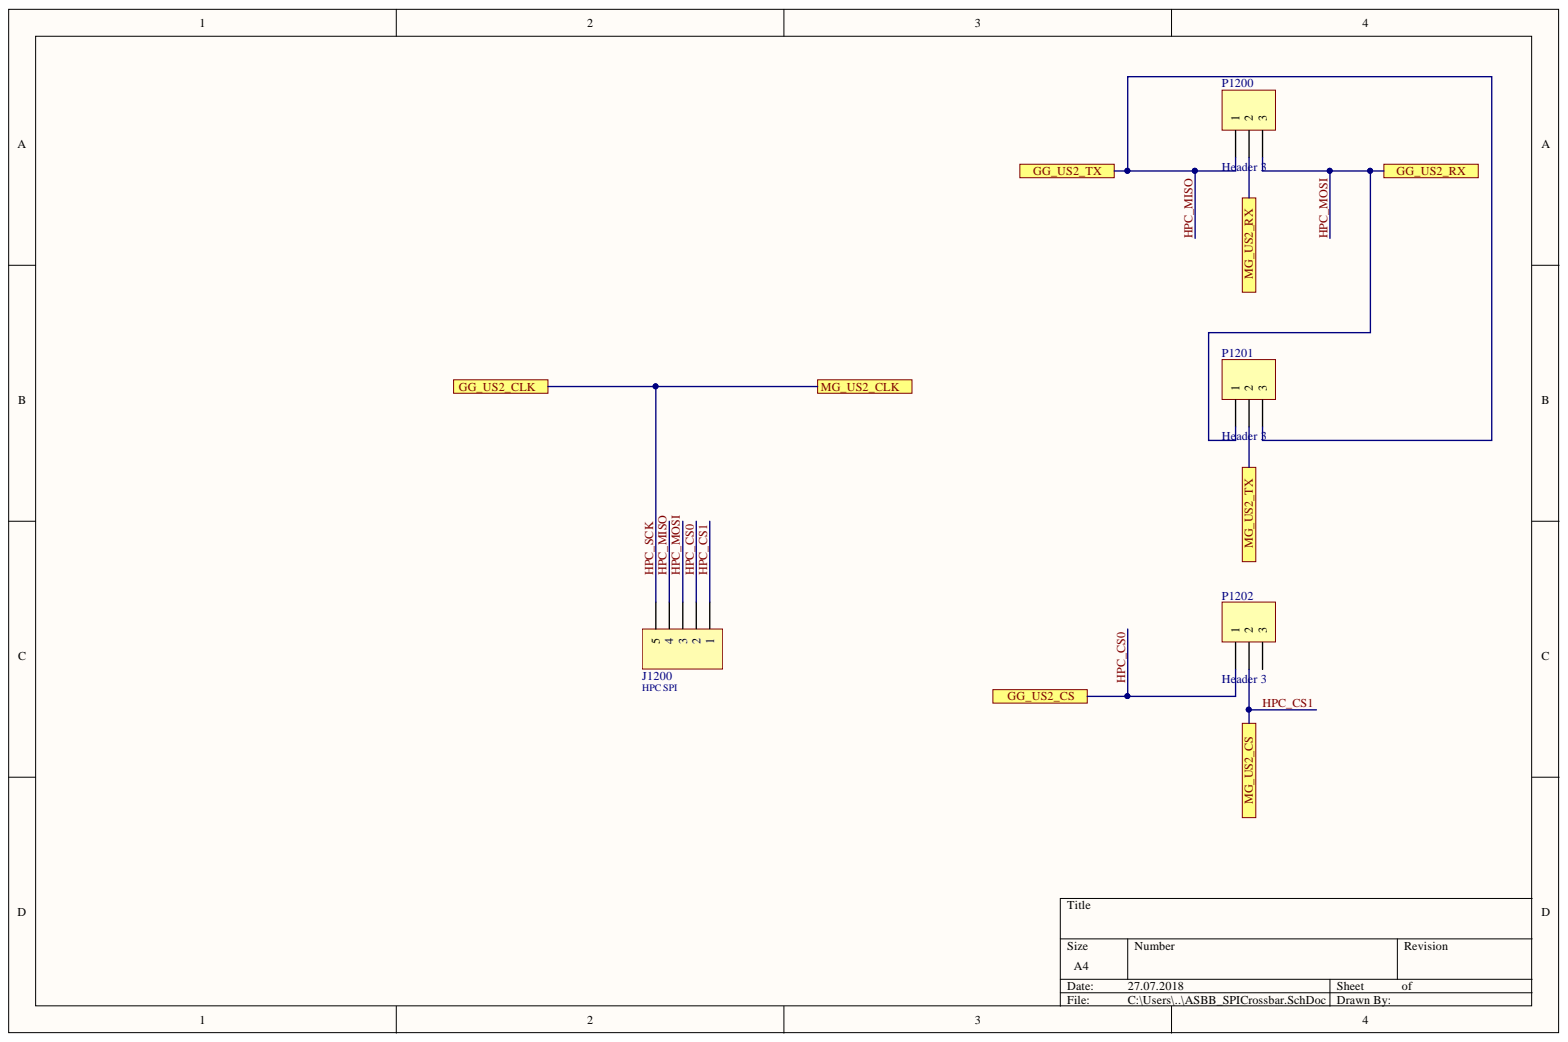
[picture p83: page 12]

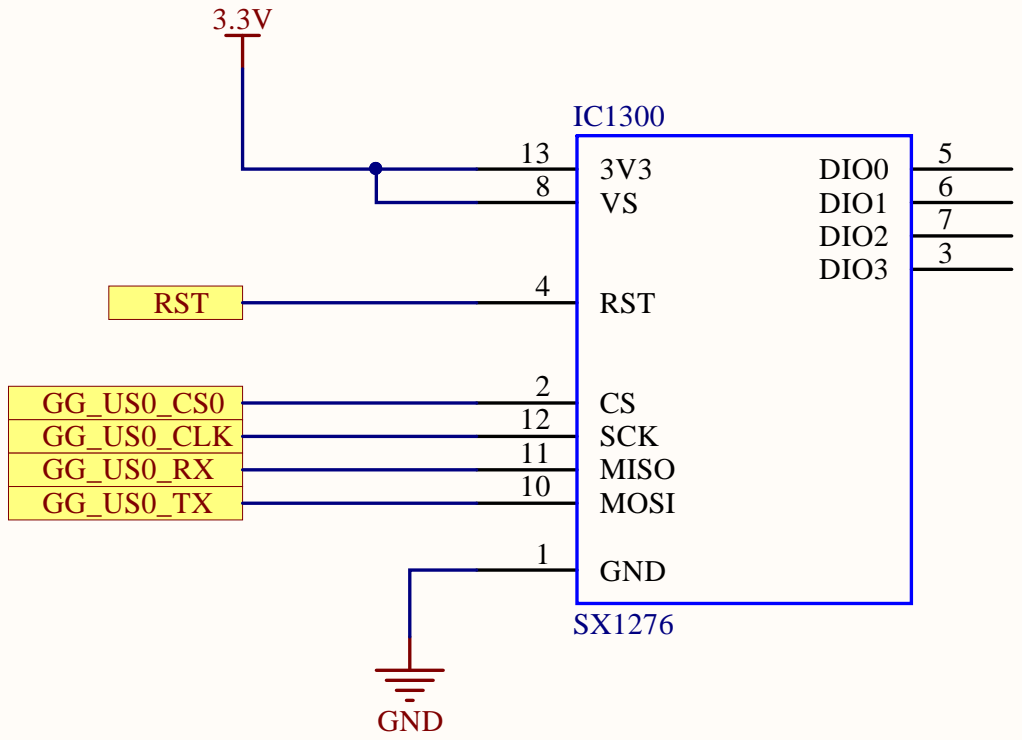
[picture p84: page 13]

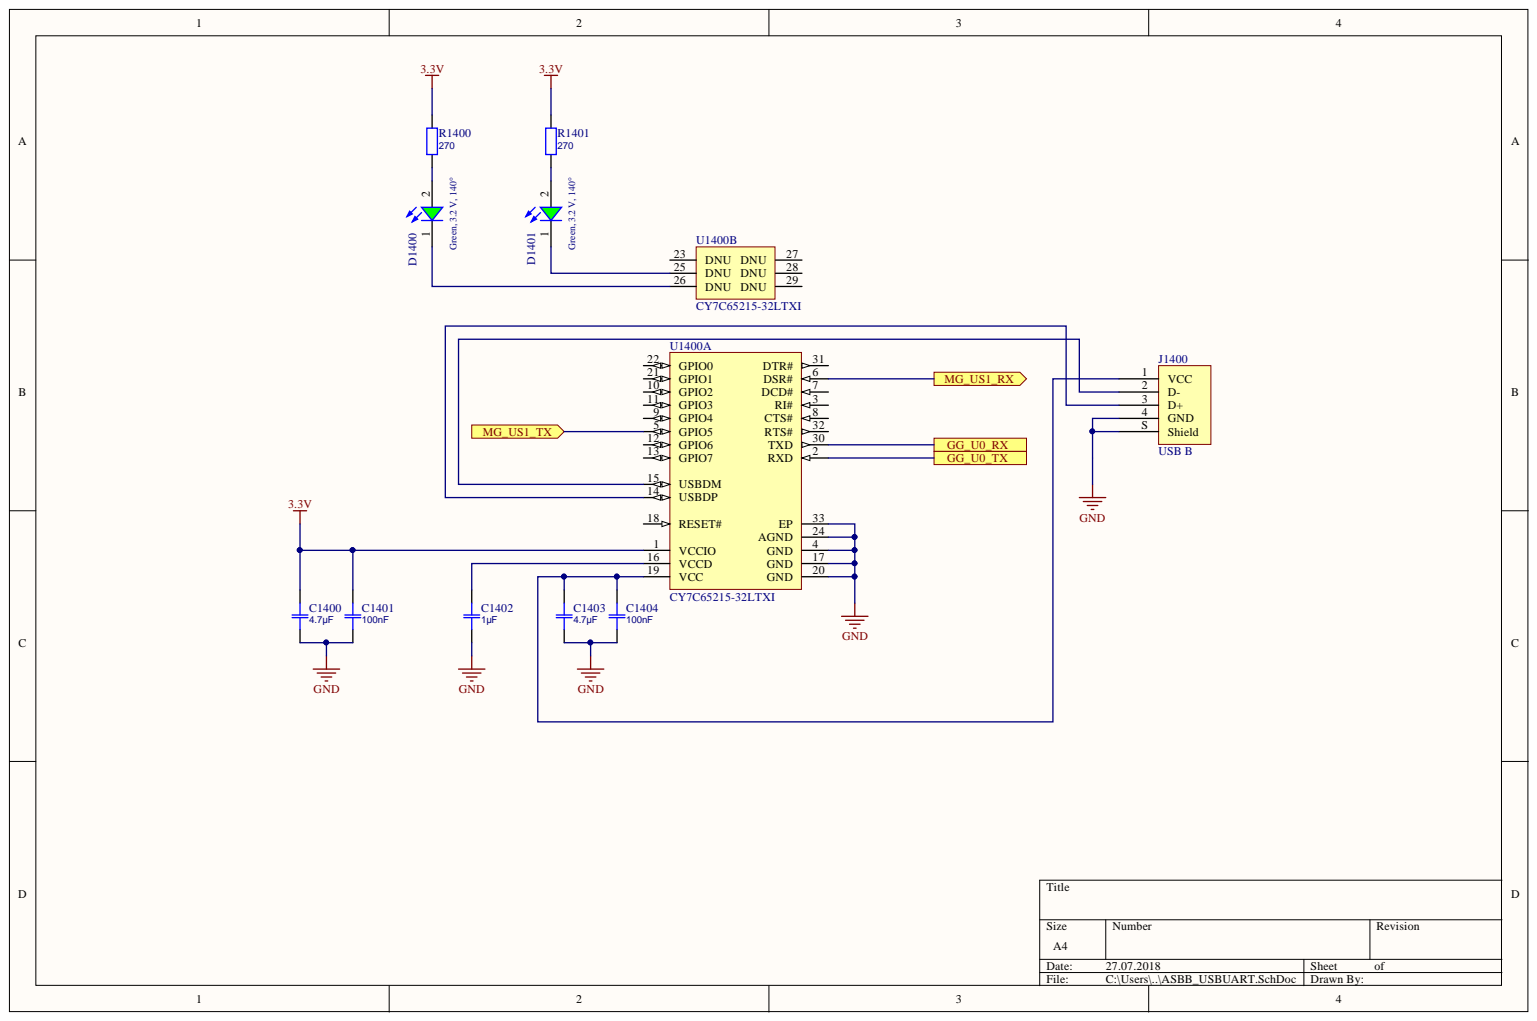
[picture p85: page 14]

GPIO3 11 | | D+ 3

GND 4

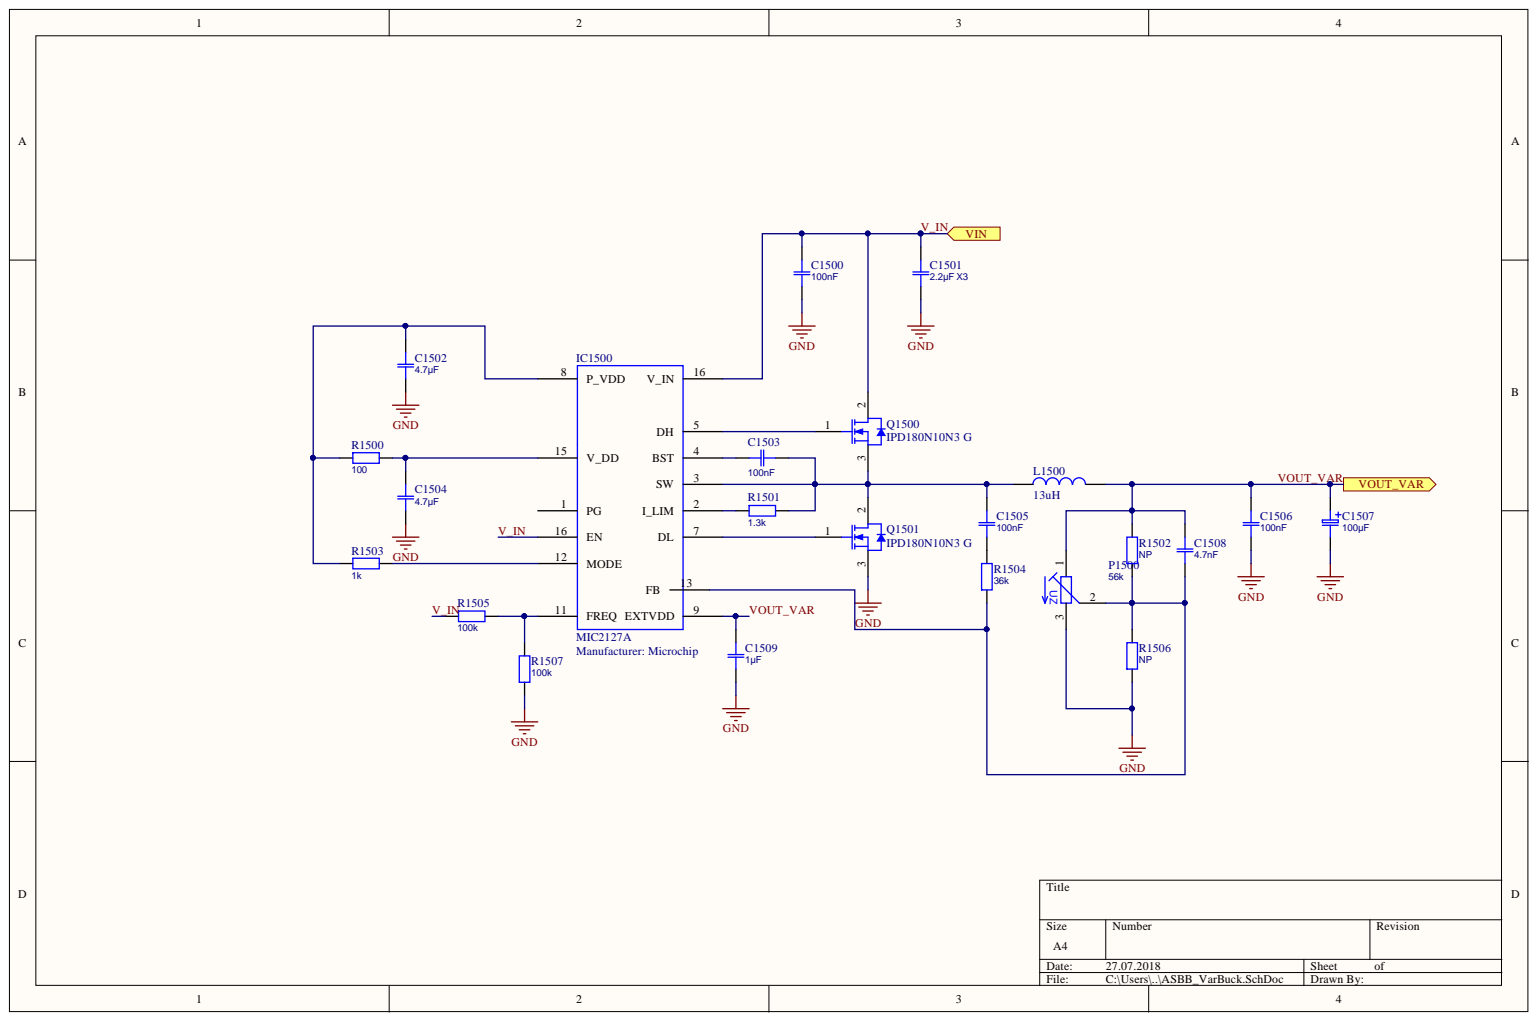
[picture p86: page 15]

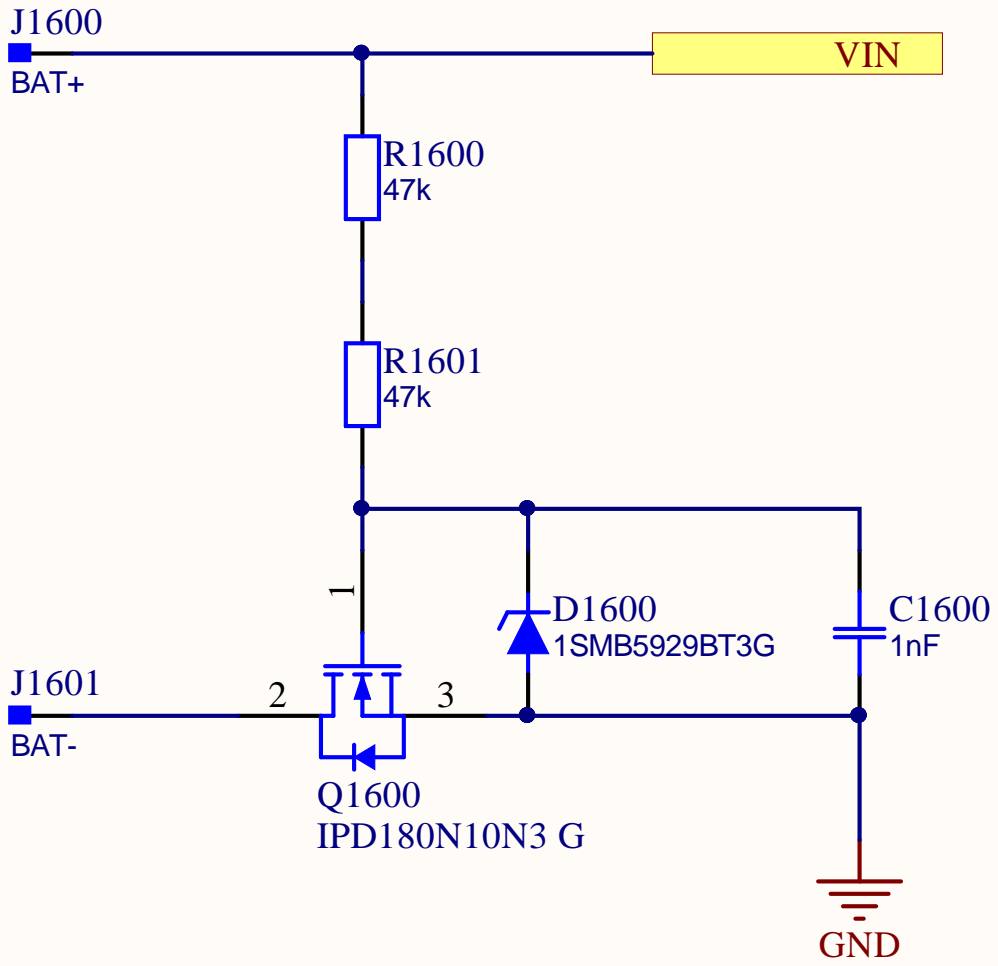
[picture p87: page 16]

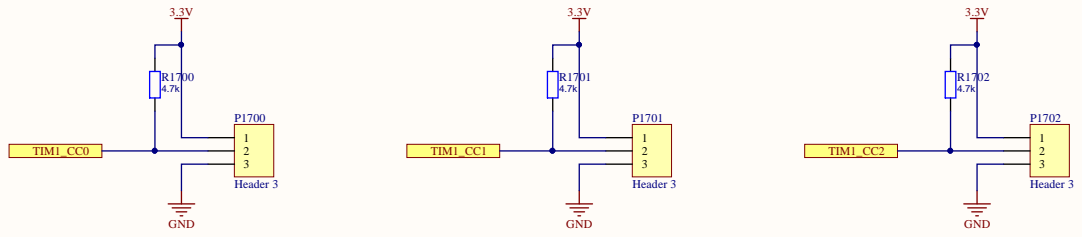
[picture p88: page 17]
