torbenmehner/Masterarbeit/03_Architektur/architecture_detailed.pdf

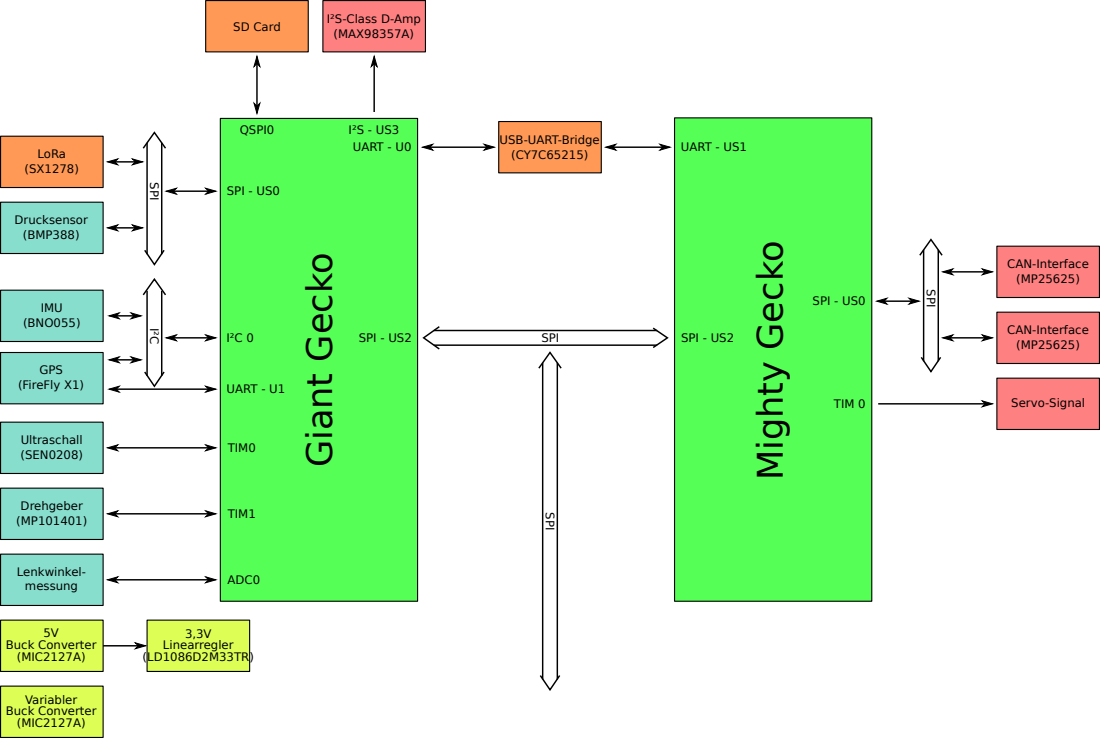
[picture p89: page 1]
IMU (BNO055); Ultraschall (SEN0208); GPS (FireFly X1); Drehgeber (MP101401); Giant Gecko; Servo-Signal; I²C; SPI; Drucksensor (BMP388); CAN-Interface (MP25625); SD Card; I²S-Class D-Amp; (MAX98357A); LoRa (SX1278); Variabler Buck Converter (MIC2127A); 5V Buck Converter (MIC2127A); 3,3V Linearregler (LD1086D2M33TR); Mighty Gecko; Lenkwinkel- messung; SPI - US0; TIM 0; SPI - US2; UART - US1; I²C 0; UART - U1; UART - U0; QSPI0; I²S - US3; TIM0; TIM1; ADC0

USB-UART-Bridge
