torbenmehner/Masterarbeit/03_Architektur/gg_software_architecture.pdf

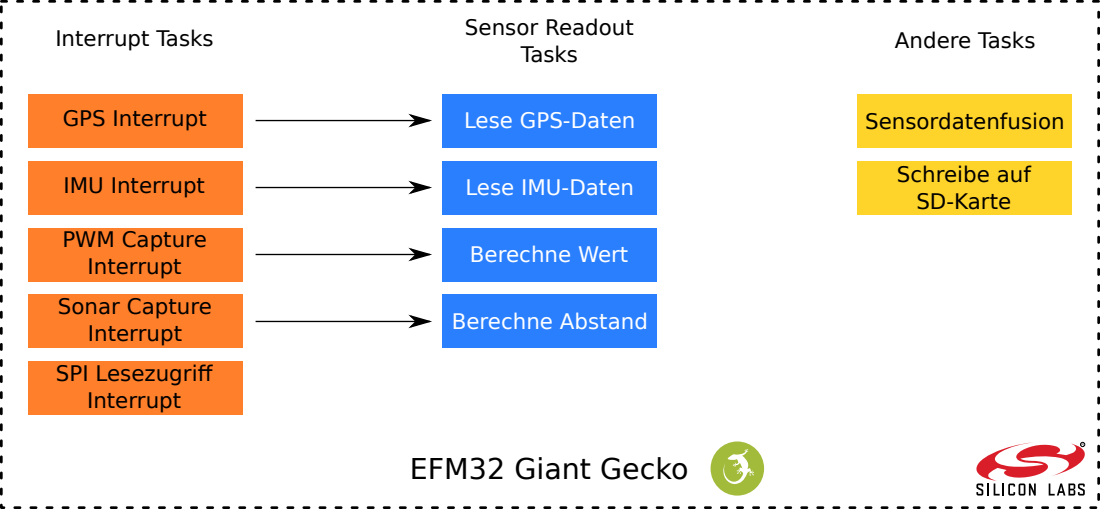
[picture p90: page 1]
Interrupt Tasks; Sensor Readout; Tasks; Andere Tasks; GPS Interrupt; IMU Interrupt; PWM Capture Interrupt; Sonar Capture Interrupt; SPI Lesezugriff Interrupt; Berechne Wert; Berechne Abstand; Sensordatenfusion; Schreibe auf SD-Karte; EFM32 Giant Gecko

Lese GPS-Daten

Lese IMU-Daten
