torbenmehner/Masterarbeit/06_Zwischenvortrag/aufgaben2.pdf

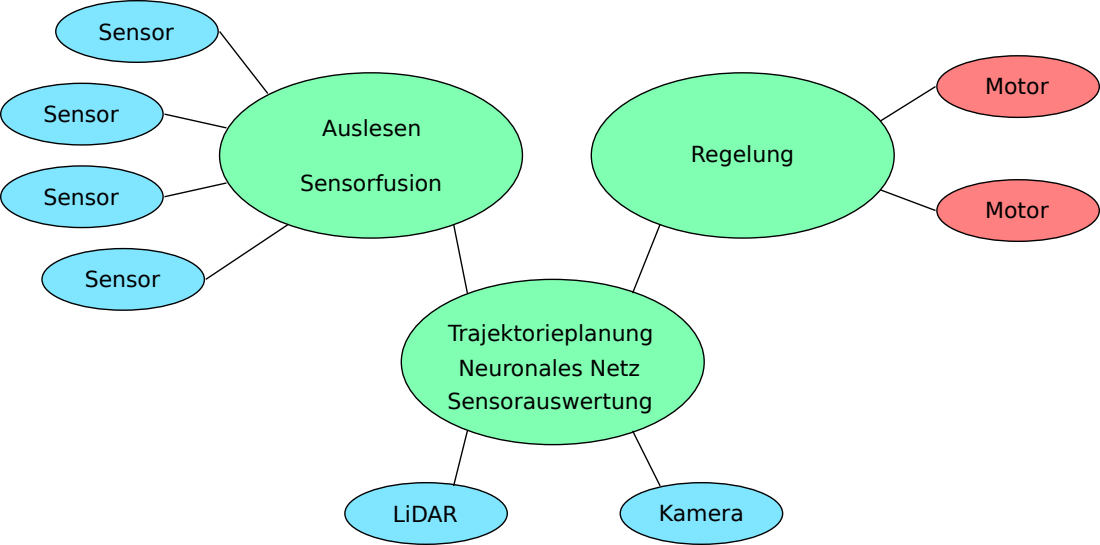
[picture p91: page 1]
Sensor; Motor; Auslesen; Sensorfusion; Regelung; Trajektorieplanung Neuronales Netz Sensorauswertung; LiDAR; Kamera
