torbenmehner/Masterarbeit/06_Zwischenvortrag/aufgaben_mcu.pdf

MCU | MCU

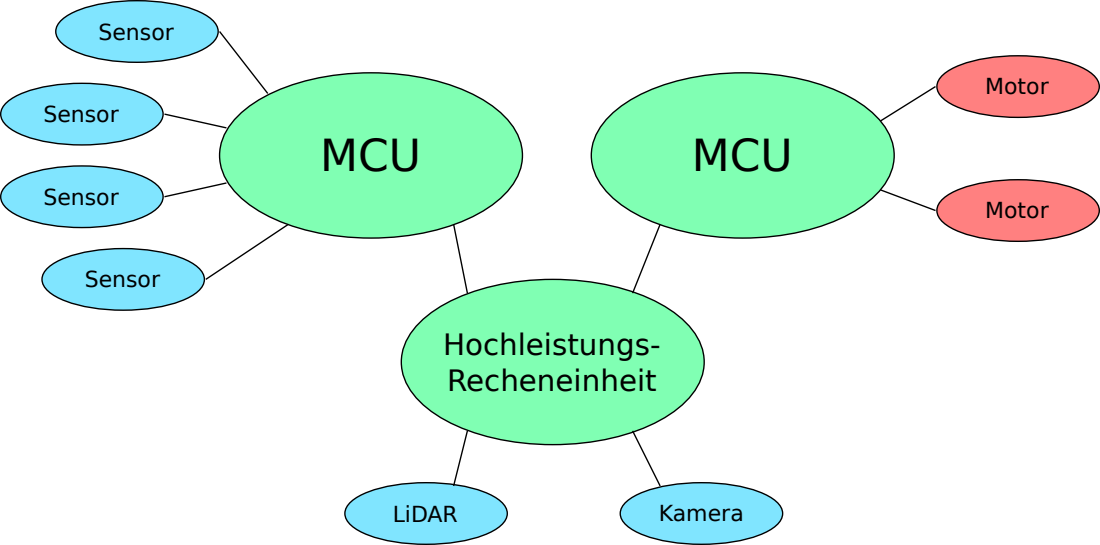
[picture p92: page 1]
Sensor; Motor; LiDAR; Kamera; Hochleistungs- Recheneinheit
