torbenmehner/Masterarbeit/03_Architektur/spezifisches konzept_noimg.pdf

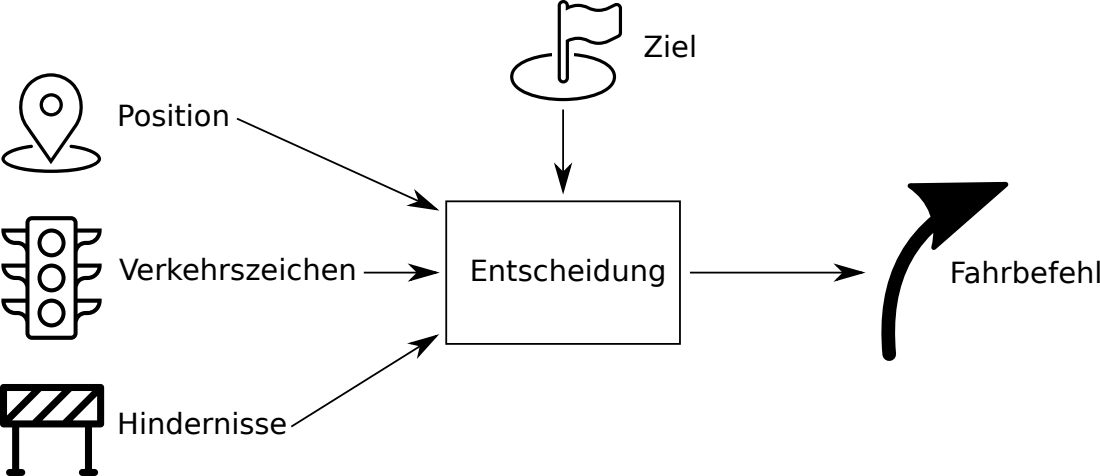
[picture p93: page 1]
Position; Verkehrszeichen; Hindernisse; Entscheidung; Ziel; Fahrbefehl
