torbenmehner/Masterarbeit/06_Zwischenvortrag/selbstlokalisation.pdf

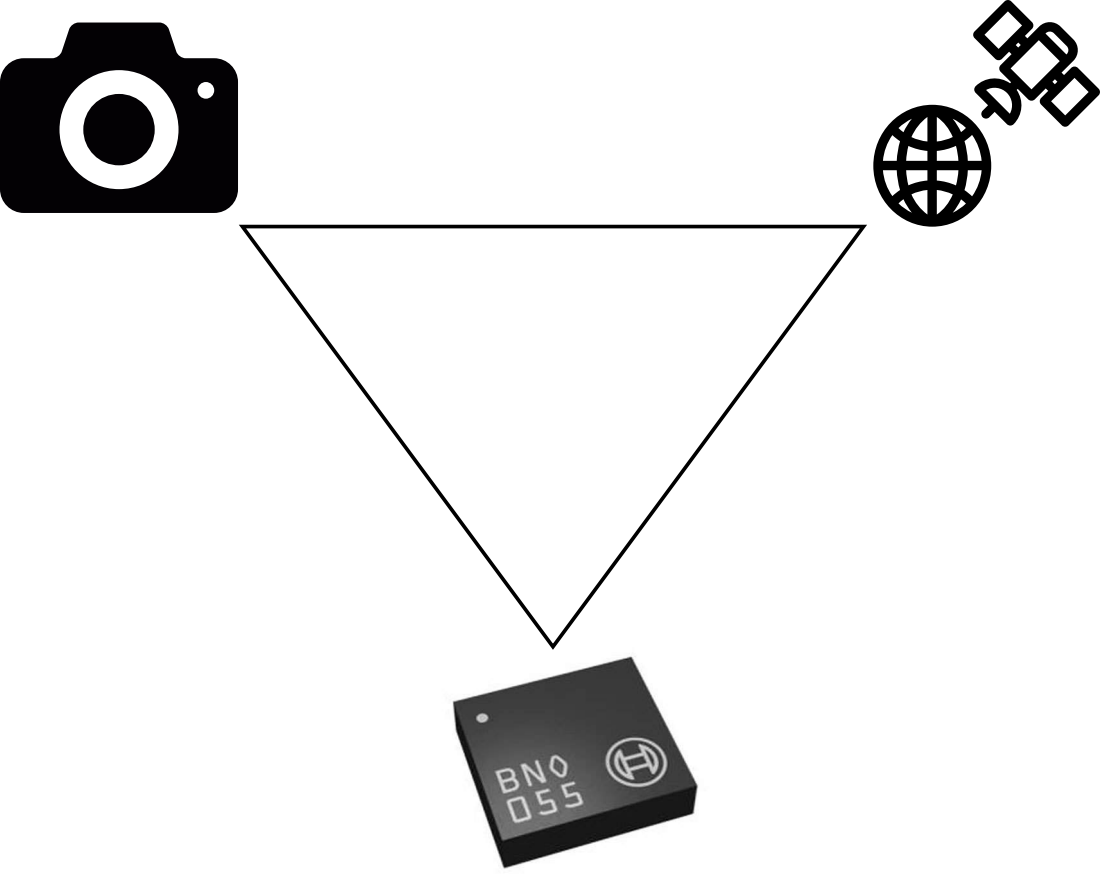
[picture p94: page 1]
