torbenmehner/Masterarbeit/(list of files, drawings)

Other design files:
05_Hardware/ASBB.PrjPcb
05_Hardware/ASBB.SchDoc
05_Hardware/ASBB.SchLib
05_Hardware/ASBB_3VLDO.SchDoc
05_Hardware/ASBB_5VBuck.SchDoc
05_Hardware/ASBB_ADC.SchDoc
05_Hardware/ASBB_BMP388.SchDoc
05_Hardware/ASBB_BNO055.SchDoc
05_Hardware/ASBB_FireflyX1.SchDoc
05_Hardware/ASBB_GiantGecko.SchDoc
05_Hardware/ASBB_GiantGecko_v2.SchDoc
05_Hardware/ASBB_MAX98357.SchDoc
05_Hardware/ASBB_MCP25625.SchDoc
05_Hardware/ASBB_MightyGecko.SchDoc
05_Hardware/ASBB_Servo.SchDoc
05_Hardware/ASBB_ServoIn.SchDoc
05_Hardware/ASBB_Sonar.SchDoc
05_Hardware/ASBB_SPICrossbar.SchDoc
05_Hardware/ASBB_SX1278.SchDoc
05_Hardware/ASBB_USBUART.SchDoc
05_Hardware/ASBB_VarBuck.SchDoc
05_Hardware/ASBB_VIN.SchDoc
05_Hardware/ASBB_WheelSpeed.SchDoc
05_Hardware/ASSB.PcbLib
05_Hardware/ASSB_FireflyX1.SchDoc
05_Hardware/ASSB_VarBuck.SchDoc
