torbenmehner/Masterarbeit/(commit log)

2018-12-11 Rearrangement of Project structure
    [ASBB.PrjPcb, ASBB.SchDoc, ASBB.SchLib, ASBB.ods, ASBB_3VLDO.SchDoc, ASBB_5VBuck.SchDoc, ASBB_ADC.SchDoc, ASBB_BMP388.SchDoc]
2018-12-11 Removed old files
    [ASBB.ods]
